clararodellar/TFG/Electronica_potencia/README.md

# ELECTRÓNICA DE POTENCIA

* **PCB**: tiene los archivos necesarios para poder abrir el diseño de la PCB del puente en H en Eagle.

* **ensayos_motor**: tiene los datos sobre los ensayos realizados al motor para ver la corriente que consume en función de la tensión y de la carga.

* **sensor_encoder_lineal**: incluye los componentes necesarios y páginas donde mirar cómo montar un encoder lineal.

* **CÓMO SABER SI UN TRANSISTOR ESTÁ DAÑADO**: son instrucciones con imagenes para comprobar si un transistor se ha dañado.

Páginas para entender control de puente en H:

[http://panamahitek.com/puente-h-con-control-de-velocidad-por-arduino/](http://panamahitek.com/puente-h-con-control-de-velocidad-por-arduino/)

[http://panamahitek.com/el-puente-h-invirtiendo-el-sentido-de-giro-de-un-motor-con-arduino/](http://panamahitek.com/el-puente-h-invirtiendo-el-sentido-de-giro-de-un-motor-con-arduino/)

Circuito con optoacoplador para relé y mosfet:

[http://www.bristolwatch.com/ele2/mosfet_relay.htm](http://www.bristolwatch.com/ele2/mosfet_relay.htm)
