clararodellar/TFG/Mecanica/README.md

# Parte mecánica

En esta carpeta se incluye todo lo que tiene que ver con la parte mecánica del proyecto.

* **FreeCAD**: en esta carpeta están los archivos .FCStd que se abren con la herramienta de FreeCAD

* **stl**: piezas en extensión .stl para poder imprimirlas

* **tornillo_DIN912**: word con las medidas de estos tornillos (con los que se ha trabajado la pieza Agarradera_eje_fijo_10)
