clararodellar/TFG/Electronica_control/Codigos/README.md

# CÓDIGOS

Dado que vamos a comparar el control con un Arduino y con una FPGA, están los códigos de cada uno de ellos en las carpetas.
