clararodellar/TFG/Mecanica/stl/README.md

# Piezas para imprimirlas en .stl

* **agarradera_8_abajo**: pieza usada para sujetar el tambor de reenvío en el extremo donde se encuentra el engranaje. Tiene un diámetro de 8 mm, los taladros un diámetro de 3 mm y se trabaja con una tolerancia de 0,8 mm.Es la pieza de abajo.

* **agarradera_8_arriba**: pieza usada para sujetar el tambor de reenvío en el extremo donde se encuentra el engranaje. Tiene un diámetro de 8 mm, los taladros un diámetro de 3 mm y se trabaja con una tolerancia de 0,8 mm. Es la pieza de arriba.

* **agarradera_movil_6_v01**: Esta pieza está diseñada para soportar un eje de diámetro 6 mm con una tolerancia de 0,4 mm de manera que el eje sí pueda girar. Esta pieza se rediseñará como agarradera_8.

* **agarradera_movil_6_v02**: Es la misma pieza que la anterior. La diferencia reside en que el hueco dejado para meter el eje se ha hecho mayor porque en la anterior no entraba bien.

* **agarradera_movil_6_v03**: Volvemos a tener una mejora de la pieza después de probar la anterior. En este caso hemos aumentado la tolerancia tanto de los taladros como del agujero para el eje a 0,8. Además, dado que se ha cambiado el agarre del otro extremo del eje, ahora necesitamos que la pieza tenga mayor altura: 12 mm más,por lo que se le ha añadido un bloque por debajo.

* **agarre_motor**: Esta pieza se diseñó para soportar los extremos libres de los ejes. Pero esto no fijaba el eje sino que permitía el movimiento en el eje de giro. Se diseña la pieza agarradera_movil_6.

* **base_agarradera_movil_03**: Como tenemos dos ejes necesitamos dos piezas de agarradera_movil_6. Dado que la pieza agarradera_movil_6_v02 ya está impresa y puede utilizarse, la aprovecharemos y sólo añadiremos el resalte que necesita para alcanzar la altura y que el eje quede paralelo al suelo.
