clararodellar/TFG/Mecanica/FreeCAD/README.md

# Aquí están las piezas necesarias para el TFG en FCStd

* **agarradera_8**: pieza usada para sujetar el tambor de reenvío en el extremo donde se encuentra el engranaje. Tiene un diámetro de 8 mm, los taladros un diámetro de 3 mm y se trabaja con una tolerancia de 0,8 mm.

* **agarradera_eje_fijo_10**: Esta pieza está diseñada para poder soportar el conjunto de motor y encoder óptico extraídos de la impresora hp deskjet 845c sobre los perfiles de aluminio. Tiene un diámetro de 10 mm con tolerancia 0,4 mm. Los agujeros de los tornillos están preparados para encajar un tornillo tipo DIN912 inluyendo la cabeza.Después de probarla hemos visto una disposición mejor para sujetar el extremo del eje donde va colocado el motor que no necesita pieza.

* **agarre_motor**: Esta pieza se diseñó para soportar los extremos libres de los ejes. Pero esto no fijaba el eje sino que permitía el movimiento en el eje de giro. Se diseña la pieza agarradera_movil_6.

* **agarradera_movil_6_v01**: Esta pieza está diseñada para soportar un eje de diámetro 6 mm con una tolerancia de 0,4 mm de manera que el eje sí pueda girar.

* **agarradera_movil_6_v02**: Es la misma pieza que la anterior. La diferencia reside en que el hueco dejado para meter el eje se ha hecho mayor porque en la anterior no entraba bien.

* **agarradera_movil_6_v03**: Volvemos a tener una mejora de la pieza después de probar la anterior. En este caso hemos aumentado la tolerancia tanto de los taladros como del agujero para el eje a 0,8. Además, dado que se ha cambiado el agarre del otro extremo del eje, ahora necesitamos que la pieza tenga mayor altura: 12 mm más,por lo que se le ha añadido un bloque por debajo. En este fichero está incluido el resalte necesario para el aprovechamiento de la impresión de agarradera_movil_6_v02 ya que necesitamos la pieza por duplicado.

* **prueba_planos**: es una prueba para sacar planos de piezas en FreeCAD
