clararodellar/TFG/Cinta_transportadora/Codigo2/README.md

En esta carpeta están escritos los códigos usados para controlar el montaje.

* motor: controla el encendido y apagado de un motor de corriente continua

* motor_potenciometro: controla la velocidad de un motor a través de un potenciómetro

* motor_puenteH: controla el sentido de giro de un motor por el montaje de puente en H a través de un botón y la velocidad a la que gira a través de un potenciómetro.

Páginas para entender control de puente en H:

[http://panamahitek.com/puente-h-con-control-de-velocidad-por-arduino/](http://panamahitek.com/puente-h-con-control-de-velocidad-por-arduino/)

[http://panamahitek.com/el-puente-h-invirtiendo-el-sentido-de-giro-de-un-motor-con-arduino/](http://panamahitek.com/el-puente-h-invirtiendo-el-sentido-de-giro-de-un-motor-con-arduino/)

* senal_analogica_a_digital: transforma una señal analógica de entrada a una señal digital. Está pensado para el encoder que se encontró en la impresora
