clararodellar/TFG/Cinta_transportadora/Informacion2/README.md

En esta carpeta se recogerá todo tipo de información que se crea necesaria para el trabajo.

Optical_rotary_encoder: dado que busco programar el encoder óptico de una impresora HP Deskjet 845c, en este word hay información copiada de distintas páginas y las páginas de las que se ha sacado sobre gente que ha hecho esto y sus recomendaciones.

Tornillo DIN-912: medidas de estos tornillos (con los que se ha trabajado la pieza Agarradera_eje_fijo_10)

Encoder: información encontrada en un foro sobre el encoder.

---

Circuito con optoacoplador para relé y mosfet:
http://www.bristolwatch.com/ele2/mosfet_relay.htm
