clararodellar/TFG/Cinta_transportadora/Motor2/Conexion_puenteH/README.md

# CIRCUITO DE CONEXION DEL MOTOR CON PUENTE EN H

Para desarrollar el circuito con puente en H nos hemos basado en el siguiente circuito:

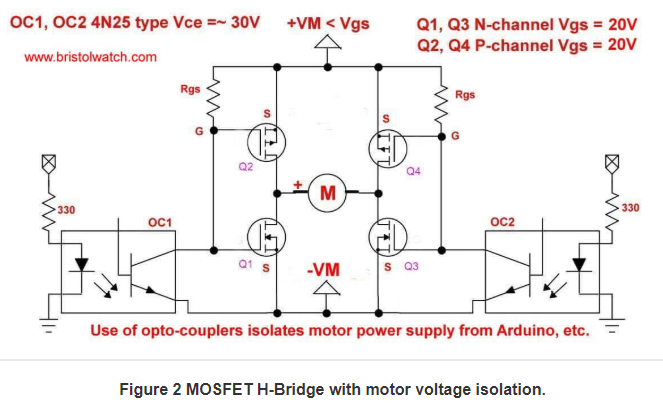
[picture p1: Motor/Conexion_puenteH/conexion_puenteH.PNG]


Quedandonos el siguiente esquema:

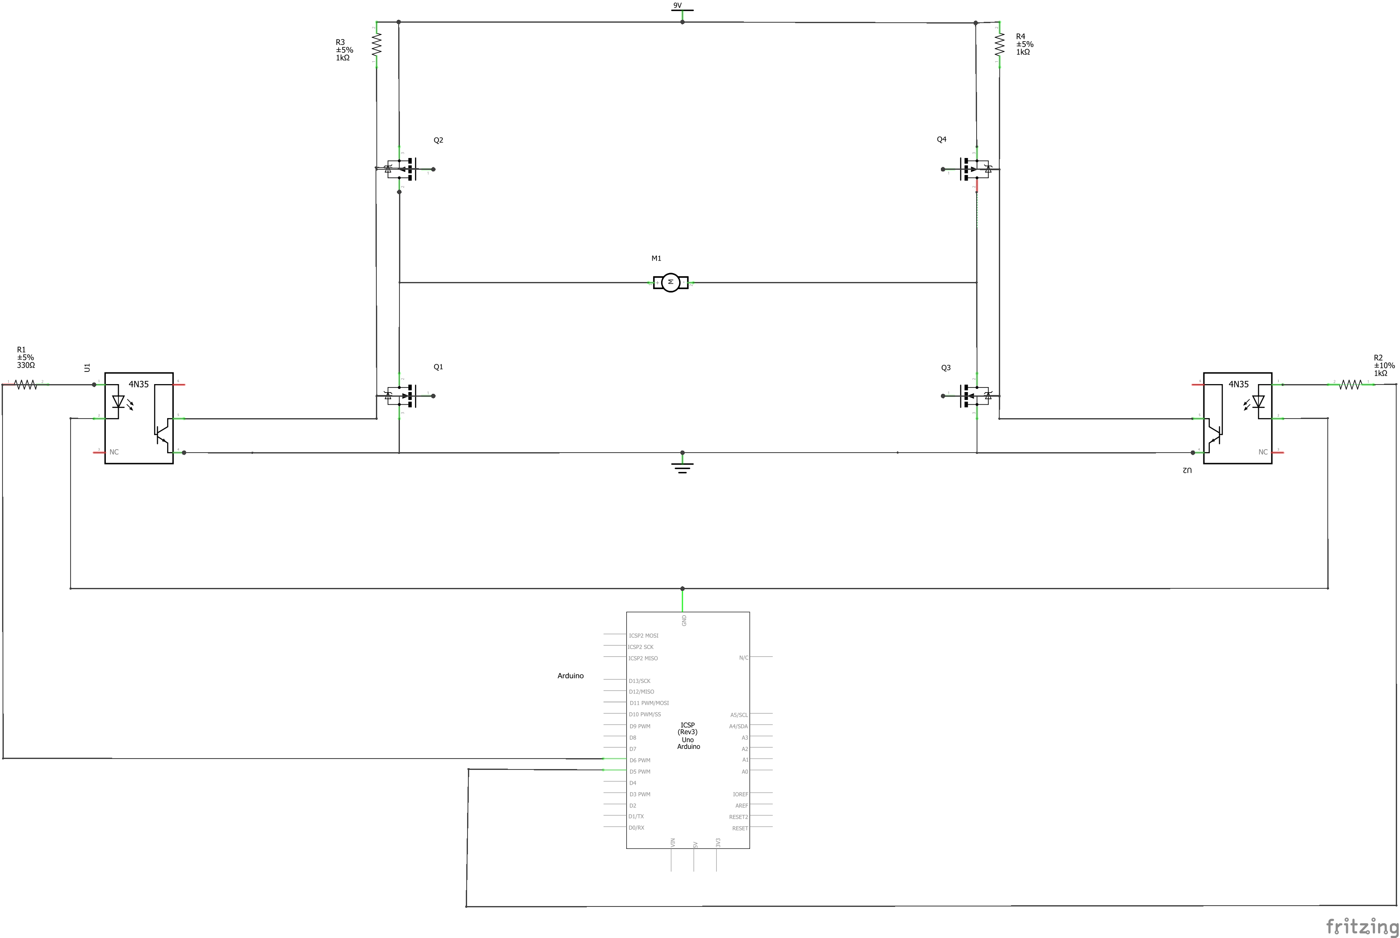
[picture p2: Motor/Conexion_puenteH/esquema_motor_puenteH_v02_esquemático.png]


De la página:

[http://www.bristolwatch.com/ele/h_bridge.htm](http://www.bristolwatch.com/ele/h_bridge.htm)

## Elementos:

* 2 optocopladores tipo 4N35
* 2 transistores irlb8721 canal n (los que se colocan abajo)
* 2 transistores fqp27p06 canal p (los que se colocan arriba)
* Motor reciclado de impresora hp dekjet 845
* Placa de arduino UNO
* Resistencias (330 ohmios, 10000 ohmios??)
* Diodo IN4001?
* Fuente de tensión de corriente continua de 12V?

Otras páginas de interés con otros circuitos y que hablan de los puentes en H son:

[http://www.circuitstoday.com/h-bridge-motor-control-circuit-using-l298](http://www.circuitstoday.com/h-bridge-motor-control-circuit-using-l298)
[https://www.prometec.net/hbridge/](https://www.prometec.net/hbridge/)
