clararodellar/TFG/Cinta_transportadora/Motor2/Conexion_potenciometro/README.md

 
# CIRCUITO DE CONEXION DEL MOTOR CON POTENCIÓMETRO

Este modelo no está probado. El modelo esta hecho con Fritzing

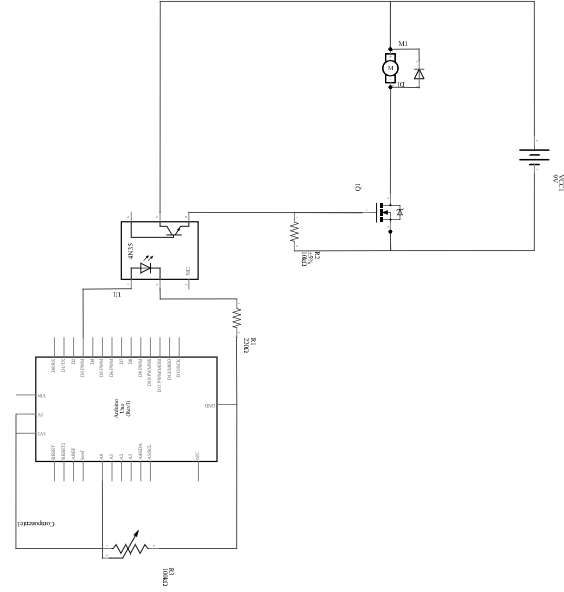
[picture p4: Motor/Conexion_potenciometro/esquema_motor_potenciometro.png]
imagen


## Elementos:
* Octoacoplador 4N35
* Transistor irlb8721
* Motor reciclado de impresora hp dekjet 845
* Placa de arduino UNO
* Diodo IN4001
* Fuente de tensión de corriente continua de 12V
* Resistencias (220 ohmios,10000 ohmios)
* Potenciometro

Consta de un motor reciclado de una impresora. A este se le conecta un diodo con el cátodo en el borne positivo para que durante el funcionamiento no le pase corriente y cuando se desconecte el motor podrá descargarse con el diodo. El uso del octoacoplador es para aislar eléctricamente el circuito de mando y el de potencia externa. El uso del transistor es para alcanzar la potencia necesaria que Arduino no es capaz de suministrar. Con el potenciometro y el codigo adecuado de Arduino sirve para controlar la velocidad del motor.
