clararodellar/TFG/Cinta_transportadora/Motor22/Ensayos_motor/README.md

# Ensayos al motor

* Ensayo de rotor libre o de vacío:

    * A 5 V : I = 0,15 A
    * A 12 V : I = 0,2 A

* Ensayo con carga:

    * A 5 V : I = 0,8 A

* Ensayo de rotor bloqueado:

    * A 12 V : I = 1,6 A
