clararodellar/TFG/Memoria/README.md

* **TFG_Clara_Rodellar_ITI**: en este archivo se tiene la memoria de este TFG donde está explicada la solución técnica y las conclusiones del trabajo.
