clararodellar/TFG/Mecanica/tornillo_DIN912.docx

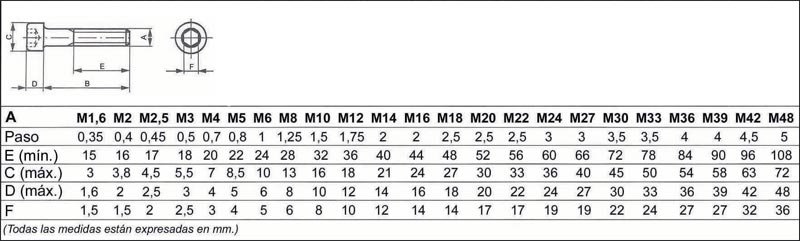
[picture p64: figure]
Resultado de imagen de din 912 dimensiones
