clararodellar/TFG/Electronica_control/Codigos/FPGA/motor_lazo_abierto/juntar_summary.html

juntar Project Status (09/11/2019 - 18:27:44)
Project File: | motor_lazo_abierto.xise | Parser Errors: | No Errors
Module Name: | juntar | Implementation State: | Programming File Generated
Target Device: | xc3s100e-4tq144 | Errors: | No Errors
Product Version: | ISE 14.7 | Warnings: | No Warnings
Design Goal: | Balanced | Routing Results: | All Signals Completely Routed
Design Strategy: | Xilinx Default (unlocked) | Timing Constraints: | All Constraints Met
Environment: | System Settings | Final Timing Score: | 0 (Timing Report)

Device Utilization Summary | | | | | [-]
Logic Utilization | Used | Available | Utilization | Note(s)
Number of Slice Flip Flops | 127 | 1,920 | 6%
Number of 4 input LUTs | 220 | 1,920 | 11%
Number of occupied Slices | 171 | 960 | 17%
Number of Slices containing only related logic | 171 | 171 | 100%
Number of Slices containing unrelated logic | 0 | 171 | 0%
Total Number of 4 input LUTs | 316 | 1,920 | 16%
Number used as logic | 220
Number used as a route-thru | 96
Number of bonded IOBs | 23 | 108 | 21%
IOB Flip Flops | 1
Number of BUFGMUXs | 1 | 24 | 4%
Average Fanout of Non-Clock Nets | 2.88

Performance Summary | | | | [-]
Final Timing Score: | 0 (Setup: 0, Hold: 0) | Pinout Data: | Pinout Report
Routing Results: | All Signals Completely Routed | Clock Data: | Clock Report
Timing Constraints: | All Constraints Met

Detailed Reports | | | | | | [-]
Report Name | Status | Generated | Errors | Warnings | Infos
Synthesis Report | Current | mi. 11. sep. 18:27:15 2019 | 0 | 0 | 1 Info (1 new)
Translation Report | Current | mi. 11. sep. 18:27:20 2019 | 0 | 0 | 0
Map Report | Current | mi. 11. sep. 18:27:25 2019 | 0 | 0 | 2 Infos (2 new)
Place and Route Report | Current | mi. 11. sep. 18:27:34 2019 | 0 | 0 | 2 Infos (2 new)
Power Report
Post-PAR Static Timing Report | Current | mi. 11. sep. 18:27:37 2019 | 0 | 0 | 6 Infos (6 new)
Bitgen Report | Current | mi. 11. sep. 18:27:42 2019 | 0 | 0 | 0

Secondary Reports | | | [-]
Report Name | Status | Generated
WebTalk Report | Current | mi. 11. sep. 18:27:43 2019
WebTalk Log File | Current | mi. 11. sep. 18:27:44 2019

Date Generated: 09/11/2019 - 18:27:44
