clararodellar/TFG/Electronica_control/Codigos/FPGA/motor_lazo_abierto/juntar_envsettings.html

System Settings

Environment Settings
Environment Variable | xst | ngdbuild | map | par
PATHEXT | .COM; .EXE; .BAT; .CMD; .VBS; .VBE; .JS; .JSE; .WSF; .WSH; .MSC | .COM; .EXE; .BAT; .CMD; .VBS; .VBE; .JS; .JSE; .WSF; .WSH; .MSC | .COM; .EXE; .BAT; .CMD; .VBS; .VBE; .JS; .JSE; .WSF; .WSH; .MSC | .COM; .EXE; .BAT; .CMD; .VBS; .VBE; .JS; .JSE; .WSF; .WSH; .MSC

Path

C:\Xilinx\14.7\ISE_DS\ISE\\lib\nt64;
C:\Xilinx\14.7\ISE_DS\ISE\\bin\nt64;
C:\Xilinx\14.7\ISE_DS\ISE\bin\nt64;
C:\Xilinx\14.7\ISE_DS\ISE\lib\nt64;
C:\Xilinx\14.7\ISE_DS\ISE\..\..\..\DocNav;
C:\Xilinx\14.7\ISE_DS\PlanAhead\bin;
C:\Xilinx\14.7\ISE_DS\EDK\bin\nt64;
C:\Xilinx\14.7\ISE_DS\EDK\lib\nt64;
C:\Xilinx\14.7\ISE_DS\EDK\gnu\microblaze\nt\bin;
C:\Xilinx\14.7\ISE_DS\EDK\gnu\powerpc-eabi\nt\bin;
C:\Xilinx\14.7\ISE_DS\EDK\gnuwin\bin;
C:\Xilinx\14.7\ISE_DS\EDK\gnu\arm\nt\bin;
C:\Xilinx\14.7\ISE_DS\EDK\gnu\microblaze\linux_toolchain\nt64_be\bin;
C:\Xilinx\14.7\ISE_DS\EDK\gnu\microblaze\linux_toolchain\nt64_le\bin;
C:\Xilinx\14.7\ISE_DS\common\bin\nt64;
C:\Xilinx\14.7\ISE_DS\common\lib\nt64;
C:\Program Files (x86)\NVIDIA Corporation\PhysX\Common;
C:\Program Files (x86)\Intel\iCLS Client\;
C:\Program Files\Intel\iCLS Client\;
C:\WINDOWS\system32;
C:\WINDOWS;
C:\WINDOWS\System32\Wbem;
C:\WINDOWS\System32\WindowsPowerShell\v1.0\;
C:\Program Files\Intel\Intel(R) Management Engine Components\DAL;
C:\Program Files\Intel\Intel(R) Management Engine Components\IPT;
C:\Program Files (x86)\Intel\Intel(R) Management Engine Components\DAL;
C:\Program Files (x86)\Intel\Intel(R) Management Engine Components\IPT;
C:\WINDOWS\System32\OpenSSH\;
C:\Program Files\Git\cmd;
C:\Users\Clara\AppData\Local\Microsoft\WindowsApps

C:\Xilinx\14.7\ISE_DS\ISE\\lib\nt64;
C:\Xilinx\14.7\ISE_DS\ISE\\bin\nt64;
C:\Xilinx\14.7\ISE_DS\ISE\bin\nt64;
C:\Xilinx\14.7\ISE_DS\ISE\lib\nt64;
C:\Xilinx\14.7\ISE_DS\ISE\..\..\..\DocNav;
C:\Xilinx\14.7\ISE_DS\PlanAhead\bin;
C:\Xilinx\14.7\ISE_DS\EDK\bin\nt64;
C:\Xilinx\14.7\ISE_DS\EDK\lib\nt64;
C:\Xilinx\14.7\ISE_DS\EDK\gnu\microblaze\nt\bin;
C:\Xilinx\14.7\ISE_DS\EDK\gnu\powerpc-eabi\nt\bin;
C:\Xilinx\14.7\ISE_DS\EDK\gnuwin\bin;
C:\Xilinx\14.7\ISE_DS\EDK\gnu\arm\nt\bin;
C:\Xilinx\14.7\ISE_DS\EDK\gnu\microblaze\linux_toolchain\nt64_be\bin;
C:\Xilinx\14.7\ISE_DS\EDK\gnu\microblaze\linux_toolchain\nt64_le\bin;
C:\Xilinx\14.7\ISE_DS\common\bin\nt64;
C:\Xilinx\14.7\ISE_DS\common\lib\nt64;
C:\Program Files (x86)\NVIDIA Corporation\PhysX\Common;
C:\Program Files (x86)\Intel\iCLS Client\;
C:\Program Files\Intel\iCLS Client\;
C:\WINDOWS\system32;
C:\WINDOWS;
C:\WINDOWS\System32\Wbem;
C:\WINDOWS\System32\WindowsPowerShell\v1.0\;
C:\Program Files\Intel\Intel(R) Management Engine Components\DAL;
C:\Program Files\Intel\Intel(R) Management Engine Components\IPT;
C:\Program Files (x86)\Intel\Intel(R) Management Engine Components\DAL;
C:\Program Files (x86)\Intel\Intel(R) Management Engine Components\IPT;
C:\WINDOWS\System32\OpenSSH\;
C:\Program Files\Git\cmd;
C:\Users\Clara\AppData\Local\Microsoft\WindowsApps

C:\Xilinx\14.7\ISE_DS\ISE\\lib\nt64;
C:\Xilinx\14.7\ISE_DS\ISE\\bin\nt64;
C:\Xilinx\14.7\ISE_DS\ISE\bin\nt64;
C:\Xilinx\14.7\ISE_DS\ISE\lib\nt64;
C:\Xilinx\14.7\ISE_DS\ISE\..\..\..\DocNav;
C:\Xilinx\14.7\ISE_DS\PlanAhead\bin;
C:\Xilinx\14.7\ISE_DS\EDK\bin\nt64;
C:\Xilinx\14.7\ISE_DS\EDK\lib\nt64;
C:\Xilinx\14.7\ISE_DS\EDK\gnu\microblaze\nt\bin;
C:\Xilinx\14.7\ISE_DS\EDK\gnu\powerpc-eabi\nt\bin;
C:\Xilinx\14.7\ISE_DS\EDK\gnuwin\bin;
C:\Xilinx\14.7\ISE_DS\EDK\gnu\arm\nt\bin;
C:\Xilinx\14.7\ISE_DS\EDK\gnu\microblaze\linux_toolchain\nt64_be\bin;
C:\Xilinx\14.7\ISE_DS\EDK\gnu\microblaze\linux_toolchain\nt64_le\bin;
C:\Xilinx\14.7\ISE_DS\common\bin\nt64;
C:\Xilinx\14.7\ISE_DS\common\lib\nt64;
C:\Program Files (x86)\NVIDIA Corporation\PhysX\Common;
C:\Program Files (x86)\Intel\iCLS Client\;
C:\Program Files\Intel\iCLS Client\;
C:\WINDOWS\system32;
C:\WINDOWS;
C:\WINDOWS\System32\Wbem;
C:\WINDOWS\System32\WindowsPowerShell\v1.0\;
C:\Program Files\Intel\Intel(R) Management Engine Components\DAL;
C:\Program Files\Intel\Intel(R) Management Engine Components\IPT;
C:\Program Files (x86)\Intel\Intel(R) Management Engine Components\DAL;
C:\Program Files (x86)\Intel\Intel(R) Management Engine Components\IPT;
C:\WINDOWS\System32\OpenSSH\;
C:\Program Files\Git\cmd;
C:\Users\Clara\AppData\Local\Microsoft\WindowsApps

C:\Xilinx\14.7\ISE_DS\ISE\\lib\nt64;
C:\Xilinx\14.7\ISE_DS\ISE\\bin\nt64;
C:\Xilinx\14.7\ISE_DS\ISE\bin\nt64;
C:\Xilinx\14.7\ISE_DS\ISE\lib\nt64;
C:\Xilinx\14.7\ISE_DS\ISE\..\..\..\DocNav;
C:\Xilinx\14.7\ISE_DS\PlanAhead\bin;
C:\Xilinx\14.7\ISE_DS\EDK\bin\nt64;
C:\Xilinx\14.7\ISE_DS\EDK\lib\nt64;
C:\Xilinx\14.7\ISE_DS\EDK\gnu\microblaze\nt\bin;
C:\Xilinx\14.7\ISE_DS\EDK\gnu\powerpc-eabi\nt\bin;
C:\Xilinx\14.7\ISE_DS\EDK\gnuwin\bin;
C:\Xilinx\14.7\ISE_DS\EDK\gnu\arm\nt\bin;
C:\Xilinx\14.7\ISE_DS\EDK\gnu\microblaze\linux_toolchain\nt64_be\bin;
C:\Xilinx\14.7\ISE_DS\EDK\gnu\microblaze\linux_toolchain\nt64_le\bin;
C:\Xilinx\14.7\ISE_DS\common\bin\nt64;
C:\Xilinx\14.7\ISE_DS\common\lib\nt64;
C:\Program Files (x86)\NVIDIA Corporation\PhysX\Common;
C:\Program Files (x86)\Intel\iCLS Client\;
C:\Program Files\Intel\iCLS Client\;
C:\WINDOWS\system32;
C:\WINDOWS;
C:\WINDOWS\System32\Wbem;
C:\WINDOWS\System32\WindowsPowerShell\v1.0\;
C:\Program Files\Intel\Intel(R) Management Engine Components\DAL;
C:\Program Files\Intel\Intel(R) Management Engine Components\IPT;
C:\Program Files (x86)\Intel\Intel(R) Management Engine Components\DAL;
C:\Program Files (x86)\Intel\Intel(R) Management Engine Components\IPT;
C:\WINDOWS\System32\OpenSSH\;
C:\Program Files\Git\cmd;
C:\Users\Clara\AppData\Local\Microsoft\WindowsApps
XILINX | C:\Xilinx\14.7\ISE_DS\ISE\ | C:\Xilinx\14.7\ISE_DS\ISE\ | C:\Xilinx\14.7\ISE_DS\ISE\ | C:\Xilinx\14.7\ISE_DS\ISE\
XILINX_DSP | C:\Xilinx\14.7\ISE_DS\ISE | C:\Xilinx\14.7\ISE_DS\ISE | C:\Xilinx\14.7\ISE_DS\ISE | C:\Xilinx\14.7\ISE_DS\ISE
XILINX_EDK | C:\Xilinx\14.7\ISE_DS\EDK | C:\Xilinx\14.7\ISE_DS\EDK | C:\Xilinx\14.7\ISE_DS\EDK | C:\Xilinx\14.7\ISE_DS\EDK
XILINX_PLANAHEAD | C:\Xilinx\14.7\ISE_DS\PlanAhead | C:\Xilinx\14.7\ISE_DS\PlanAhead | C:\Xilinx\14.7\ISE_DS\PlanAhead | C:\Xilinx\14.7\ISE_DS\PlanAhead

Synthesis Property Settings
Switch Name | Property Name | Value | Default Value
-ifn | | juntar.prj
-ifmt | | mixed | MIXED
-ofn | | juntar
-ofmt | | NGC | NGC
-p | | xc3s100e-4-tq144
-top | | juntar
-opt_mode | Optimization Goal | Speed | SPEED
-opt_level | Optimization Effort | 1 | 1
-iuc | Use synthesis Constraints File | NO | NO
-keep_hierarchy | Keep Hierarchy | No | NO
-netlist_hierarchy | Netlist Hierarchy | As_Optimized | as_optimized
-rtlview | Generate RTL Schematic | Yes | NO
-glob_opt | Global Optimization Goal | AllClockNets | ALLCLOCKNETS
-read_cores | Read Cores | YES | YES
-write_timing_constraints | Write Timing Constraints | NO | NO
-cross_clock_analysis | Cross Clock Analysis | NO | NO
-bus_delimiter | Bus Delimiter | <> | <>
-slice_utilization_ratio | Slice Utilization Ratio | 100 | 100%
-bram_utilization_ratio | BRAM Utilization Ratio | 100 | 100%
-verilog2001 | Verilog 2001 | YES | YES
-fsm_extract | | YES | YES
-fsm_encoding | | Auto | AUTO
-safe_implementation | | No | NO
-fsm_style | | LUT | LUT
-ram_extract | | Yes | YES
-ram_style | | Auto | AUTO
-rom_extract | | Yes | YES
-shreg_extract | | YES | YES
-rom_style | | Auto | AUTO
-auto_bram_packing | | NO | NO
-resource_sharing | | YES | YES
-async_to_sync | | NO | NO
-mult_style | | Auto | AUTO
-iobuf | | YES | YES
-max_fanout | | 500 | 500
-bufg | | 24 | 24
-register_duplication | | YES | YES
-register_balancing | | No | NO
-optimize_primitives | | NO | NO
-use_clock_enable | | Yes | YES
-use_sync_set | | Yes | YES
-use_sync_reset | | Yes | YES
-iob | | Auto | AUTO
-equivalent_register_removal | | YES | YES
-slice_utilization_ratio_maxmargin | | 5 | 0%

Translation Property Settings
Switch Name | Property Name | Value | Default Value
-intstyle | | ise | None
-dd | | _ngo | None
-p | | xc3s100e-tq144-4 | None
-uc | | BasysRevEGeneralYo.ucf | None

Map Property Settings
Switch Name | Property Name | Value | Default Value
-ir | Use RLOC Constraints | OFF | OFF
-cm | Optimization Strategy (Cover Mode) | area | area
-intstyle | | ise | None
-o | | juntar_map.ncd | None
-pr | Pack I/O Registers/Latches into IOBs | off | off
-p | | xc3s100e-tq144-4 | None

Place and Route Property Settings
Switch Name | Property Name | Value | Default Value
-t | | 1 | 1
-intstyle | | ise
-ol | Place & Route Effort Level (Overall) | high | std
-w | | true | false

Operating System Information
Operating System Information | xst | ngdbuild | map | par
CPU Architecture/Speed | Intel(R) Core(TM) i7-4510U CPU @ 2.00GHz/2594 MHz | Intel(R) Core(TM) i7-4510U CPU @ 2.00GHz/2594 MHz | Intel(R) Core(TM) i7-4510U CPU @ 2.00GHz/2594 MHz | Intel(R) Core(TM) i7-4510U CPU @ 2.00GHz/2594 MHz
Host | CLARA | CLARA | CLARA | CLARA
OS Name | Microsoft , 64-bit | Microsoft , 64-bit | Microsoft , 64-bit | Microsoft , 64-bit
OS Release | major release (build 9200) | major release (build 9200) | major release (build 9200) | major release (build 9200)
