clararodellar/TFG/Materiales_fotos/README.md

En esta carpeta se colgarán fotos del trabajo. Entre ellas habrá fotos del montaje y de los componentes usados para saber cuáles son.

El enconder es: 09845 0127

El motor: C6409-60004 (RN951524)
