clararodellar/TFG/Cinta_transportadora/Materiales_fotos2/20180731_130929.jpg

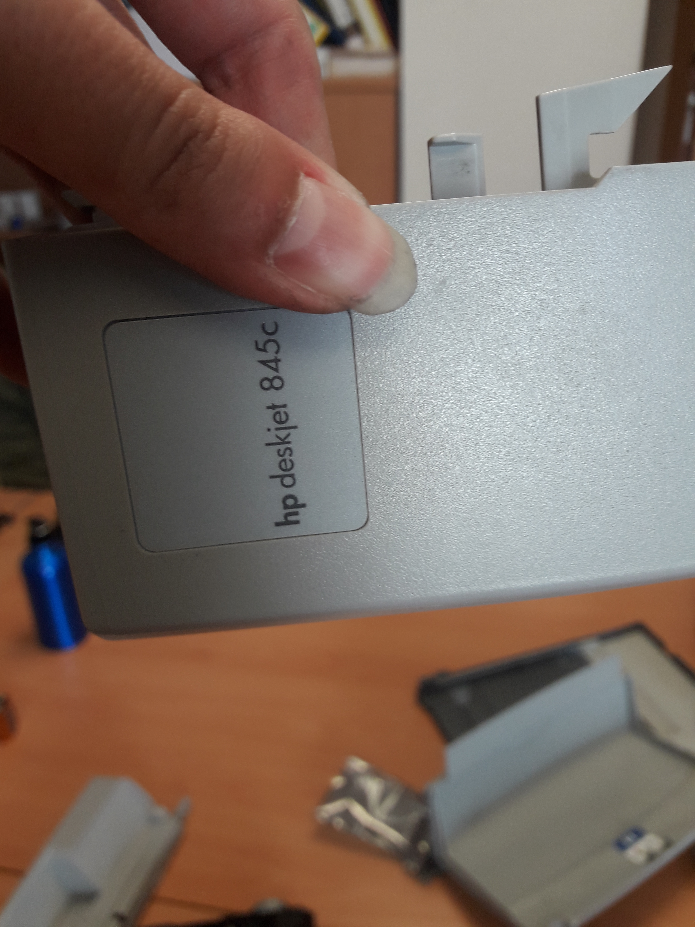
Cinta_transportadora/Materiales_fotos2/20180731_130929.jpg
