clararodellar/TFG/Cinta_transportadora/Materiales_fotos2/20180731_130935.jpg

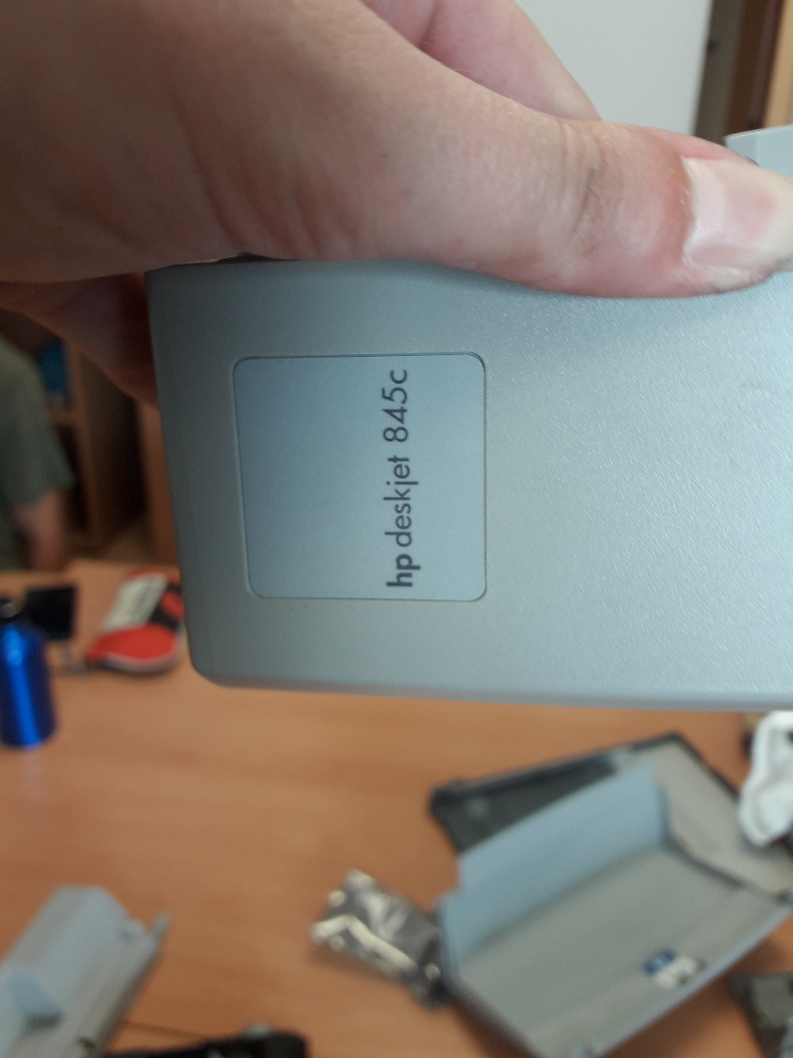
Cinta_transportadora/Materiales_fotos2/20180731_130935.jpg
