clararodellar/TFG/Cinta_transportadora/Materiales_fotos2/20180731_131208.jpg

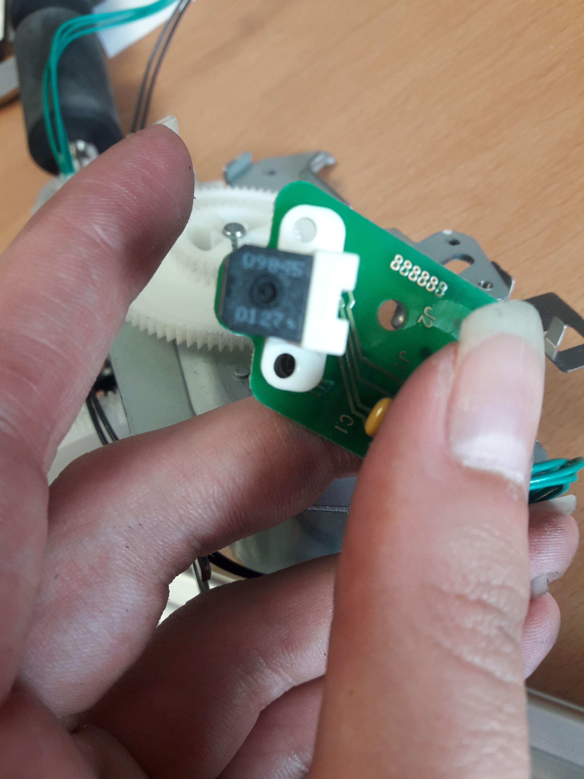
Cinta_transportadora/Materiales_fotos2/20180731_131208.jpg
