clararodellar/TFG/Cinta_transportadora/Materiales_fotos2/20180731_131211.jpg

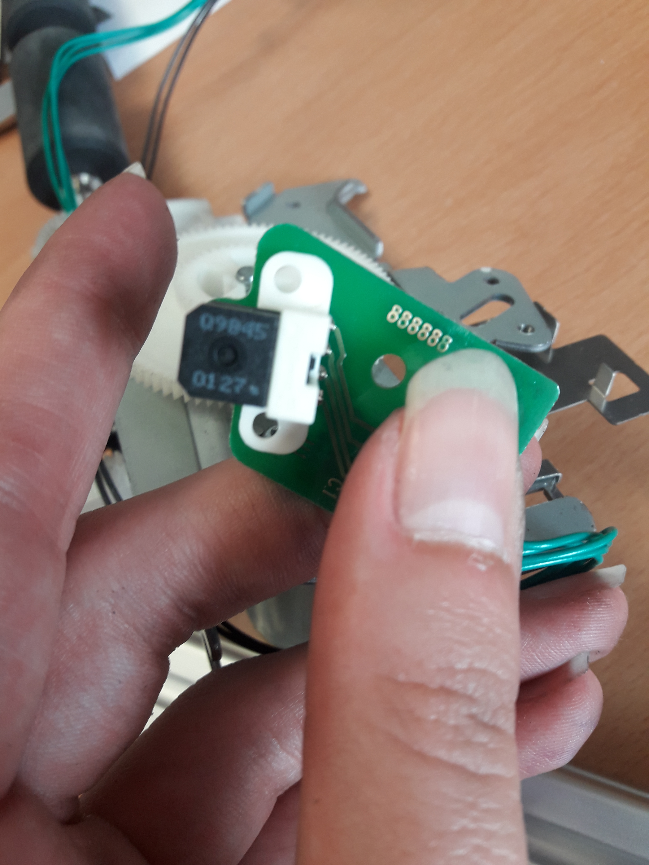
Cinta_transportadora/Materiales_fotos2/20180731_131211.jpg
