clararodellar/TFG/Cinta_transportadora/Materiales_fotos2/20180925_154054.jpg

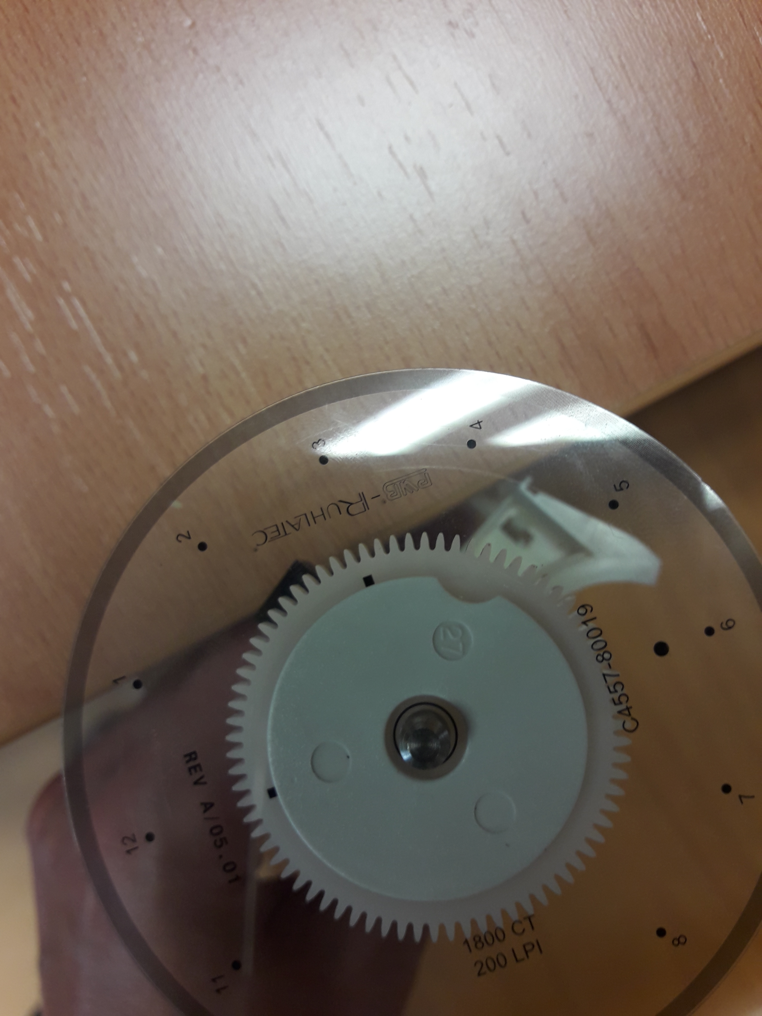
Cinta_transportadora/Materiales_fotos2/20180925_154054.jpg
