clararodellar/TFG/Cinta_transportadora/Materiales_fotos2/20180927_154230.jpg

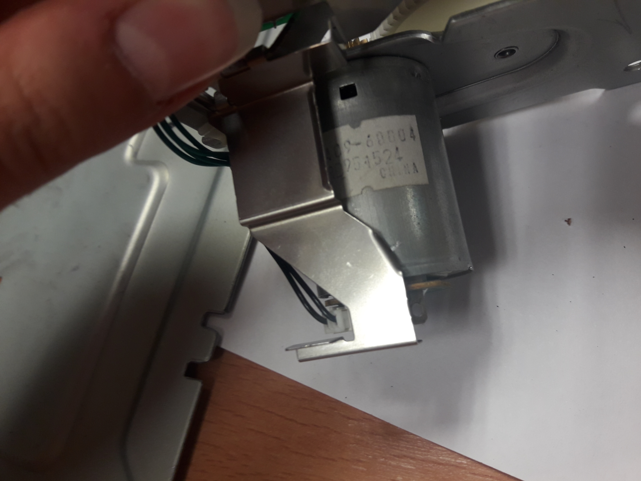
Cinta_transportadora/Materiales_fotos2/20180927_154230.jpg
