clararodellar/TFG/Cinta_transportadora/Materiales_fotos2/20180927_155044.jpg

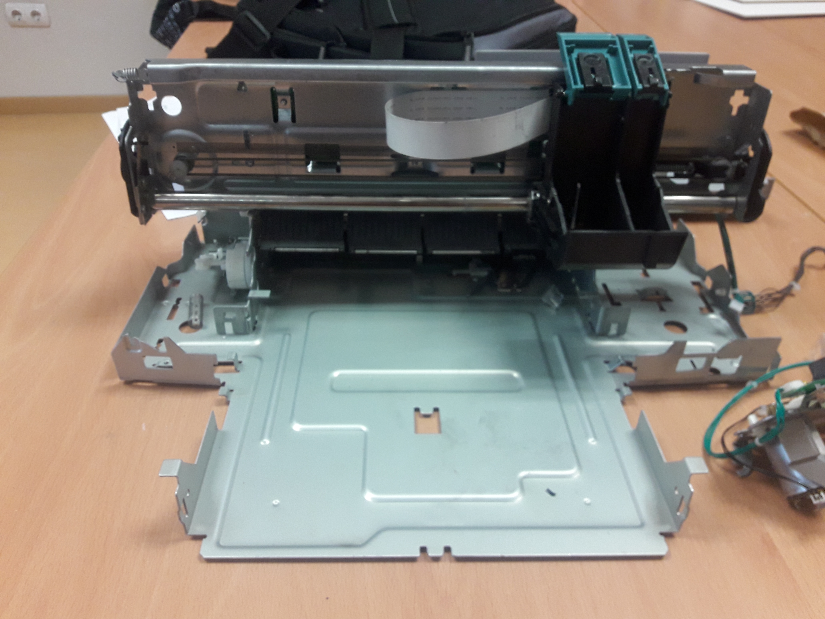
Cinta_transportadora/Materiales_fotos2/20180927_155044.jpg
