clararodellar/TFG/Mecanica/FreeCAD/agarradera_movil_6_v03.FCStd

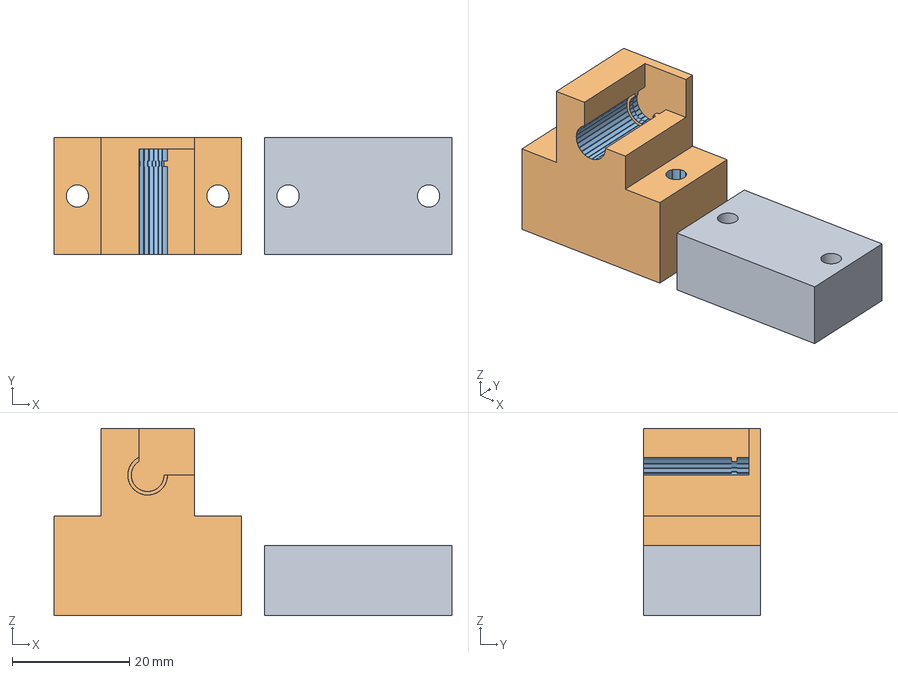
[picture p76: CAD file, 2019-10-11]
Mecanica/FreeCAD/agarradera_movil_6_v03.FCStd
68.0 x 20.0 x 32.0 mm
Base_taladro_2
Pieza_altura
agarradera_movil_v03
