clararodellar/TFG/Mecanica/stl/agarradera_8_abajo.stl

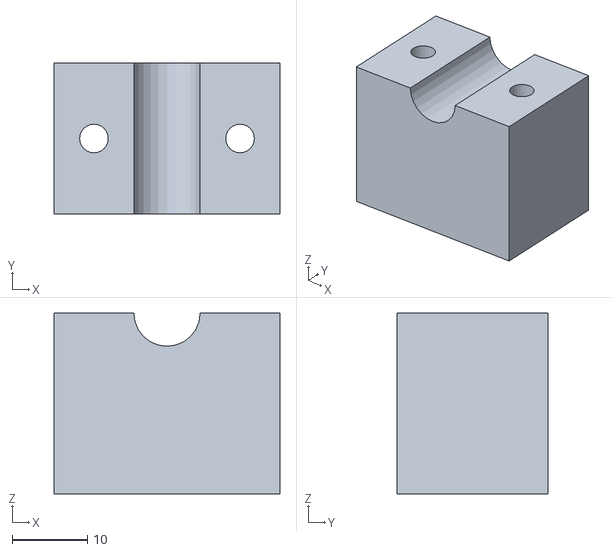
[picture p77: CAD file, 2018-11-26]
Mecanica/stl/agarradera_8_abajo.stl
30.0 x 20.0 x 24.0
