clararodellar/TFG/Mecanica/FreeCAD/agarradera_eje_fijo_10.FCStd

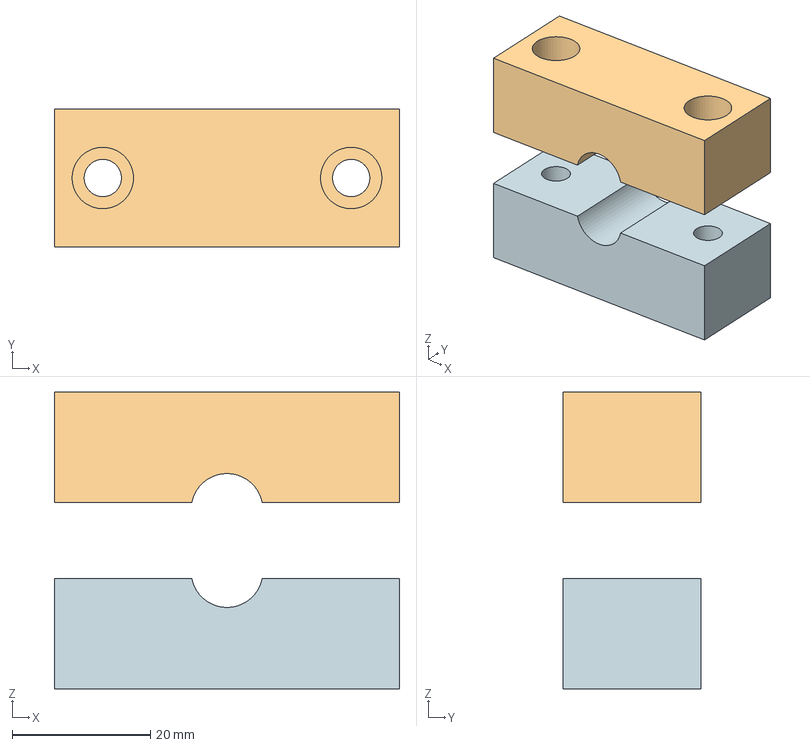
[picture p78: CAD file, 2019-09-15]
Mecanica/FreeCAD/agarradera_eje_fijo_10.FCStd
50.0 x 20.0 x 43.0 mm
Pieza_arriba
Pieza_abajo
