clararodellar/TFG/Mecanica/stl/agarradera_8_arriba.stl

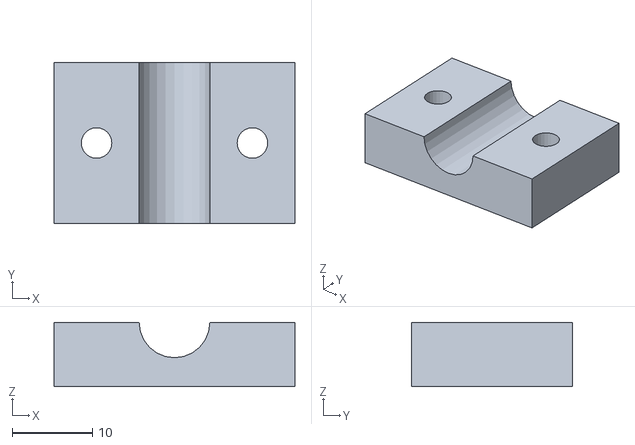
[picture p79: CAD file, 2018-11-26]
Mecanica/stl/agarradera_8_arriba.stl
30.0 x 20.0 x 8.00
