clararodellar/TFG/Mecanica/FreeCAD/agarre_motor.FCStd

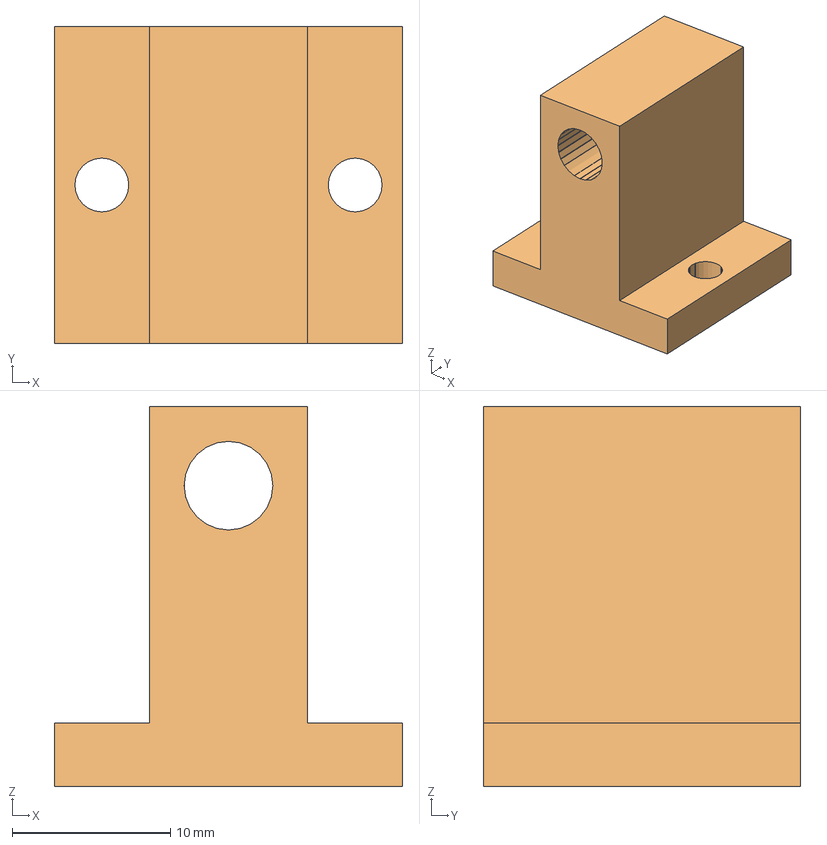
[picture p80: CAD file, 2019-09-15]
Mecanica/FreeCAD/agarre_motor.FCStd
22.0 x 20.0 x 24.0 mm
Pieza_final
Pieza_final (Meshed)
