clararodellar/TFG/Mecanica/stl/base_agarradera_movil_v03.stl

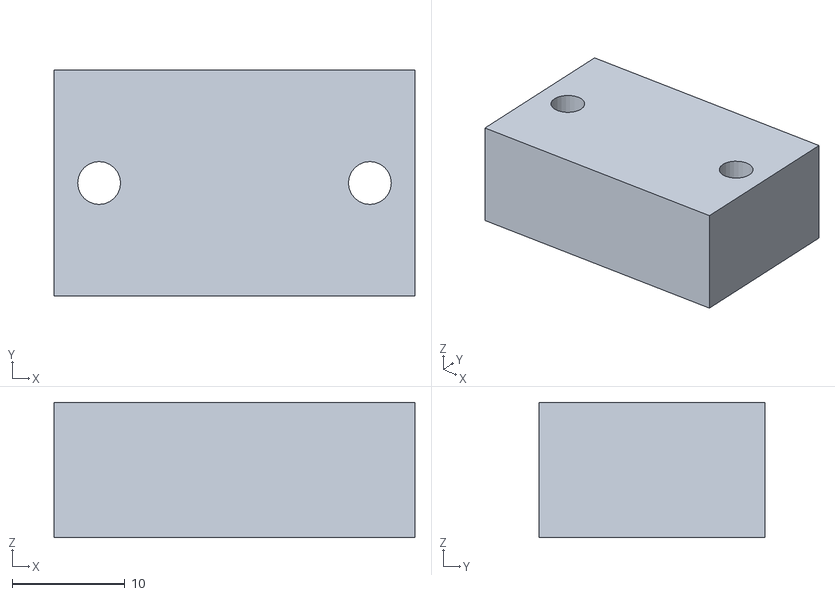
[picture p81: CAD file, 2018-11-26]
Mecanica/stl/base_agarradera_movil_v03.stl
32.0 x 20.0 x 12.0
