clararodellar/TFG/Mecanica/FreeCAD/agarradera_8.FCStd

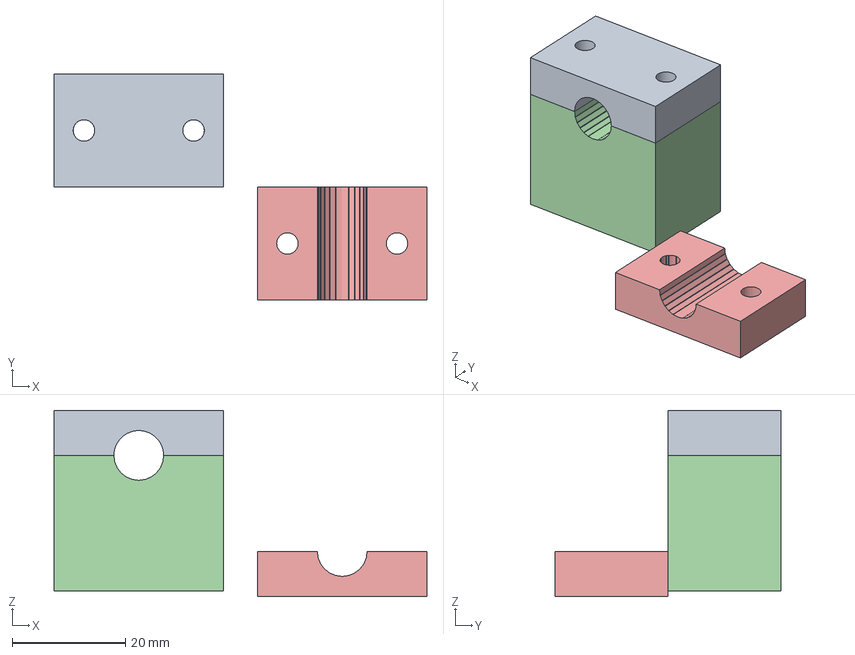
[picture p82: CAD file, 2019-09-15]
Mecanica/FreeCAD/agarradera_8.FCStd
66.0 x 40.0 x 33.0 mm
Base_arriba3
Base_abajo3
Base_arriba3_malla
Base_abajo3 (Meshed)
Base_arriba3_malla (Meshed)
