clararodellar/TFG/Mecanica/FreeCAD/prueba_planos.FCStd

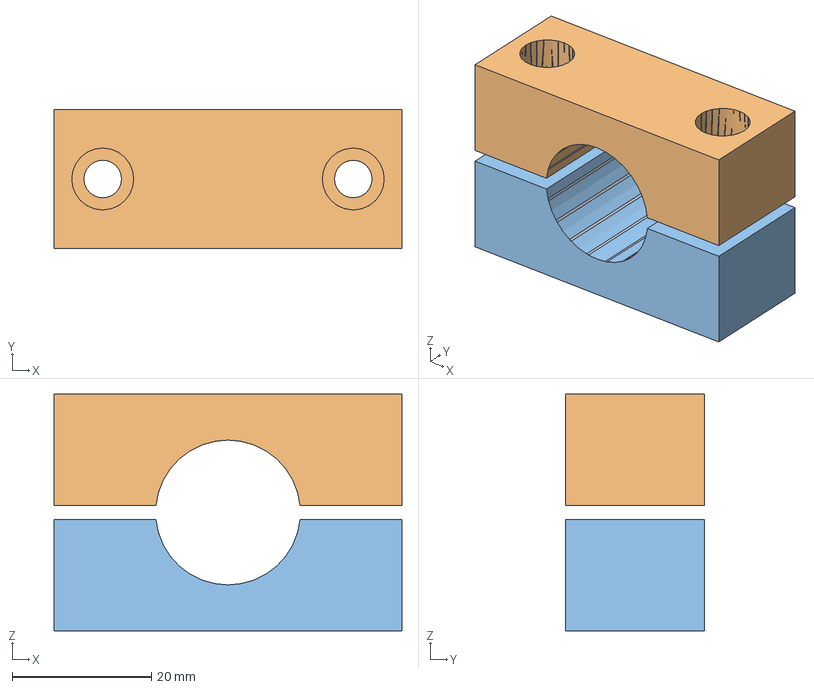
[picture p83: CAD file, 2018-10-25]
Mecanica/FreeCAD/prueba_planos.FCStd
50.0 x 20.0 x 34.0 mm
Pieza_arriba (Meshed)
Pieza_abajo (Meshed)
