clararodellar/TFG/(list of files, cad)

Other CAD files:
Electronica_control/Codigos/FPGA/PWM_prueba_lazocerrado_v3/isim/tb_juntar_isim_beh.exe.sim/work/tb_juntar_isim_beh.exe_main.nt64.obj
Electronica_control/Codigos/FPGA/PWM_prueba_lazocerrado_v3/isim/precompiled.exe.sim/ieee/p_3499444699.nt64.obj
Electronica_control/Codigos/FPGA/PWM_prueba_lazocerrado_v3/isim/precompiled.exe.sim/ieee/p_1242562249.nt64.obj
Electronica_control/Codigos/FPGA/PWM_prueba_lazocerrado_v3/isim/tb_juntar_isim_beh.exe.sim/work/a_1543659282_3212880686.nt64.obj
Electronica_control/Codigos/FPGA/PWM_prueba_lazocerrado_v3/isim/precompiled.exe.sim/ieee/p_2592010699.nt64.obj
Electronica_control/Codigos/FPGA/PWM_prueba_lazocerrado_v3/isim/tb_juntar_isim_beh.exe.sim/work/a_2335869439_3212880686.nt64.obj
Electronica_control/Codigos/FPGA/PWM_prueba_lazocerrado_v3/isim/precompiled.exe.sim/ieee/p_3620187407.nt64.obj
Electronica_control/Codigos/FPGA/PWM_prueba_lazocerrado_v3/isim/tb_juntar_isim_beh.exe.sim/work/a_2536911233_3212880686.nt64.obj
Electronica_control/Codigos/FPGA/PWM_prueba_lazocerrado_v3/isim/tb_juntar_isim_beh.exe.sim/work/a_2943806228_3212880686.nt64.obj
Electronica_control/Codigos/FPGA/PWM_prueba_lazocerrado_v3/isim/tb_juntar_isim_beh.exe.sim/work/a_0055186542_3212880686.nt64.obj
Electronica_control/Codigos/FPGA/PWM_prueba_lazocerrado_v3/isim/tb_juntar_isim_beh.exe.sim/work/a_1209826792_3212880686.nt64.obj
Electronica_control/Codigos/FPGA/PWM_prueba_lazocerrado_v3/isim/tb_juntar_isim_beh.exe.sim/work/a_2483966931_2372691052.nt64.obj
Mecanica/FreeCAD/agarradera_movil_6_v01.FCStd
Mecanica/FreeCAD/agarradera_movil_6_v02.FCStd
Mecanica/stl/agarradera_movil_6.stl
Mecanica/stl/agarradera_movil_6_v02.stl
Mecanica/stl/agarradera_movil_6_v03.stl
Mecanica/stl/agarre_motor.stl
