clararodellar/TFG/Electronica_control/Codigos/FPGA/PWM_prueba_lazocerrado_v3/usage_statistics_webtalk.html

### Device Usage Page (usage_statistics_webtalk.html)

This HTML page displays the device usage statistics that will be sent to Xilinx.

Software Version and Target Device
Product Version: | ISE:14.7 (WebPack) - P.20131013 | Target Family: | Spartan3E
OS Platform: | NT64 | Target Device: | xc3s100e
Project ID (random number) | cd5457f82ff24d9bb826ff461313e1c8.197FF1AB906349C6998659D5E5F932CE.11 | Target Package: | tq144
Registration ID | 211667494_0_0_638 | Target Speed: | -4
Date Generated | 2019-10-11T11:00:39 | Tool Flow | ISE

User Environment
OS Name | Microsoft , 64-bit | OS Release | major release (build 9200)
CPU Name | Intel(R) Core(TM) i7-4510U CPU @ 2.00GHz | CPU Speed | 2594 MHz

Device Usage Statistics
Macro Statistics | Miscellaneous Statistics | Net Statistics | Site Usage

Adders/Subtractors=8

4-bit adder=7

8-bit addsub=1

Comparators=15

16-bit comparator greatequal=1

16-bit comparator greater=1

16-bit comparator lessequal=1

4-bit comparator greater=7

8-bit comparator greater=2

8-bit comparator less=3

Counters=11

10-bit up counter=1

16-bit up counter=1

16-bit updown counter=1

17-bit up counter=1

2-bit up counter=1

26-bit up counter=1

3-bit up counter=2

4-bit up counter=2

8-bit up counter=1

Multiplexers=1

4-bit 4-to-1 multiplexer=1

ROMs=1

16x7-bit ROM=1

Registers=57

Flip-Flops=57

Xors=2

1-bit xor2=2

MiscellaneousStatistics

AGG_BONDED_IO=28

AGG_IO=28

AGG_SLICE=239

NUM_4_INPUT_LUT=410

NUM_BONDED_IBUF=11

NUM_BONDED_IOB=17

NUM_BUFGMUX=1

NUM_CYMUX=138

NUM_IOB_FF=1

NUM_LUT_RT=73

NUM_SLICEL=239

NUM_SLICE_FF=163

NUM_XOR=101

NetStatistics

NumNets_Active=509

NumNets_Gnd=1

NumNets_Vcc=1

NumNodesOfType_Active_CLKPIN=94

NumNodesOfType_Active_CNTRLPIN=154

NumNodesOfType_Active_DOUBLE=615

NumNodesOfType_Active_DUMMY=1065

NumNodesOfType_Active_DUMMYESC=10

NumNodesOfType_Active_GLOBAL=46

NumNodesOfType_Active_HFULLHEX=6

NumNodesOfType_Active_HLONG=3

NumNodesOfType_Active_HUNIHEX=21

NumNodesOfType_Active_INPUT=1205

NumNodesOfType_Active_IOBOUTPUT=10

NumNodesOfType_Active_OMUX=430

NumNodesOfType_Active_OUTPUT=474

NumNodesOfType_Active_PREBXBY=286

NumNodesOfType_Active_VFULLHEX=49

NumNodesOfType_Active_VLONG=11

NumNodesOfType_Active_VUNIHEX=20

NumNodesOfType_Gnd_DOUBLE=1

NumNodesOfType_Gnd_INPUT=5

NumNodesOfType_Gnd_OMUX=4

NumNodesOfType_Gnd_OUTPUT=5

NumNodesOfType_Gnd_PREBXBY=5

SiteStatistics

IBUF-DIFFM=1

IBUF-DIFFMI=1

IBUF-DIFFS=2

IBUF-IOB=2

IOB-DIFFM=9

IOB-DIFFS=7

SLICEL-SLICEM=104

SiteSummary

BUFGMUX=1

BUFGMUX_GCLKMUX=1

BUFGMUX_GCLK_BUFFER=1

IBUF=11

IBUF_INBUF=11

IBUF_PAD=11

IOB=17

IOB_OFF1=1

IOB_OUTBUF=17

IOB_PAD=17

SLICEL=239

SLICEL_C1VDD=6

SLICEL_C2VDD=1

SLICEL_CYMUXF=73

SLICEL_CYMUXG=65

SLICEL_F=206

SLICEL_F5MUX=10

SLICEL_FFX=75

SLICEL_FFY=88

SLICEL_G=204

SLICEL_GNDF=44

SLICEL_GNDG=42

SLICEL_XORF=51

SLICEL_XORG=50

Configuration Data
BUFGMUX S=[S_INV:1] [S:0] BUFGMUX_GCLKMUX DISABLE_ATTR=[LOW:1] S=[S_INV:1] [S:0] IBUF_PAD IOATTRBOX=[LVCMOS25:11] IOB O1=[O1_INV:0] [O1:17] OTCLK1=[OTCLK1_INV:0] [OTCLK1:1] SR=[SR:1] [SR_INV:0] IOB_OFF1 CK=[CK:1] [CK_INV:0] D=[D:1] [D_INV:0] LATCH_OR_FF=[FF:1] OFF1_INIT_ATTR=[INIT0:1] OFF1_SR_ATTR=[SRLOW:1] OFFATTRBOX=[ASYNC:1] SR=[SR:1] [SR_INV:0] | IOB_OUTBUF IN=[IN_INV:0] [IN:17] IOB_PAD DRIVEATTRBOX=[12:17] IOATTRBOX=[LVCMOS25:17] SLEW=[SLOW:17] SLICEL BX=[BX_INV:1] [BX:40] BY=[BY:31] [BY_INV:2] CE=[CE:60] [CE_INV:0] CIN=[CIN_INV:0] [CIN:62] CLK=[CLK:93] [CLK_INV:0] SR=[SR:93] [SR_INV:0] SLICEL_CYMUXF 0=[0:73] [0_INV:0] 1=[1_INV:0] [1:73] | SLICEL_CYMUXG 0=[0:65] [0_INV:0] SLICEL_F5MUX S0=[S0:10] [S0_INV:0] SLICEL_FFX CE=[CE:45] [CE_INV:0] CK=[CK:75] [CK_INV:0] D=[D:74] [D_INV:1] FFX_INIT_ATTR=[INIT0:75] FFX_SR_ATTR=[SRLOW:75] LATCH_OR_FF=[FF:75] SR=[SR:75] [SR_INV:0] SYNC_ATTR=[ASYNC:75] SLICEL_FFY CE=[CE:55] [CE_INV:0] CK=[CK:88] [CK_INV:0] D=[D:86] [D_INV:2] FFY_INIT_ATTR=[INIT0:88] FFY_SR_ATTR=[SRLOW:88] LATCH_OR_FF=[FF:88] REV=[REV_INV:0] [REV:8] SR=[SR:88] [SR_INV:0] SYNC_ATTR=[ASYNC:88] | SLICEL_XORF 1=[1_INV:0] [1:51]

Pin Data
BUFGMUX I0=1 O=1 S=1 BUFGMUX_GCLKMUX I0=1 OUT=1 S=1 BUFGMUX_GCLK_BUFFER IN=1 OUT=1 IBUF I=11 PAD=11 IBUF_INBUF IN=11 OUT=11 IBUF_PAD PAD=11 IOB O1=17 OTCLK1=1 PAD=17 SR=1 IOB_OFF1 CK=1 D=1 Q=1 SR=1 | IOB_OUTBUF IN=17 OUT=17 IOB_PAD PAD=17 SLICEL BX=41 BY=33 CE=60 CIN=62 CLK=93 COUT=65 F1=206 F2=161 F3=95 F4=73 G1=204 G2=162 G3=97 G4=65 SR=93 X=127 XB=2 XQ=75 Y=112 YQ=88 | SLICEL_C1VDD 1=6 SLICEL_C2VDD 1=1 SLICEL_CYMUXF 0=73 1=73 OUT=73 S0=73 SLICEL_CYMUXG 0=65 1=65 OUT=65 S0=65 SLICEL_F A1=206 A2=161 A3=95 A4=73 D=206 SLICEL_F5MUX F=10 G=10 OUT=10 S0=10 SLICEL_FFX CE=45 CK=75 D=75 Q=75 SR=75 | SLICEL_FFY CE=55 CK=88 D=88 Q=88 REV=8 SR=88 SLICEL_G A1=204 A2=162 A3=97 A4=65 D=204 SLICEL_GNDF 0=44 SLICEL_GNDG 0=42 SLICEL_XORF 0=51 1=51 O=51 SLICEL_XORG 0=50 1=50 O=50

Tool Usage

Command Line History

xst -intstyle ise -ifn <ise_file>

xst -intstyle ise -ifn <ise_file>

xst -intstyle ise -ifn <ise_file>

xst -intstyle ise -ifn <ise_file>

ngdbuild -intstyle ise -dd _ngo -nt timestamp -uc <fname>.ucf -p xc3s100e-tq144-4 <fname>.ngc <fname>.ngd

map -intstyle ise -p xc3s100e-tq144-4 -cm area -ir off -pr off -c 100 -o <fname>.ncd <fname>.ngd <fname>.pcf

par -w -intstyle ise -ol high -t 1 <fname>.ncd <fname>.ncd <fname>.pcf

trce -intstyle ise -v 3 -s 4 -n 3 -fastpaths -xml <fname>.twx <fname>.ncd -o <fname>.twr <fname>.pcf -ucf <fname>.ucf

bitgen -intstyle ise -f <fname>.ut <fname>.ncd

xst -intstyle ise -ifn <ise_file>

xst -intstyle ise -ifn <ise_file>

ngdbuild -intstyle ise -dd _ngo -nt timestamp -uc <fname>.ucf -p xc3s100e-tq144-4 <fname>.ngc <fname>.ngd

map -intstyle ise -p xc3s100e-tq144-4 -cm area -ir off -pr off -c 100 -o <fname>.ncd <fname>.ngd <fname>.pcf

par -w -intstyle ise -ol high -t 1 <fname>.ncd <fname>.ncd <fname>.pcf

trce -intstyle ise -v 3 -s 4 -n 3 -fastpaths -xml <fname>.twx <fname>.ncd -o <fname>.twr <fname>.pcf -ucf <fname>.ucf

bitgen -intstyle ise -f <fname>.ut <fname>.ncd

xst -intstyle ise -ifn <ise_file>

ngdbuild -intstyle ise -dd _ngo -nt timestamp -uc <fname>.ucf -p xc3s100e-tq144-4 <fname>.ngc <fname>.ngd

map -intstyle ise -p xc3s100e-tq144-4 -cm area -ir off -pr off -c 100 -o <fname>.ncd <fname>.ngd <fname>.pcf

par -w -intstyle ise -ol high -t 1 <fname>.ncd <fname>.ncd <fname>.pcf

bitgen -intstyle ise -f <fname>.ut <fname>.ncd

xst -intstyle ise -ifn <ise_file>

ngdbuild -intstyle ise -dd _ngo -nt timestamp -uc <fname>.ucf -p xc3s100e-tq144-4 <fname>.ngc <fname>.ngd

map -intstyle ise -p xc3s100e-tq144-4 -cm area -ir off -pr off -c 100 -o <fname>.ncd <fname>.ngd <fname>.pcf

par -w -intstyle ise -ol high -t 1 <fname>.ncd <fname>.ncd <fname>.pcf

trce -intstyle ise -v 3 -s 4 -n 3 -fastpaths -xml <fname>.twx <fname>.ncd -o <fname>.twr <fname>.pcf -ucf <fname>.ucf

bitgen -intstyle ise -f <fname>.ut <fname>.ncd

xst -intstyle ise -ifn <ise_file>

ngdbuild -intstyle ise -dd _ngo -nt timestamp -uc <fname>.ucf -p xc3s100e-tq144-4 <fname>.ngc <fname>.ngd

map -intstyle ise -p xc3s100e-tq144-4 -cm area -ir off -pr off -c 100 -o <fname>.ncd <fname>.ngd <fname>.pcf

par -w -intstyle ise -ol high -t 1 <fname>.ncd <fname>.ncd <fname>.pcf

trce -intstyle ise -v 3 -s 4 -n 3 -fastpaths -xml <fname>.twx <fname>.ncd -o <fname>.twr <fname>.pcf -ucf <fname>.ucf

bitgen -intstyle ise -f <fname>.ut <fname>.ncd

xst -intstyle ise -ifn <ise_file>

xst -intstyle ise -ifn <ise_file>

xst -intstyle ise -ifn <ise_file>

xst -intstyle ise -ifn <ise_file>

ngdbuild -intstyle ise -dd _ngo -nt timestamp -uc <fname>.ucf -p xc3s100e-tq144-4 <fname>.ngc <fname>.ngd

map -intstyle ise -p xc3s100e-tq144-4 -cm area -ir off -pr off -c 100 -o <fname>.ncd <fname>.ngd <fname>.pcf

par -w -intstyle ise -ol high -t 1 <fname>.ncd <fname>.ncd <fname>.pcf

trce -intstyle ise -v 3 -s 4 -n 3 -fastpaths -xml <fname>.twx <fname>.ncd -o <fname>.twr <fname>.pcf -ucf <fname>.ucf

bitgen -intstyle ise -f <fname>.ut <fname>.ncd

xst -intstyle ise -ifn <ise_file>

xst -intstyle ise -ifn <ise_file>

xst -intstyle ise -ifn <ise_file>

xst -intstyle ise -ifn <ise_file>

ngdbuild -intstyle ise -dd _ngo -nt timestamp -uc <fname>.ucf -p xc3s100e-tq144-4 <fname>.ngc <fname>.ngd

map -intstyle ise -p xc3s100e-tq144-4 -cm area -ir off -pr off -c 100 -o <fname>.ncd <fname>.ngd <fname>.pcf

par -w -intstyle ise -ol high -t 1 <fname>.ncd <fname>.ncd <fname>.pcf

trce -intstyle ise -v 3 -s 4 -n 3 -fastpaths -xml <fname>.twx <fname>.ncd -o <fname>.twr <fname>.pcf -ucf <fname>.ucf

bitgen -intstyle ise -f <fname>.ut <fname>.ncd

xst -intstyle ise -ifn <ise_file>

xst -intstyle ise -ifn <ise_file>

ngdbuild -intstyle ise -dd _ngo -nt timestamp -uc <fname>.ucf -p xc3s100e-tq144-4 <fname>.ngc <fname>.ngd

map -intstyle ise -p xc3s100e-tq144-4 -cm area -ir off -pr off -c 100 -o <fname>.ncd <fname>.ngd <fname>.pcf

par -w -intstyle ise -ol high -t 1 <fname>.ncd <fname>.ncd <fname>.pcf

trce -intstyle ise -v 3 -s 4 -n 3 -fastpaths -xml <fname>.twx <fname>.ncd -o <fname>.twr <fname>.pcf -ucf <fname>.ucf

bitgen -intstyle ise -f <fname>.ut <fname>.ncd

ngdbuild -intstyle ise -dd _ngo -nt timestamp -uc <fname>.ucf -p xc3s100e-tq144-4 <fname>.ngc <fname>.ngd

map -intstyle ise -p xc3s100e-tq144-4 -cm area -ir off -pr off -c 100 -o <fname>.ncd <fname>.ngd <fname>.pcf

par -w -intstyle ise -ol high -t 1 <fname>.ncd <fname>.ncd <fname>.pcf

trce -intstyle ise -v 3 -s 4 -n 3 -fastpaths -xml <fname>.twx <fname>.ncd -o <fname>.twr <fname>.pcf -ucf <fname>.ucf

bitgen -intstyle ise -f <fname>.ut <fname>.ncd

xst -intstyle ise -ifn <ise_file>

xst -intstyle ise -ifn <ise_file>

xst -intstyle ise -ifn <ise_file>

xst -intstyle ise -ifn <ise_file>

xst -intstyle ise -ifn <ise_file>

ngdbuild -intstyle ise -dd _ngo -nt timestamp -uc <fname>.ucf -p xc3s100e-tq144-4 <fname>.ngc <fname>.ngd

map -intstyle ise -p xc3s100e-tq144-4 -cm area -ir off -pr off -c 100 -o <fname>.ncd <fname>.ngd <fname>.pcf

par -w -intstyle ise -ol high -t 1 <fname>.ncd <fname>.ncd <fname>.pcf

trce -intstyle ise -v 3 -s 4 -n 3 -fastpaths -xml <fname>.twx <fname>.ncd -o <fname>.twr <fname>.pcf -ucf <fname>.ucf

bitgen -intstyle ise -f <fname>.ut <fname>.ncd

xst -intstyle ise -ifn <ise_file>

ngdbuild -intstyle ise -dd _ngo -nt timestamp -uc <fname>.ucf -p xc3s100e-tq144-4 <fname>.ngc <fname>.ngd

map -intstyle ise -p xc3s100e-tq144-4 -cm area -ir off -pr off -c 100 -o <fname>.ncd <fname>.ngd <fname>.pcf

par -w -intstyle ise -ol high -t 1 <fname>.ncd <fname>.ncd <fname>.pcf

trce -intstyle ise -v 3 -s 4 -n 3 -fastpaths -xml <fname>.twx <fname>.ncd -o <fname>.twr <fname>.pcf -ucf <fname>.ucf

bitgen -intstyle ise -f <fname>.ut <fname>.ncd

fuse

Software Quality
Run Statistics
Program Name | Runs Started | Runs Finished | Errors | Fatal Errors | Internal Errors | Exceptions | Core Dumps
_impact | 336 | 305 | 0 | 0 | 0 | 0 | 0
bitgen | 263 | 261 | 0 | 0 | 0 | 0 | 0
map | 297 | 278 | 0 | 0 | 0 | 0 | 0
ngc2edif | 4 | 4 | 0 | 0 | 0 | 0 | 0
ngdbuild | 307 | 304 | 0 | 0 | 0 | 0 | 0
par | 273 | 273 | 0 | 0 | 0 | 0 | 0
trce | 271 | 271 | 0 | 0 | 0 | 0 | 0
xst | 753 | 745 | 0 | 0 | 0 | 0 | 0

Project Statistics
PROPEXT_xilxSynthMaxFanout_virtex2=100000 | PROP_Enable_Message_Filtering=false
PROP_FitterReportFormat=HTML | PROP_LastAppliedGoal=Balanced
PROP_LastAppliedStrategy=Xilinx Default (unlocked) | PROP_ManualCompileOrderImp=false
PROP_PropSpecInProjFile=Store all values | PROP_SelectedInstanceHierarchicalPath=/tb_juntar
PROP_Simulator=ISim (VHDL/Verilog) | PROP_SynthTopFile=changed
PROP_Top_Level_Module_Type=HDL | PROP_UseSmartGuide=false
PROP_UserConstraintEditorPreference=Text Editor | PROP_intProjectCreationTimestamp=2019-09-18T17:01:35
PROP_intWbtProjectID=197FF1AB906349C6998659D5E5F932CE | PROP_intWbtProjectIteration=11
PROP_intWorkingDirLocWRTProjDir=Same | PROP_intWorkingDirUsed=No
PROP_selectedSimRootSourceNode_behav=work.tb_juntar | PROP_xilxBitgStart_IntDone=true
PROP_AutoTop=true | PROP_DevFamily=Spartan3E
PROP_DevDevice=xc3s100e | PROP_DevFamilyPMName=spartan3e
PROP_DevPackage=tq144 | PROP_Synthesis_Tool=XST (VHDL/Verilog)
PROP_DevSpeed=-4 | PROP_PreferredLanguage=Verilog
FILE_UCF=1 | FILE_VHDL=7

Unisim Statistics
NGDBUILD_PRE_UNISIM_SUMMARY
NGDBUILD_NUM_BUFGP=1 | NGDBUILD_NUM_FDC=64 | NGDBUILD_NUM_FDCE=84 | NGDBUILD_NUM_FDCPE=16
NGDBUILD_NUM_GND=1 | NGDBUILD_NUM_IBUF=9 | NGDBUILD_NUM_INV=17 | NGDBUILD_NUM_LUT1=73
NGDBUILD_NUM_LUT2=131 | NGDBUILD_NUM_LUT3=49 | NGDBUILD_NUM_LUT3_D=5 | NGDBUILD_NUM_LUT4=131
NGDBUILD_NUM_LUT4_D=4 | NGDBUILD_NUM_LUT4_L=3 | NGDBUILD_NUM_MUXCY=138 | NGDBUILD_NUM_MUXF5=10
NGDBUILD_NUM_OBUF=17 | NGDBUILD_NUM_VCC=1 | NGDBUILD_NUM_XORCY=101
NGDBUILD_POST_UNISIM_SUMMARY
NGDBUILD_NUM_BUFG=1 | NGDBUILD_NUM_FDC=64 | NGDBUILD_NUM_FDCE=84 | NGDBUILD_NUM_FDCPE=16
NGDBUILD_NUM_GND=1 | NGDBUILD_NUM_IBUF=10 | NGDBUILD_NUM_IBUFG=1 | NGDBUILD_NUM_INV=17
NGDBUILD_NUM_LUT1=73 | NGDBUILD_NUM_LUT2=131 | NGDBUILD_NUM_LUT3=49 | NGDBUILD_NUM_LUT3_D=5
NGDBUILD_NUM_LUT4=131 | NGDBUILD_NUM_LUT4_D=4 | NGDBUILD_NUM_LUT4_L=3 | NGDBUILD_NUM_MUXCY=138
NGDBUILD_NUM_MUXF5=10 | NGDBUILD_NUM_OBUF=17 | NGDBUILD_NUM_VCC=1 | NGDBUILD_NUM_XORCY=101

XST Command Line Options
XST_OPTION_SUMMARY
-ifn=<fname>.prj | -ifmt=mixed | -ofn=<design_top> | -ofmt=NGC
-p=xc3s100e-4-tq144 | -top=<design_top> | -opt_mode=Speed | -opt_level=1
-iuc=NO | -keep_hierarchy=No | -netlist_hierarchy=As_Optimized | -rtlview=Yes
-glob_opt=AllClockNets | -read_cores=YES | -write_timing_constraints=NO | -cross_clock_analysis=NO
-bus_delimiter=<> | -slice_utilization_ratio=100 | -bram_utilization_ratio=100 | -verilog2001=YES
-fsm_extract=YES | -fsm_encoding=Auto | -safe_implementation=No | -fsm_style=LUT
-ram_extract=Yes | -ram_style=Auto | -rom_extract=Yes | -shreg_extract=YES
-rom_style=Auto | -auto_bram_packing=NO | -resource_sharing=YES | -async_to_sync=NO
-mult_style=Auto | -iobuf=YES | -max_fanout=100000 | -bufg=24
-register_duplication=YES | -register_balancing=No | -optimize_primitives=NO | -use_clock_enable=Yes
-use_sync_set=Yes | -use_sync_reset=Yes | -iob=Auto | -equivalent_register_removal=YES

-slice_utilization_ratio_maxmargin=5

ISim Statistics

Xilinx HDL Libraries Used=ieee

Fuse Resource Usage=765 ms, 37168 KB

Total Signals=127

Total Nets=328

Total Blocks=12

Total Processes=44

Total Simulation Time=120 ms

Simulation Resource Usage=204.438 sec, 4688470 KB

Simulation Mode=gui

Hardware CoSim=0
