clararodellar/TFG/Electronica_control/Codigos/FPGA/motor_lazo_abierto/usage_statistics_webtalk.html

### Device Usage Page (usage_statistics_webtalk.html)

This HTML page displays the device usage statistics that will be sent to Xilinx.

Software Version and Target Device
Product Version: | ISE:14.7 (WebPack) - P.20131013 | Target Family: | Spartan3E
OS Platform: | NT64 | Target Device: | xc3s100e
Project ID (random number) | cd5457f82ff24d9bb826ff461313e1c8.A1829E1526B14BA5BF1D08914A32D16A.1 | Target Package: | tq144
Registration ID | 211667494_0_0_638 | Target Speed: | -4
Date Generated | 2019-09-11T18:27:43 | Tool Flow | ISE

User Environment
OS Name | Microsoft , 64-bit | OS Release | major release (build 9200)
CPU Name | Intel(R) Core(TM) i7-4510U CPU @ 2.00GHz | CPU Speed | 2594 MHz

Device Usage Statistics
Macro Statistics | Miscellaneous Statistics | Net Statistics | Site Usage

Adders/Subtractors=8

4-bit adder=7

8-bit addsub=1

Comparators=12

4-bit comparator greater=7

8-bit comparator greater=2

8-bit comparator less=3

Counters=7

10-bit up counter=1

17-bit up counter=1

2-bit up counter=1

20-bit up counter=2

26-bit up counter=1

8-bit up counter=1

Multiplexers=1

4-bit 4-to-1 multiplexer=1

ROMs=1

16x7-bit ROM=1

Registers=21

Flip-Flops=21

Xors=2

1-bit xor2=2

MiscellaneousStatistics

AGG_BONDED_IO=23

AGG_IO=23

AGG_SLICE=171

NUM_4_INPUT_LUT=316

NUM_BONDED_IBUF=8

NUM_BONDED_IOB=15

NUM_BUFGMUX=1

NUM_CYMUX=122

NUM_IOB_FF=1

NUM_LUT_RT=96

NUM_SLICEL=171

NUM_SLICE_FF=127

NUM_XOR=109

NetStatistics

NumNets_Active=391

NumNets_Gnd=1

NumNets_Vcc=1

NumNodesOfType_Active_CLKPIN=72

NumNodesOfType_Active_CNTRLPIN=107

NumNodesOfType_Active_DOUBLE=544

NumNodesOfType_Active_DUMMY=770

NumNodesOfType_Active_DUMMYESC=8

NumNodesOfType_Active_GLOBAL=35

NumNodesOfType_Active_HFULLHEX=1

NumNodesOfType_Active_HUNIHEX=19

NumNodesOfType_Active_INPUT=866

NumNodesOfType_Active_IOBOUTPUT=8

NumNodesOfType_Active_OMUX=311

NumNodesOfType_Active_OUTPUT=361

NumNodesOfType_Active_PREBXBY=171

NumNodesOfType_Active_VFULLHEX=14

NumNodesOfType_Active_VUNIHEX=15

NumNodesOfType_Vcc_CNTRLPIN=1

NumNodesOfType_Vcc_INPUT=4

NumNodesOfType_Vcc_PREBXBY=3

NumNodesOfType_Vcc_VCCOUT=5

SiteStatistics

IBUF-DIFFMI=1

IBUF-DIFFS=1

IBUF-IOB=2

IOB-DIFFM=8

IOB-DIFFS=6

SLICEL-SLICEM=70

SiteSummary

BUFGMUX=1

BUFGMUX_GCLKMUX=1

BUFGMUX_GCLK_BUFFER=1

IBUF=8

IBUF_INBUF=8

IBUF_PAD=8

IOB=15

IOB_OFF1=1

IOB_OUTBUF=15

IOB_PAD=15

SLICEL=171

SLICEL_C1VDD=6

SLICEL_CYMUXF=65

SLICEL_CYMUXG=57

SLICEL_F=160

SLICEL_F5MUX=13

SLICEL_FFX=61

SLICEL_FFY=66

SLICEL_G=156

SLICEL_GNDF=51

SLICEL_GNDG=50

SLICEL_XORF=55

SLICEL_XORG=54

Configuration Data
BUFGMUX S=[S_INV:1] [S:0] BUFGMUX_GCLKMUX DISABLE_ATTR=[LOW:1] S=[S_INV:1] [S:0] IBUF_PAD IOATTRBOX=[LVCMOS25:8] IOB O1=[O1_INV:0] [O1:15] OTCLK1=[OTCLK1_INV:0] [OTCLK1:1] SR=[SR:1] [SR_INV:0] IOB_OFF1 CK=[CK:1] [CK_INV:0] D=[D:1] [D_INV:0] LATCH_OR_FF=[FF:1] OFF1_INIT_ATTR=[INIT0:1] OFF1_SR_ATTR=[SRLOW:1] OFFATTRBOX=[ASYNC:1] SR=[SR:1] [SR_INV:0] | IOB_OUTBUF IN=[IN_INV:0] [IN:15] IOB_PAD DRIVEATTRBOX=[12:15] IOATTRBOX=[LVCMOS25:15] SLEW=[SLOW:15] SLICEL BX=[BX_INV:0] [BX:28] BY=[BY:7] [BY_INV:1] CE=[CE:19] [CE_INV:20] CIN=[CIN_INV:0] [CIN:56] CLK=[CLK:71] [CLK_INV:0] SR=[SR:67] [SR_INV:0] SLICEL_CYMUXF 0=[0:65] [0_INV:0] 1=[1_INV:0] [1:65] | SLICEL_CYMUXG 0=[0:57] [0_INV:0] SLICEL_F5MUX S0=[S0:13] [S0_INV:0] SLICEL_FFX CE=[CE:12] [CE_INV:20] CK=[CK:61] [CK_INV:0] D=[D:61] [D_INV:0] FFX_INIT_ATTR=[INIT0:61] FFX_SR_ATTR=[SRLOW:61] LATCH_OR_FF=[FF:61] SR=[SR:61] [SR_INV:0] SYNC_ATTR=[ASYNC:41] [SYNC:20] SLICEL_FFY CE=[CE:15] [CE_INV:20] CK=[CK:66] [CK_INV:0] D=[D:65] [D_INV:1] FFY_INIT_ATTR=[INIT0:66] FFY_SR_ATTR=[SRLOW:66] LATCH_OR_FF=[FF:66] SR=[SR:62] [SR_INV:0] SYNC_ATTR=[ASYNC:46] [SYNC:20] | SLICEL_XORF 1=[1_INV:0] [1:55]

Pin Data
BUFGMUX I0=1 O=1 S=1 BUFGMUX_GCLKMUX I0=1 OUT=1 S=1 BUFGMUX_GCLK_BUFFER IN=1 OUT=1 IBUF I=8 PAD=8 IBUF_INBUF IN=8 OUT=8 IBUF_PAD PAD=8 IOB O1=15 OTCLK1=1 PAD=15 SR=1 IOB_OFF1 CK=1 D=1 Q=1 SR=1 | IOB_OUTBUF IN=15 OUT=15 IOB_PAD PAD=15 SLICEL BX=28 BY=8 CE=39 CIN=56 CLK=71 COUT=57 F1=158 F2=106 F3=70 F4=54 G1=156 G2=106 G3=68 G4=50 SR=67 X=96 XB=2 XQ=61 Y=77 YQ=66 | SLICEL_C1VDD 1=6 SLICEL_CYMUXF 0=65 1=65 OUT=65 S0=65 SLICEL_CYMUXG 0=57 1=57 OUT=57 S0=57 SLICEL_F A1=158 A2=106 A3=70 A4=54 D=160 SLICEL_F5MUX F=13 G=13 OUT=13 S0=13 SLICEL_FFX CE=32 CK=61 D=61 Q=61 SR=61 | SLICEL_FFY CE=35 CK=66 D=66 Q=66 SR=62 SLICEL_G A1=156 A2=106 A3=68 A4=50 D=156 SLICEL_GNDF 0=51 SLICEL_GNDG 0=50 SLICEL_XORF 0=55 1=55 O=55 SLICEL_XORG 0=54 1=54 O=54

Tool Usage

Command Line History

xst -intstyle ise -ifn <ise_file>

ngdbuild -intstyle ise -dd _ngo -nt timestamp -uc <fname>.ucf -p xc3s100e-tq144-4 <fname>.ngc <fname>.ngd

map -intstyle ise -p xc3s100e-tq144-4 -cm area -ir off -pr off -c 100 -o <fname>.ncd <fname>.ngd <fname>.pcf

par -w -intstyle ise -ol high -t 1 <fname>.ncd <fname>.ncd <fname>.pcf

trce -intstyle ise -v 3 -s 4 -n 3 -fastpaths -xml <fname>.twx <fname>.ncd -o <fname>.twr <fname>.pcf -ucf <fname>.ucf

bitgen -intstyle ise -f <fname>.ut <fname>.ncd

Software Quality
Run Statistics
Program Name | Runs Started | Runs Finished | Errors | Fatal Errors | Internal Errors | Exceptions | Core Dumps
_impact | 272 | 249 | 0 | 0 | 0 | 0 | 0
bitgen | 227 | 225 | 0 | 0 | 0 | 0 | 0
map | 259 | 240 | 0 | 0 | 0 | 0 | 0
ngdbuild | 268 | 265 | 0 | 0 | 0 | 0 | 0
par | 236 | 236 | 0 | 0 | 0 | 0 | 0
trce | 236 | 236 | 0 | 0 | 0 | 0 | 0
xst | 689 | 681 | 0 | 0 | 0 | 0 | 0

Project Statistics
PROP_Enable_Message_Filtering=false | PROP_FitterReportFormat=HTML
PROP_LastAppliedGoal=Balanced | PROP_LastAppliedStrategy=Xilinx Default (unlocked)
PROP_ManualCompileOrderImp=false | PROP_PropSpecInProjFile=Store all values
PROP_Simulator=ISim (VHDL/Verilog) | PROP_SynthTopFile=changed
PROP_Top_Level_Module_Type=HDL | PROP_UseSmartGuide=false
PROP_UserConstraintEditorPreference=Text Editor | PROP_intProjectCreationTimestamp=2019-09-11T18:23:31
PROP_intWbtProjectID=A1829E1526B14BA5BF1D08914A32D16A | PROP_intWbtProjectIteration=1
PROP_intWorkingDirLocWRTProjDir=Same | PROP_intWorkingDirUsed=No
PROP_AutoTop=true | PROP_DevFamily=Spartan3E
PROP_DevDevice=xc3s100e | PROP_DevFamilyPMName=spartan3e
PROP_DevPackage=tq144 | PROP_Synthesis_Tool=XST (VHDL/Verilog)
PROP_DevSpeed=-4 | PROP_PreferredLanguage=Verilog
FILE_UCF=1 | FILE_VHDL=4

Unisim Statistics
NGDBUILD_PRE_UNISIM_SUMMARY
NGDBUILD_NUM_BUFGP=1 | NGDBUILD_NUM_FDC=61 | NGDBUILD_NUM_FDCE=23 | NGDBUILD_NUM_FDE=4
NGDBUILD_NUM_FDRE=40 | NGDBUILD_NUM_GND=1 | NGDBUILD_NUM_IBUF=7 | NGDBUILD_NUM_INV=9
NGDBUILD_NUM_LUT1=96 | NGDBUILD_NUM_LUT2=74 | NGDBUILD_NUM_LUT3=30 | NGDBUILD_NUM_LUT3_D=4
NGDBUILD_NUM_LUT4=100 | NGDBUILD_NUM_LUT4_D=3 | NGDBUILD_NUM_LUT4_L=1 | NGDBUILD_NUM_MUXCY=122
NGDBUILD_NUM_MUXF5=13 | NGDBUILD_NUM_OBUF=15 | NGDBUILD_NUM_VCC=1 | NGDBUILD_NUM_XORCY=109
NGDBUILD_POST_UNISIM_SUMMARY
NGDBUILD_NUM_BUFG=1 | NGDBUILD_NUM_FDC=61 | NGDBUILD_NUM_FDCE=23 | NGDBUILD_NUM_FDE=4
NGDBUILD_NUM_FDRE=40 | NGDBUILD_NUM_GND=1 | NGDBUILD_NUM_IBUF=7 | NGDBUILD_NUM_IBUFG=1
NGDBUILD_NUM_INV=9 | NGDBUILD_NUM_LUT1=96 | NGDBUILD_NUM_LUT2=74 | NGDBUILD_NUM_LUT3=30
NGDBUILD_NUM_LUT3_D=4 | NGDBUILD_NUM_LUT4=100 | NGDBUILD_NUM_LUT4_D=3 | NGDBUILD_NUM_LUT4_L=1
NGDBUILD_NUM_MUXCY=122 | NGDBUILD_NUM_MUXF5=13 | NGDBUILD_NUM_OBUF=15 | NGDBUILD_NUM_VCC=1

NGDBUILD_NUM_XORCY=109

XST Command Line Options
XST_OPTION_SUMMARY
-ifn=<fname>.prj | -ifmt=mixed | -ofn=<design_top> | -ofmt=NGC
-p=xc3s100e-4-tq144 | -top=<design_top> | -opt_mode=Speed | -opt_level=1
-iuc=NO | -keep_hierarchy=No | -netlist_hierarchy=As_Optimized | -rtlview=Yes
-glob_opt=AllClockNets | -read_cores=YES | -write_timing_constraints=NO | -cross_clock_analysis=NO
-bus_delimiter=<> | -slice_utilization_ratio=100 | -bram_utilization_ratio=100 | -verilog2001=YES
-fsm_extract=YES | -fsm_encoding=Auto | -safe_implementation=No | -fsm_style=LUT
-ram_extract=Yes | -ram_style=Auto | -rom_extract=Yes | -shreg_extract=YES
-rom_style=Auto | -auto_bram_packing=NO | -resource_sharing=YES | -async_to_sync=NO
-mult_style=Auto | -iobuf=YES | -max_fanout=500 | -bufg=24
-register_duplication=YES | -register_balancing=No | -optimize_primitives=NO | -use_clock_enable=Yes
-use_sync_set=Yes | -use_sync_reset=Yes | -iob=Auto | -equivalent_register_removal=YES

-slice_utilization_ratio_maxmargin=5
