clararodellar/TFG/Electronica_control/Codigos/FPGA/prueba_FPGA/usage_statistics_webtalk.html

### Device Usage Page (usage_statistics_webtalk.html)

This HTML page displays the device usage statistics that will be sent to Xilinx.

Software Version and Target Device
Product Version: | ISE:14.7 (WebPack) - P.20131013 | Target Family: | Spartan3E
OS Platform: | NT64 | Target Device: | xc3s100e
Project ID (random number) | cd5457f82ff24d9bb826ff461313e1c8.39D5E1AE095B4F1DA23FEED56505DFA0.2 | Target Package: | tq144
Registration ID | 211667494_0_0_638 | Target Speed: | -4
Date Generated | 2019-09-11T18:22:55 | Tool Flow | ISE

User Environment
OS Name | Microsoft , 64-bit | OS Release | major release (build 9200)
CPU Name | Intel(R) Core(TM) i7-4510U CPU @ 2.00GHz | CPU Speed | 2594 MHz

Device Usage Statistics
Macro Statistics | Miscellaneous Statistics | Net Statistics | Site Usage

Adders/Subtractors=2

17-bit adder=2

Comparators=1

8-bit comparator less=1

Counters=5

10-bit up counter=1

16-bit updown counter=1

17-bit up counter=1

2-bit up counter=1

8-bit up counter=1

Multiplexers=1

4-bit 4-to-1 multiplexer=1

ROMs=1

16x7-bit ROM=1

Registers=4

Flip-Flops=4

MiscellaneousStatistics

AGG_BONDED_IO=17

AGG_IO=17

AGG_SLICE=95

NUM_4_INPUT_LUT=173

NUM_BONDED_IBUF=4

NUM_BONDED_IOB=13

NUM_BUFGMUX=1

NUM_CYMUX=84

NUM_LUT_RT=39

NUM_SLICEL=95

NUM_SLICE_FF=57

NUM_XOR=85

NetStatistics

NumNets_Active=230

NumNets_Gnd=1

NumNets_Vcc=1

NumNodesOfType_Active_CLKPIN=32

NumNodesOfType_Active_CNTRLPIN=48

NumNodesOfType_Active_DOUBLE=189

NumNodesOfType_Active_DUMMY=386

NumNodesOfType_Active_DUMMYESC=4

NumNodesOfType_Active_GLOBAL=24

NumNodesOfType_Active_HFULLHEX=2

NumNodesOfType_Active_HUNIHEX=10

NumNodesOfType_Active_INPUT=444

NumNodesOfType_Active_IOBOUTPUT=4

NumNodesOfType_Active_OMUX=167

NumNodesOfType_Active_OUTPUT=209

NumNodesOfType_Active_PREBXBY=80

NumNodesOfType_Active_VFULLHEX=1

NumNodesOfType_Active_VUNIHEX=8

NumNodesOfType_Gnd_INPUT=6

NumNodesOfType_Gnd_OMUX=6

NumNodesOfType_Gnd_OUTPUT=6

NumNodesOfType_Gnd_PREBXBY=5

SiteStatistics

IBUF-DIFFM=2

IBUF-DIFFS=1

IOB-DIFFM=7

IOB-DIFFS=5

SLICEL-SLICEM=47

SiteSummary

BUFGMUX=1

BUFGMUX_GCLKMUX=1

BUFGMUX_GCLK_BUFFER=1

IBUF=4

IBUF_INBUF=4

IBUF_PAD=4

IOB=13

IOB_OUTBUF=13

IOB_PAD=13

SLICEL=95

SLICEL_C1VDD=7

SLICEL_C2VDD=2

SLICEL_CYMUXF=44

SLICEL_CYMUXG=40

SLICEL_F=88

SLICEL_F5MUX=4

SLICEL_FFX=27

SLICEL_FFY=30

SLICEL_G=85

SLICEL_GNDF=29

SLICEL_GNDG=31

SLICEL_XORF=44

SLICEL_XORG=41

Configuration Data
BUFGMUX S=[S_INV:1] [S:0] BUFGMUX_GCLKMUX DISABLE_ATTR=[LOW:1] S=[S_INV:1] [S:0] IBUF_PAD IOATTRBOX=[LVCMOS25:4] IOB O1=[O1_INV:0] [O1:13] IOB_OUTBUF IN=[IN_INV:0] [IN:13] IOB_PAD DRIVEATTRBOX=[12:13] IOATTRBOX=[LVCMOS25:13] SLEW=[SLOW:13] | SLICEL BX=[BX_INV:0] [BX:12] BY=[BY:2] [BY_INV:0] CE=[CE:16] [CE_INV:0] CIN=[CIN_INV:0] [CIN:40] CLK=[CLK:32] [CLK_INV:0] SR=[SR:32] [SR_INV:0] SLICEL_CYMUXF 0=[0:44] [0_INV:0] 1=[1_INV:0] [1:44] SLICEL_CYMUXG 0=[0:40] [0_INV:0] | SLICEL_F5MUX S0=[S0:4] [S0_INV:0] SLICEL_FFX CE=[CE:13] [CE_INV:0] CK=[CK:27] [CK_INV:0] D=[D:27] [D_INV:0] FFX_INIT_ATTR=[INIT0:27] FFX_SR_ATTR=[SRLOW:27] LATCH_OR_FF=[FF:27] SR=[SR:27] [SR_INV:0] SYNC_ATTR=[ASYNC:27] | SLICEL_FFY CE=[CE:15] [CE_INV:0] CK=[CK:30] [CK_INV:0] D=[D:30] [D_INV:0] FFY_INIT_ATTR=[INIT0:30] FFY_SR_ATTR=[SRLOW:30] LATCH_OR_FF=[FF:30] SR=[SR:30] [SR_INV:0] SYNC_ATTR=[ASYNC:30] SLICEL_XORF 1=[1_INV:0] [1:44]

Pin Data
BUFGMUX I0=1 O=1 S=1 BUFGMUX_GCLKMUX I0=1 OUT=1 S=1 BUFGMUX_GCLK_BUFFER IN=1 OUT=1 IBUF I=4 PAD=4 IBUF_INBUF IN=4 OUT=4 IBUF_PAD PAD=4 IOB O1=13 PAD=13 IOB_OUTBUF IN=13 OUT=13 IOB_PAD PAD=13 SLICEL BX=12 BY=2 CE=16 CIN=40 CLK=32 COUT=40 F1=87 F2=51 F3=31 F4=25 G1=85 G2=52 G3=32 G4=22 SR=32 X=59 XB=1 XQ=27 Y=51 YQ=30 | SLICEL_C1VDD 1=7 SLICEL_C2VDD 1=2 SLICEL_CYMUXF 0=44 1=44 OUT=44 S0=44 SLICEL_CYMUXG 0=40 1=40 OUT=40 S0=40 SLICEL_F A1=87 A2=51 A3=31 A4=25 D=88 SLICEL_F5MUX F=4 G=4 OUT=4 S0=4 SLICEL_FFX CE=13 CK=27 D=27 Q=27 SR=27 | SLICEL_FFY CE=15 CK=30 D=30 Q=30 SR=30 SLICEL_G A1=85 A2=52 A3=32 A4=22 D=85 SLICEL_GNDF 0=29 SLICEL_GNDG 0=31 SLICEL_XORF 0=44 1=44 O=44 SLICEL_XORG 0=41 1=41 O=41

Tool Usage

Command Line History

xst -intstyle ise -ifn <ise_file>

ngdbuild -intstyle ise -dd _ngo -nt timestamp -uc <fname>.ucf -p xc3s100e-tq144-4 <fname>.ngc <fname>.ngd

map -intstyle ise -p xc3s100e-tq144-4 -cm area -ir off -pr off -c 100 -o <fname>.ncd <fname>.ngd <fname>.pcf

par -w -intstyle ise -ol high -t 1 <fname>.ncd <fname>.ncd <fname>.pcf

trce -intstyle ise -v 3 -s 4 -n 3 -fastpaths -xml <fname>.twx <fname>.ncd -o <fname>.twr <fname>.pcf -ucf <fname>.ucf

bitgen -intstyle ise -f <fname>.ut <fname>.ncd

xst -intstyle ise -ifn <ise_file>

ngdbuild -intstyle ise -dd _ngo -nt timestamp -uc <fname>.ucf -p xc3s100e-tq144-4 <fname>.ngc <fname>.ngd

map -intstyle ise -p xc3s100e-tq144-4 -cm area -ir off -pr off -c 100 -o <fname>.ncd <fname>.ngd <fname>.pcf

par -w -intstyle ise -ol high -t 1 <fname>.ncd <fname>.ncd <fname>.pcf

trce -intstyle ise -v 3 -s 4 -n 3 -fastpaths -xml <fname>.twx <fname>.ncd -o <fname>.twr <fname>.pcf -ucf <fname>.ucf

bitgen -intstyle ise -f <fname>.ut <fname>.ncd

Software Quality
Run Statistics
Program Name | Runs Started | Runs Finished | Errors | Fatal Errors | Internal Errors | Exceptions | Core Dumps
_impact | 271 | 248 | 0 | 0 | 0 | 0 | 0
bitgen | 226 | 224 | 0 | 0 | 0 | 0 | 0
map | 258 | 239 | 0 | 0 | 0 | 0 | 0
ngdbuild | 267 | 264 | 0 | 0 | 0 | 0 | 0
par | 235 | 235 | 0 | 0 | 0 | 0 | 0
trce | 235 | 235 | 0 | 0 | 0 | 0 | 0
xst | 688 | 680 | 0 | 0 | 0 | 0 | 0

Project Statistics
PROP_Enable_Message_Filtering=false | PROP_FitterReportFormat=HTML
PROP_LastAppliedGoal=Balanced | PROP_LastAppliedStrategy=Xilinx Default (unlocked)
PROP_ManualCompileOrderImp=false | PROP_PropSpecInProjFile=Store all values
PROP_Simulator=ISim (VHDL/Verilog) | PROP_SynthTopFile=changed
PROP_Top_Level_Module_Type=HDL | PROP_UseSmartGuide=false
PROP_UserConstraintEditorPreference=Text Editor | PROP_intProjectCreationTimestamp=2019-09-11T18:18:24
PROP_intWbtProjectID=39D5E1AE095B4F1DA23FEED56505DFA0 | PROP_intWbtProjectIteration=2
PROP_intWorkingDirLocWRTProjDir=Same | PROP_intWorkingDirUsed=No
PROP_AutoTop=true | PROP_DevFamily=Spartan3E
PROP_DevDevice=xc3s100e | PROP_DevFamilyPMName=spartan3e
PROP_DevPackage=tq144 | PROP_Synthesis_Tool=XST (VHDL/Verilog)
PROP_DevSpeed=-4 | PROP_PreferredLanguage=Verilog
FILE_UCF=1 | FILE_VHDL=3

Unisim Statistics
NGDBUILD_PRE_UNISIM_SUMMARY
NGDBUILD_NUM_BUFGP=1 | NGDBUILD_NUM_FDC=29 | NGDBUILD_NUM_FDCE=28 | NGDBUILD_NUM_GND=1
NGDBUILD_NUM_IBUF=3 | NGDBUILD_NUM_INV=30 | NGDBUILD_NUM_LUT1=39 | NGDBUILD_NUM_LUT2=36
NGDBUILD_NUM_LUT2_L=4 | NGDBUILD_NUM_LUT3=16 | NGDBUILD_NUM_LUT4=43 | NGDBUILD_NUM_LUT4_D=2
NGDBUILD_NUM_LUT4_L=2 | NGDBUILD_NUM_MUXCY=84 | NGDBUILD_NUM_MUXF5=4 | NGDBUILD_NUM_OBUF=13
NGDBUILD_NUM_VCC=1 | NGDBUILD_NUM_XORCY=85
NGDBUILD_POST_UNISIM_SUMMARY
NGDBUILD_NUM_BUFG=1 | NGDBUILD_NUM_FDC=29 | NGDBUILD_NUM_FDCE=28 | NGDBUILD_NUM_GND=1
NGDBUILD_NUM_IBUF=3 | NGDBUILD_NUM_IBUFG=1 | NGDBUILD_NUM_INV=30 | NGDBUILD_NUM_LUT1=39
NGDBUILD_NUM_LUT2=36 | NGDBUILD_NUM_LUT2_L=4 | NGDBUILD_NUM_LUT3=16 | NGDBUILD_NUM_LUT4=43
NGDBUILD_NUM_LUT4_D=2 | NGDBUILD_NUM_LUT4_L=2 | NGDBUILD_NUM_MUXCY=84 | NGDBUILD_NUM_MUXF5=4
NGDBUILD_NUM_OBUF=13 | NGDBUILD_NUM_VCC=1 | NGDBUILD_NUM_XORCY=85

XST Command Line Options
XST_OPTION_SUMMARY
-ifn=<fname>.prj | -ifmt=mixed | -ofn=<design_top> | -ofmt=NGC
-p=xc3s100e-4-tq144 | -top=<design_top> | -opt_mode=Speed | -opt_level=1
-iuc=NO | -keep_hierarchy=No | -netlist_hierarchy=As_Optimized | -rtlview=Yes
-glob_opt=AllClockNets | -read_cores=YES | -write_timing_constraints=NO | -cross_clock_analysis=NO
-bus_delimiter=<> | -slice_utilization_ratio=100 | -bram_utilization_ratio=100 | -verilog2001=YES
-fsm_extract=YES | -fsm_encoding=Auto | -safe_implementation=No | -fsm_style=LUT
-ram_extract=Yes | -ram_style=Auto | -rom_extract=Yes | -shreg_extract=YES
-rom_style=Auto | -auto_bram_packing=NO | -resource_sharing=YES | -async_to_sync=NO
-mult_style=Auto | -iobuf=YES | -max_fanout=500 | -bufg=24
-register_duplication=YES | -register_balancing=No | -optimize_primitives=NO | -use_clock_enable=Yes
-use_sync_set=Yes | -use_sync_reset=Yes | -iob=Auto | -equivalent_register_removal=YES

-slice_utilization_ratio_maxmargin=5
