clararodellar/TFG/Electronica_control/Codigos/FPGA/PWM_prueba_lazocerrado_v3/juntar_summary.html

juntar Project Status (09/19/2019 - 16:14:55)
Project File: | PWM_prueba_lazocerrado_v3.xise | Parser Errors: | No Errors
Module Name: | juntar | Implementation State: | Programming File Generated
Target Device: | xc3s100e-4tq144 | Errors: | No Errors
Product Version: | ISE 14.7 | Warnings: | 12 Warnings (7 new)
Design Goal: | Balanced | Routing Results: | All Signals Completely Routed
Design Strategy: | Xilinx Default (unlocked) | Timing Constraints: | All Constraints Met
Environment: | System Settings | Final Timing Score: | 0 (Timing Report)

Device Utilization Summary | | | | | [-]
Logic Utilization | Used | Available | Utilization | Note(s)
Number of Slice Flip Flops | 163 | 1,920 | 8%
Number of 4 input LUTs | 337 | 1,920 | 17%
Number of occupied Slices | 239 | 960 | 24%
Number of Slices containing only related logic | 239 | 239 | 100%
Number of Slices containing unrelated logic | 0 | 239 | 0%
Total Number of 4 input LUTs | 410 | 1,920 | 21%
Number used as logic | 337
Number used as a route-thru | 73
Number of bonded IOBs | 28 | 108 | 25%
IOB Flip Flops | 1
Number of BUFGMUXs | 1 | 24 | 4%
Average Fanout of Non-Clock Nets | 3.06

Performance Summary | | | | [-]
Final Timing Score: | 0 (Setup: 0, Hold: 0) | Pinout Data: | Pinout Report
Routing Results: | All Signals Completely Routed | Clock Data: | Clock Report
Timing Constraints: | All Constraints Met

Detailed Reports | | | | | | [-]
Report Name | Status | Generated | Errors | Warnings | Infos
Synthesis Report | Current | lu. 23. sep. 18:12:30 2019 | 0 | 7 Warnings (7 new) | 1 Info (1 new)
Translation Report | Current | lu. 23. sep. 18:12:43 2019 | 0 | 0 | 0
Map Report | Current | lu. 23. sep. 18:12:48 2019 | 0 | 1 Warning (0 new) | 3 Infos (0 new)
Place and Route Report | Current | lu. 23. sep. 18:12:59 2019 | 0 | 3 Warnings (0 new) | 2 Infos (0 new)
Power Report
Post-PAR Static Timing Report | Current | lu. 23. sep. 18:13:03 2019 | 0 | 0 | 6 Infos (0 new)
Bitgen Report | Current | lu. 23. sep. 18:13:09 2019 | 0 | 1 Warning (0 new) | 0

Secondary Reports | | | [-]
Report Name | Status | Generated
ISIM Simulator Log | Out of Date | ju. 19. sep. 16:11:47 2019
WebTalk Report | Current | lu. 23. sep. 18:13:10 2019
WebTalk Log File | Current | lu. 23. sep. 18:13:15 2019

Date Generated: 10/11/2019 - 10:57:06
