clararodellar/TFG/Electronica_control/Codigos/FPGA/prueba_vueltas/juntar_summary.html

juntar Project Status
Project File: | prueba_vueltas.xise | Parser Errors: | No Errors
Module Name: | juntar | Implementation State: | Programming File Generated
Target Device: | xc3s100e-4tq144 | Errors: | No Errors
Product Version: | ISE 14.7 | Warnings: | 1 Warning (0 new)
Design Goal: | Balanced | Routing Results: | All Signals Completely Routed
Design Strategy: | Xilinx Default (unlocked) | Timing Constraints: | All Constraints Met
Environment: | System Settings | Final Timing Score: | 0 (Timing Report)

Device Utilization Summary | | | | | [-]
Logic Utilization | Used | Available | Utilization | Note(s)
Number of Slice Flip Flops | 57 | 1,920 | 2%
Number of 4 input LUTs | 117 | 1,920 | 6%
Number of occupied Slices | 83 | 960 | 8%
Number of Slices containing only related logic | 83 | 83 | 100%
Number of Slices containing unrelated logic | 0 | 83 | 0%
Total Number of 4 input LUTs | 150 | 1,920 | 7%
Number used as logic | 117
Number used as a route-thru | 33
Number of bonded IOBs | 17 | 108 | 15%
Number of BUFGMUXs | 1 | 24 | 4%
Average Fanout of Non-Clock Nets | 2.88

Performance Summary | | | | [-]
Final Timing Score: | 0 (Setup: 0, Hold: 0) | Pinout Data: | Pinout Report
Routing Results: | All Signals Completely Routed | Clock Data: | Clock Report
Timing Constraints: | All Constraints Met

Detailed Reports | | | | | | [-]
Report Name | Status | Generated | Errors | Warnings | Infos
Synthesis Report | Current | vi. 13. sep. 18:23:19 2019 | 0 | 0 | 2 Infos (0 new)
Translation Report | Current | vi. 13. sep. 18:23:26 2019 | 0 | 0 | 0
Map Report | Current | vi. 13. sep. 18:23:31 2019 | 0 | 1 Warning (0 new) | 2 Infos (0 new)
Place and Route Report | Current | vi. 13. sep. 18:23:41 2019 | 0 | 0 | 2 Infos (0 new)
Power Report
Post-PAR Static Timing Report | Current | vi. 13. sep. 18:23:44 2019 | 0 | 0 | 6 Infos (0 new)
Bitgen Report | Current | vi. 13. sep. 18:23:50 2019 | 0 | 0 | 0

Secondary Reports | | | [-]
Report Name | Status | Generated
WebTalk Report | Current | vi. 13. sep. 18:23:50 2019
WebTalk Log File | Current | vi. 13. sep. 18:23:54 2019

Date Generated: 09/13/2019 - 19:27:49
