clararodellar/TFG/(list of files, drawings)

Other design files:
Cinta_transportadora/Motor2/Conexion_potenciometro/esquema_motor_potenciometro.fzz
Cinta_transportadora/Motor2/Conexion_probada/esquema_motor.fzz
Cinta_transportadora/Motor2/Conexion_puenteH/esquema_motor_puenteH.fzz
Cinta_transportadora/Motor2/Conexion_puenteH/esquema_motor_puenteH_v01.fzz
Cinta_transportadora/Motor2/Conexion_puenteH/esquema_motor_puenteH_v02.fzz
Cinta_transportadora/Motor2/Conexion_puenteH_potenci_boton/esquema_motor_puenteH_potenci_motor.fzz
