clararodellar/TFG/Electronica_potencia/PCB/schematic.brd

## EAGLE design Electronica_potencia/PCB/schematic.brd (2019-02-16)

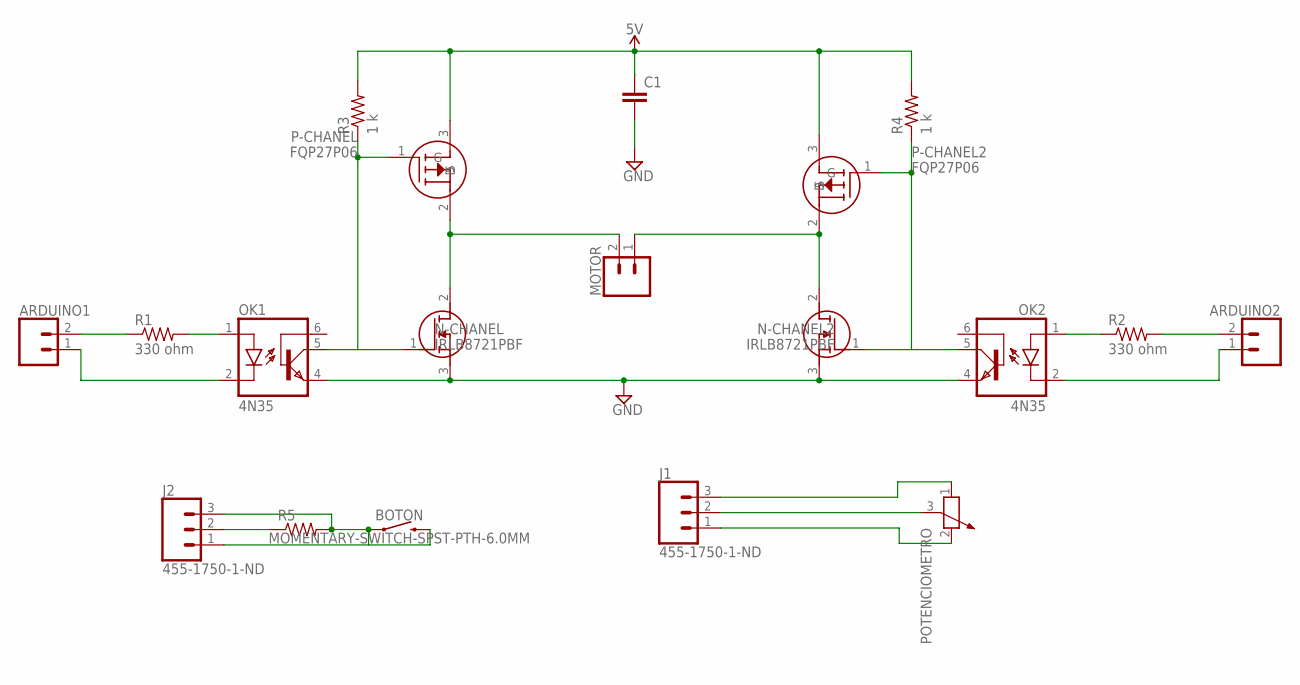
[picture p84: schematic schematic.sch]

Parts:
ARDUINO1, ARDUINO2: CONN_02; 1X02
BOTON: MOMENTARY-SWITCH-SPST-PTH-6.0MM; TACTILE_SWITCH_PTH_6.0MM
C1: C-EUC0805; C0805
J1, J2: 455-1750-1-ND; 1X03
MOTOR: CONN_02; 1X02
N-CHANEL, N-CHANEL2: IRLB8721PBF; TO254P483X1016X1994-3P
OK1, OK2: 4N35; DIL06
P-CHANEL, P-CHANEL2: FQP27P06; TO220
POTENCIOMETRO: POTENTIOMETER_PT-10S; PT-10S
R1, R2: 330 ohm; 0411/12
R3, R4: 1 k; 0411/12
R5: R-US_0411/12; 0411/12

Connections:
5V: C1.1, P-CHANEL.3 (S), P-CHANEL2.3 (S), R3.2, R4.2
GND: C1.2, N-CHANEL.3 (S), N-CHANEL2.3 (S), OK1.4 (EMI), OK2.4 (EMI)
unnamed: MOTOR.2, N-CHANEL.2 (D), P-CHANEL.2 (D)
unnamed: MOTOR.1, N-CHANEL2.2 (D), P-CHANEL2.2 (D)
unnamed: N-CHANEL2.1 (G), OK2.5 (COL), P-CHANEL2.1 (G), R4.1
unnamed: OK1.1 (A), R1.2
unnamed: N-CHANEL.1 (G), OK1.5 (COL), P-CHANEL.1 (G), R3.1
unnamed: ARDUINO1.2, R1.1
unnamed: ARDUINO1.1, OK1.2 (C)
unnamed: OK2.1 (A), R2.1
unnamed: ARDUINO2.2, R2.2
unnamed: ARDUINO2.1, OK2.2 (C)
unnamed: J2.2, R5.1
unnamed: J1.3, POTENCIOMETRO.1
unnamed: J1.2, POTENCIOMETRO.3
unnamed: J1.1, POTENCIOMETRO.2
unnamed: BOTON.1, J2.3, R5.2
unnamed: BOTON.3 (2), J2.1

Board: 2 copper layers, 19 parts (4 on the bottom side), 18 nets, no tracks yet.
