clararodellar/TFG/Electronica_control/Codigos/FPGA/PWM_prueba_lazocerrado_v3/isim/tb_juntar_isim_beh.exe.sim/work/a_0055186542_3212880686.c

/**********************************************************************/
/*   ____  ____                                                       */
/*  /   /\/   /                                                       */
/* /___/  \  /                                                        */
/* \   \   \/                                                       */
/*  \   \        Copyright (c) 2003-2009 Xilinx, Inc.                */
/*  /   /          All Right Reserved.                                 */
/* /---/   /\                                                         */
/* \   \  /  \                                                      */
/*  \___\/\___\                                                    */
/***********************************************************************/

/* This file is designed for use with ISim build 0x7708f090 */

#define XSI_HIDE_SYMBOL_SPEC true
#include "xsi.h"
#include <memory.h>
#ifdef __GNUC__
#include <stdlib.h>
#else
#include <malloc.h>
#define alloca _alloca
#endif
static const char *ng0 = "D:/URJC/4.CUARTO/TFG/TRABAJO/FPGA/PWM_prueba_lazocerrado_v3/pid.vhd";
extern char *IEEE_P_1242562249;

unsigned char ieee_p_1242562249_sub_1781471956_1035706684(char *, char *, char *, int );
unsigned char ieee_p_1242562249_sub_1781507893_1035706684(char *, char *, char *, int );
unsigned char ieee_p_1242562249_sub_1781543830_1035706684(char *, char *, char *, int );
char *ieee_p_1242562249_sub_1919365254_1035706684(char *, char *, char *, char *, int );
char *ieee_p_1242562249_sub_1919437128_1035706684(char *, char *, char *, char *, int );
unsigned char ieee_p_1242562249_sub_2110411308_1035706684(char *, char *, char *, char *, char *);


static void work_a_0055186542_3212880686_p_0(char *t0)
{
    char *t1;
    char *t2;
    char *t3;
    char *t4;
    unsigned char t5;
    char *t6;
    char *t7;
    char *t8;
    char *t9;
    char *t10;

LAB0:    xsi_set_current_line(27, ng0);
    t1 = (t0 + 1352U);
    t2 = *((char **)t1);
    t1 = (t0 + 8200U);
    t3 = (t0 + 1512U);
    t4 = *((char **)t3);
    t3 = (t0 + 8216U);
    t5 = ieee_p_1242562249_sub_2110411308_1035706684(IEEE_P_1242562249, t2, t1, t4, t3);
    if (t5 != 0)
        goto LAB2;

LAB4:    xsi_set_current_line(30, ng0);
    t1 = (t0 + 5248);
    t2 = (t1 + 56U);
    t3 = *((char **)t2);
    t4 = (t3 + 56U);
    t6 = *((char **)t4);
    *((unsigned char *)t6) = (unsigned char)2;
    xsi_driver_first_trans_fast(t1);

LAB3:    t1 = (t0 + 5104);
    *((int *)t1) = 1;

LAB1:    return;
LAB2:    xsi_set_current_line(28, ng0);
    t6 = (t0 + 5248);
    t7 = (t6 + 56U);
    t8 = *((char **)t7);
    t9 = (t8 + 56U);
    t10 = *((char **)t9);
    *((unsigned char *)t10) = (unsigned char)3;
    xsi_driver_first_trans_fast(t6);
    goto LAB3;

}

static void work_a_0055186542_3212880686_p_1(char *t0)
{
    char t20[16];
    char *t1;
    char *t2;
    unsigned char t3;
    unsigned char t4;
    char *t5;
    char *t6;
    char *t7;
    char *t8;
    char *t9;
    char *t10;
    unsigned char t11;
    unsigned char t12;
    unsigned char t13;
    unsigned char t14;
    unsigned char t15;
    char *t16;
    char *t17;
    char *t18;
    char *t19;
    unsigned int t21;
    unsigned int t22;

LAB0:    xsi_set_current_line(36, ng0);
    t1 = (t0 + 1192U);
    t2 = *((char **)t1);
    t3 = *((unsigned char *)t2);
    t4 = (t3 == (unsigned char)3);
    if (t4 != 0)
        goto LAB2;

LAB4:    t1 = (t0 + 992U);
    t4 = xsi_signal_has_event(t1);
    if (t4 == 1)
        goto LAB7;

LAB8:    t3 = (unsigned char)0;

LAB9:    if (t3 != 0)
        goto LAB5;

LAB6:
LAB3:    t1 = (t0 + 5120);
    *((int *)t1) = 1;

LAB1:    return;
LAB2:    xsi_set_current_line(37, ng0);
    t1 = xsi_get_transient_memory(4U);
    memset(t1, 0, 4U);
    t5 = t1;
    memset(t5, (unsigned char)2, 4U);
    t6 = (t0 + 5312);
    t7 = (t6 + 56U);
    t8 = *((char **)t7);
    t9 = (t8 + 56U);
    t10 = *((char **)t9);
    memcpy(t10, t1, 4U);
    xsi_driver_first_trans_fast(t6);
    goto LAB3;

LAB5:    xsi_set_current_line(39, ng0);
    t2 = (t0 + 1832U);
    t6 = *((char **)t2);
    t13 = *((unsigned char *)t6);
    t14 = (t13 == (unsigned char)3);
    if (t14 != 0)
        goto LAB10;

LAB12:
LAB11:    goto LAB3;

LAB7:    t2 = (t0 + 1032U);
    t5 = *((char **)t2);
    t11 = *((unsigned char *)t5);
    t12 = (t11 == (unsigned char)3);
    t3 = t12;
    goto LAB9;

LAB10:    xsi_set_current_line(40, ng0);
    t2 = (t0 + 2472U);
    t7 = *((char **)t2);
    t2 = (t0 + 8264U);
    t15 = ieee_p_1242562249_sub_1781507893_1035706684(IEEE_P_1242562249, t7, t2, 5);
    if (t15 != 0)
        goto LAB13;

LAB15:    xsi_set_current_line(43, ng0);
    t1 = (t0 + 2472U);
    t2 = *((char **)t1);
    t1 = (t0 + 8264U);
    t5 = ieee_p_1242562249_sub_1919365254_1035706684(IEEE_P_1242562249, t20, t2, t1, 1);
    t6 = (t20 + 12U);
    t21 = *((unsigned int *)t6);
    t22 = (1U * t21);
    t3 = (4U != t22);
    if (t3 == 1)
        goto LAB16;

LAB17:    t7 = (t0 + 5312);
    t8 = (t7 + 56U);
    t9 = *((char **)t8);
    t10 = (t9 + 56U);
    t16 = *((char **)t10);
    memcpy(t16, t5, 4U);
    xsi_driver_first_trans_fast(t7);

LAB14:    goto LAB11;

LAB13:    xsi_set_current_line(41, ng0);
    t8 = xsi_get_transient_memory(4U);
    memset(t8, 0, 4U);
    t9 = t8;
    memset(t9, (unsigned char)2, 4U);
    t10 = (t0 + 5312);
    t16 = (t10 + 56U);
    t17 = *((char **)t16);
    t18 = (t17 + 56U);
    t19 = *((char **)t18);
    memcpy(t19, t8, 4U);
    xsi_driver_first_trans_fast(t10);
    goto LAB14;

LAB16:    xsi_size_not_matching(4U, t22, 0);
    goto LAB17;

}

static void work_a_0055186542_3212880686_p_2(char *t0)
{
    unsigned char t1;
    char *t2;
    char *t3;
    unsigned char t4;
    char *t5;
    char *t6;
    unsigned char t7;
    unsigned char t8;
    char *t9;
    char *t10;
    char *t11;
    char *t12;
    char *t13;
    char *t14;
    char *t15;
    char *t16;
    char *t17;
    char *t18;

LAB0:    xsi_set_current_line(49, ng0);
    t2 = (t0 + 2472U);
    t3 = *((char **)t2);
    t2 = (t0 + 8264U);
    t4 = ieee_p_1242562249_sub_1781507893_1035706684(IEEE_P_1242562249, t3, t2, 5);
    if (t4 == 1)
        goto LAB5;

LAB6:    t1 = (unsigned char)0;

LAB7:    if (t1 != 0)
        goto LAB3;

LAB4:
LAB8:    t13 = (t0 + 5376);
    t14 = (t13 + 56U);
    t15 = *((char **)t14);
    t16 = (t15 + 56U);
    t17 = *((char **)t16);
    *((unsigned char *)t17) = (unsigned char)2;
    xsi_driver_first_trans_fast(t13);

LAB2:    t18 = (t0 + 5136);
    *((int *)t18) = 1;

LAB1:    return;
LAB3:    t5 = (t0 + 5376);
    t9 = (t5 + 56U);
    t10 = *((char **)t9);
    t11 = (t10 + 56U);
    t12 = *((char **)t11);
    *((unsigned char *)t12) = (unsigned char)3;
    xsi_driver_first_trans_fast(t5);
    goto LAB2;

LAB5:    t5 = (t0 + 1832U);
    t6 = *((char **)t5);
    t7 = *((unsigned char *)t6);
    t8 = (t7 == (unsigned char)3);
    t1 = t8;
    goto LAB7;

LAB9:    goto LAB2;

}

static void work_a_0055186542_3212880686_p_3(char *t0)
{
    char t16[16];
    char *t1;
    char *t2;
    unsigned char t3;
    unsigned char t4;
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
    goto LAB26;

LAB28:    xsi_size_not_matching(16U, t18, 0);
    goto LAB29;

}

static void work_a_0055186542_3212880686_p_4(char *t0)
{
    char *t1;
    char *t2;
    char *t3;
    char *t4;
    char *t5;
    char *t6;
    char *t7;

LAB0:    xsi_set_current_line(72, ng0);

LAB3:    t1 = (t0 + 2152U);
    t2 = *((char **)t1);
    t1 = (t0 + 5504);
    t3 = (t1 + 56U);
    t4 = *((char **)t3);
    t5 = (t4 + 56U);
    t6 = *((char **)t5);
    memcpy(t6, t2, 16U);
    xsi_driver_first_trans_fast_port(t1);

LAB2:    t7 = (t0 + 5168);
    *((int *)t7) = 1;

LAB1:    return;
LAB4:    goto LAB2;

}


extern void work_a_0055186542_3212880686_init()
{
	static char *pe[] = {(void *)work_a_0055186542_3212880686_p_0,(void *)work_a_0055186542_3212880686_p_1,(void *)work_a_0055186542_3212880686_p_2,(void *)work_a_0055186542_3212880686_p_3,(void *)work_a_0055186542_3212880686_p_4};
	xsi_register_didat("work_a_0055186542_3212880686", "isim/tb_juntar_isim_beh.exe.sim/work/a_0055186542_3212880686.didat");
	xsi_register_executes(pe);
}
