clararodellar/TFG/Electronica_control/Codigos/FPGA/PWM_prueba_lazocerrado_v3/isim/tb_juntar_isim_beh.exe.sim/work/a_1209826792_3212880686.c

/**********************************************************************/
/*   ____  ____                                                       */
/*  /   /\/   /                                                       */
/* /___/  \  /                                                        */
/* \   \   \/                                                       */
/*  \   \        Copyright (c) 2003-2009 Xilinx, Inc.                */
/*  /   /          All Right Reserved.                                 */
/* /---/   /\                                                         */
/* \   \  /  \                                                      */
/*  \___\/\___\                                                    */
/***********************************************************************/

/* This file is designed for use with ISim build 0x7708f090 */

#define XSI_HIDE_SYMBOL_SPEC true
#include "xsi.h"
#include <memory.h>
#ifdef __GNUC__
#include <stdlib.h>
#else
#include <malloc.h>
#define alloca _alloca
#endif
static const char *ng0 = "D:/URJC/4.CUARTO/TFG/TRABAJO/FPGA/PWM_prueba_lazocerrado_v3/PWM_motor.vhd";
extern char *IEEE_P_2592010699;
extern char *IEEE_P_1242562249;

char *ieee_p_1242562249_sub_1547198987_1035706684(char *, char *, char *, char *, char *, char *);
char *ieee_p_1242562249_sub_1547270861_1035706684(char *, char *, char *, char *, char *, char *);
unsigned char ieee_p_1242562249_sub_1781471956_1035706684(char *, char *, char *, int );
unsigned char ieee_p_1242562249_sub_1781507893_1035706684(char *, char *, char *, int );
unsigned char ieee_p_1242562249_sub_1781543830_1035706684(char *, char *, char *, int );
char *ieee_p_1242562249_sub_1919365254_1035706684(char *, char *, char *, char *, int );
unsigned char ieee_p_1242562249_sub_2110339434_1035706684(char *, char *, char *, char *, char *);
unsigned char ieee_p_1242562249_sub_2110375371_1035706684(char *, char *, char *, char *, char *);
unsigned char ieee_p_2592010699_sub_2545490612_503743352(char *, unsigned char , unsigned char );


static void work_a_1209826792_3212880686_p_0(char *t0)
{
    char *t1;
    char *t2;
    unsigned char t3;
    unsigned char t4;
    char *t5;
    char *t6;
    char *t7;
    char *t8;
    unsigned char t9;
    unsigned char t10;
    unsigned char t11;
    char *t12;
    char *t13;

LAB0:    xsi_set_current_line(113, ng0);
    t1 = (t0 + 1192U);
    t2 = *((char **)t1);
    t3 = *((unsigned char *)t2);
    t4 = (t3 == (unsigned char)3);
    if (t4 != 0)
        goto LAB2;

LAB4:    t1 = (t0 + 992U);
    t4 = xsi_signal_has_event(t1);
    if (t4 == 1)
        goto LAB7;

LAB8:    t3 = (unsigned char)0;

LAB9:    if (t3 != 0)
        goto LAB5;

LAB6:
LAB3:    t1 = (t0 + 17016);
    *((int *)t1) = 1;

LAB1:    return;
LAB2:    xsi_set_current_line(114, ng0);
    t1 = (t0 + 17544);
    t5 = (t1 + 56U);
    t6 = *((char **)t5);
    t7 = (t6 + 56U);
    t8 = *((char **)t7);
    *((unsigned char *)t8) = (unsigned char)2;
    xsi_driver_first_trans_fast(t1);
    xsi_set_current_line(115, ng0);
    t1 = (t0 + 17608);
    t2 = (t1 + 56U);
    t5 = *((char **)t2);
    t6 = (t5 + 56U);
    t7 = *((char **)t6);
    *((unsigned char *)t7) = (unsigned char)2;
    xsi_driver_first_trans_fast(t1);
    goto LAB3;

LAB5:    xsi_set_current_line(117, ng0);
    t2 = (t0 + 1352U);
    t6 = *((char **)t2);
    t11 = *((unsigned char *)t6);
    t2 = (t0 + 17544);
    t7 = (t2 + 56U);
    t8 = *((char **)t7);
    t12 = (t8 + 56U);
    t13 = *((char **)t12);
    *((unsigned char *)t13) = t11;
    xsi_driver_first_trans_fast(t2);
    xsi_set_current_line(118, ng0);
    t1 = (t0 + 6792U);
    t2 = *((char **)t1);
    t3 = *((unsigned char *)t2);
    t1 = (t0 + 17608);
    t5 = (t1 + 56U);
    t6 = *((char **)t5);
    t7 = (t6 + 56U);
    t8 = *((char **)t7);
    *((unsigned char *)t8) = t3;
    xsi_driver_first_trans_fast(t1);
    goto LAB3;

LAB7:    t2 = (t0 + 1032U);
    t5 = *((char **)t2);
    t9 = *((unsigned char *)t5);
    t10 = (t9 == (unsigned char)3);
    t3 = t10;
    goto LAB9;

}

static void work_a_1209826792_3212880686_p_1(char *t0)
{
    unsigned char t1;
    char *t2;
    char *t3;
    unsigned char t4;
    unsigned char t5;
    char *t6;
    unsigned char t7;
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
    goto LAB3;

LAB13:    t5 = 0;

LAB16:    if (t5 < 3U)
        goto LAB17;
    else
        goto LAB15;

LAB17:    t6 = (t2 + t5);
    t7 = (t1 + t5);
    if (*((unsigned char *)t6) != *((unsigned char *)t7))
        goto LAB14;

LAB18:    t5 = (t5 + 1);
    goto LAB16;

LAB19:    xsi_set_current_line(158, ng0);
    t8 = (t0 + 28946);
    t10 = (t0 + 17992);
    t11 = (t10 + 56U);
    t12 = *((char **)t11);
    t13 = (t12 + 56U);
    t14 = *((char **)t13);
    memcpy(t14, t8, 7U);
    xsi_driver_first_trans_fast(t10);
    goto LAB3;

LAB21:    t5 = 0;

LAB24:    if (t5 < 3U)
        goto LAB25;
    else
        goto LAB23;

LAB25:    t6 = (t2 + t5);
    t7 = (t1 + t5);
    if (*((unsigned char *)t6) != *((unsigned char *)t7))
        goto LAB22;

LAB26:    t5 = (t5 + 1);
    goto LAB24;

}

static void work_a_1209826792_3212880686_p_5(char *t0)
{
    char t22[16];
    char *t1;
    char *t2;
    unsigned char t3;
    unsigned char t4;
    char *t5;
    char *t6;
    char *t7;
    char *t8;
    char *t9;
    char *t10;
    unsigned char t11;
    unsigned char t12;
    unsigned char t13;
    unsigned char t14;
    unsigned char t15;
    unsigned char t16;
    char *t17;
    char *t18;
    char *t19;
    char *t20;
    char *t21;
    unsigned int t23;
    unsigned int t24;

LAB0:    xsi_set_current_line(170, ng0);
    t1 = (t0 + 1192U);
    t2 = *((char **)t1);
    t3 = *((unsigned char *)t2);
    t4 = (t3 == (unsigned char)3);
    if (t4 != 0)
        goto LAB2;

LAB4:    t1 = (t0 + 992U);
    t4 = xsi_signal_has_event(t1);
    if (t4 == 1)
        goto LAB7;

LAB8:    t3 = (unsigned char)0;

LAB9:    if (t3 != 0)
        goto LAB5;

LAB6:
LAB3:    t1 = (t0 + 17096);
    *((int *)t1) = 1;

LAB1:    return;
LAB2:    xsi_set_current_line(171, ng0);
    t1 = xsi_get_transient_memory(8U);
    memset(t1, 0, 8U);
    t5 = t1;
    memset(t5, (unsigned char)2, 8U);
    t6 = (t0 + 18056);
    t7 = (t6 + 56U);
    t8 = *((char **)t7);
    t9 = (t8 + 56U);
    t10 = *((char **)t9);
    memcpy(t10, t1, 8U);
    xsi_driver_first_trans_fast(t6);
    goto LAB3;

LAB5:    xsi_set_current_line(173, ng0);
    t2 = (t0 + 7112U);
    t6 = *((char **)t2);
    t13 = *((unsigned char *)t6);
    t14 = (t13 == (unsigned char)3);
    if (t14 != 0)
        goto LAB10;

LAB12:    t1 = (t0 + 7592U);
    t2 = *((char **)t1);
    t3 = *((unsigned char *)t2);
    t4 = (t3 == (unsigned char)3);
    if (t4 != 0)
        goto LAB35;

LAB36:
LAB11:    goto LAB3;

LAB7:    t2 = (t0 + 1032U);
    t5 = *((char **)t2);
    t11 = *((unsigned char *)t5);
    t12 = (t11 == (unsigned char)3);
    t3 = t12;
    goto LAB9;

LAB10:    xsi_set_current_line(174, ng0);
    t2 = (t0 + 7752U);
    t7 = *((char **)t2);
    t2 = (t0 + 28652U);
    t15 = ieee_p_1242562249_sub_1781507893_1035706684(IEEE_P_1242562249, t7, t2, 1);
    if (t15 != 0)
        goto LAB13;

LAB15:    t1 = (t0 + 7752U);
    t2 = *((char **)t1);
    t1 = (t0 + 28652U);
    t3 = ieee_p_1242562249_sub_1781507893_1035706684(IEEE_P_1242562249, t2, t1, 10);
    if (t3 != 0)
        goto LAB21;

LAB22:    t1 = (t0 + 7752U);
    t2 = *((char **)t1);
    t1 = (t0 + 28652U);
    t3 = ieee_p_1242562249_sub_1781507893_1035706684(IEEE_P_1242562249, t2, t1, 100);
    if (t3 != 0)
        goto LAB28;

LAB29:
LAB14:    goto LAB11;

LAB13:    xsi_set_current_line(175, ng0);
    t8 = (t0 + 4712U);
    t9 = *((char **)t8);
    t8 = (t0 + 28508U);
    t16 = ieee_p_1242562249_sub_1781507893_1035706684(IEEE_P_1242562249, t9, t8, 255);
    if (t16 != 0)
        goto LAB16;

LAB18:    xsi_set_current_line(178, ng0);
    t1 = (t0 + 4712U);
    t2 = *((char **)t1);
    t1 = (t0 + 28508U);
    t5 = (t0 + 7752U);
    t6 = *((char **)t5);
    t5 = (t0 + 28652U);
    t7 = ieee_p_1242562249_sub_1547198987_1035706684(IEEE_P_1242562249, t22, t2, t1, t6, t5);
    t8 = (t22 + 12U);
    t23 = *((unsigned int *)t8);
    t24 = (1U * t23);
    t3 = (8U != t24);
    if (t3 == 1)
        goto LAB19;

LAB20:    t9 = (t0 + 18056);
    t10 = (t9 + 56U);
    t17 = *((char **)t10);
    t18 = (t17 + 56U);
    t19 = *((char **)t18);
    memcpy(t19, t7, 8U);
    xsi_driver_first_trans_fast(t9);

LAB17:    goto LAB14;

LAB16:    xsi_set_current_line(176, ng0);
    t10 = (t0 + 4712U);
    t17 = *((char **)t10);
    t10 = (t0 + 18056);
    t18 = (t10 + 56U);
    t19 = *((char **)t18);
    t20 = (t19 + 56U);
    t21 = *((char **)t20);
    memcpy(t21, t17, 8U);
    xsi_driver_first_trans_fast(t10);
    goto LAB17;

LAB19:    xsi_size_not_matching(8U, t24, 0);
    goto LAB20;

LAB21:    xsi_set_current_line(181, ng0);
    t5 = (t0 + 4712U);
    t6 = *((char **)t5);
    t5 = (t0 + 28508U);
    t4 = ieee_p_1242562249_sub_1781543830_1035706684(IEEE_P_1242562249, t6, t5, 245);
    if (t4 != 0)
        goto LAB23;

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
    char *t5;
    char *t6;
    char *t7;
    char *t8;
    char *t9;
    char *t10;
    unsigned char t11;
    unsigned char t12;
    int t13;
    int t14;
    unsigned char t15;
    char *t16;
    char *t17;
    char *t18;
    char *t19;
    unsigned int t21;
    unsigned int t22;

LAB0:    xsi_set_current_line(223, ng0);
    t1 = (t0 + 1192U);
    t2 = *((char **)t1);
    t3 = *((unsigned char *)t2);
    t4 = (t3 == (unsigned char)3);
    if (t4 != 0)
        goto LAB2;

LAB4:    t1 = (t0 + 992U);
    t4 = xsi_signal_has_event(t1);
    if (t4 == 1)
        goto LAB7;

LAB8:    t3 = (unsigned char)0;

LAB9:    if (t3 != 0)
        goto LAB5;

LAB6:
LAB3:    t1 = (t0 + 17112);
    *((int *)t1) = 1;

LAB1:    return;
LAB2:    xsi_set_current_line(224, ng0);
    t1 = xsi_get_transient_memory(10U);
    memset(t1, 0, 10U);
    t5 = t1;
    memset(t5, (unsigned char)2, 10U);
    t6 = (t0 + 18120);
    t7 = (t6 + 56U);
    t8 = *((char **)t7);
    t9 = (t8 + 56U);
    t10 = *((char **)t9);
    memcpy(t10, t1, 10U);
    xsi_driver_first_trans_fast(t6);
    goto LAB3;

LAB5:    xsi_set_current_line(226, ng0);
    t2 = (t0 + 5352U);
    t6 = *((char **)t2);
    t2 = (t0 + 28572U);
    t7 = (t0 + 8528U);
    t8 = *((char **)t7);
    t13 = *((int *)t8);
    t14 = (t13 - 1);
    t15 = ieee_p_1242562249_sub_1781507893_1035706684(IEEE_P_1242562249, t6, t2, t14);
    if (t15 != 0)
        goto LAB10;

LAB12:    xsi_set_current_line(229, ng0);
    t1 = (t0 + 5352U);
    t2 = *((char **)t1);
    t1 = (t0 + 28572U);
    t5 = ieee_p_1242562249_sub_1919365254_1035706684(IEEE_P_1242562249, t20, t2, t1, 1);
    t6 = (t20 + 12U);
    t21 = *((unsigned int *)t6);
    t22 = (1U * t21);
    t3 = (10U != t22);
    if (t3 == 1)
        goto LAB13;

LAB14:    t7 = (t0 + 18120);
    t8 = (t7 + 56U);
    t9 = *((char **)t8);
    t10 = (t9 + 56U);
    t16 = *((char **)t10);
    memcpy(t16, t5, 10U);
    xsi_driver_first_trans_fast(t7);

LAB11:    goto LAB3;

LAB7:    t2 = (t0 + 1032U);
    t5 = *((char **)t2);
    t11 = *((unsigned char *)t5);
    t12 = (t11 == (unsigned char)3);
    t3 = t12;
    goto LAB9;

LAB10:    xsi_set_current_line(227, ng0);
    t7 = xsi_get_transient_memory(10U);
    memset(t7, 0, 10U);
    t9 = t7;
    memset(t9, (unsigned char)2, 10U);
    t10 = (t0 + 18120);
    t16 = (t10 + 56U);
    t17 = *((char **)t16);
    t18 = (t17 + 56U);
    t19 = *((char **)t18);
    memcpy(t19, t7, 10U);
    xsi_driver_first_trans_fast(t10);
    goto LAB11;

LAB13:    xsi_size_not_matching(10U, t22, 0);
    goto LAB14;

}

static void work_a_1209826792_3212880686_p_7(char *t0)
{
    char *t1;
    char *t2;
    char *t3;
    char *t4;
    int t5;
    int t6;
    unsigned char t7;
    char *t8;
    char *t9;
    char *t10;
    char *t11;
    char *t12;
    char *t13;
    char *t14;
    char *t15;
    char *t16;
    char *t17;

LAB0:    xsi_set_current_line(234, ng0);
    t1 = (t0 + 5352U);
    t2 = *((char **)t1);
    t1 = (t0 + 28572U);
    t3 = (t0 + 8528U);
    t4 = *((char **)t3);
    t5 = *((int *)t4);
    t6 = (t5 - 1);
    t7 = ieee_p_1242562249_sub_1781507893_1035706684(IEEE_P_1242562249, t2, t1, t6);
    if (t7 != 0)
        goto LAB3;

LAB4:
LAB5:    t12 = (t0 + 18184);
    t13 = (t12 + 56U);
    t14 = *((char **)t13);
    t15 = (t14 + 56U);
    t16 = *((char **)t15);
    *((unsigned char *)t16) = (unsigned char)2;
    xsi_driver_first_trans_fast(t12);

LAB2:    t17 = (t0 + 17128);
    *((int *)t17) = 1;

LAB1:    return;
LAB3:    t3 = (t0 + 18184);
    t8 = (t3 + 56U);
    t9 = *((char **)t8);
    t10 = (t9 + 56U);
    t11 = *((char **)t10);
    *((unsigned char *)t11) = (unsigned char)3;
    xsi_driver_first_trans_fast(t3);
    goto LAB2;

LAB6:    goto LAB2;

}

static void work_a_1209826792_3212880686_p_8(char *t0)
{
    char t20[16];
    char *t1;
    char *t2;
    unsigned char t3;
    unsigned char t4;
    char *t5;
    char *t6;
    char *t7;
    char *t8;
    char *t9;
    char *t10;
    unsigned char t11;
    unsigned char t12;
    unsigned char t13;
    unsigned char t14;
    unsigned char t15;
    char *t16;
    char *t17;
    char *t18;
    char *t19;
    unsigned int t21;
    unsigned int t22;

LAB0:    xsi_set_current_line(243, ng0);
    t1 = (t0 + 1192U);
    t2 = *((char **)t1);
    t3 = *((unsigned char *)t2);
    t4 = (t3 == (unsigned char)3);
    if (t4 != 0)
        goto LAB2;

LAB4:    t1 = (t0 + 992U);
    t4 = xsi_signal_has_event(t1);
    if (t4 == 1)
        goto LAB7;

LAB8:    t3 = (unsigned char)0;

LAB9:    if (t3 != 0)
        goto LAB5;

LAB6:
LAB3:    t1 = (t0 + 17144);
    *((int *)t1) = 1;

LAB1:    return;
LAB2:    xsi_set_current_line(244, ng0);
    t1 = xsi_get_transient_memory(8U);
    memset(t1, 0, 8U);
    t5 = t1;
    memset(t5, (unsigned char)2, 8U);
    t6 = (t0 + 18248);
    t7 = (t6 + 56U);
    t8 = *((char **)t7);
    t9 = (t8 + 56U);
    t10 = *((char **)t9);
    memcpy(t10, t1, 8U);
    xsi_driver_first_trans_fast(t6);
    goto LAB3;

LAB5:    xsi_set_current_line(246, ng0);
    t2 = (t0 + 5512U);
    t6 = *((char **)t2);
    t13 = *((unsigned char *)t6);
    t14 = (t13 == (unsigned char)3);
    if (t14 != 0)
        goto LAB10;

LAB12:
LAB11:    goto LAB3;

LAB7:    t2 = (t0 + 1032U);
    t5 = *((char **)t2);
    t11 = *((unsigned char *)t5);
    t12 = (t11 == (unsigned char)3);
    t3 = t12;
    goto LAB9;

LAB10:    xsi_set_current_line(247, ng0);
    t2 = (t0 + 6472U);
    t7 = *((char **)t2);
    t2 = (t0 + 28636U);
    t15 = ieee_p_1242562249_sub_1781507893_1035706684(IEEE_P_1242562249, t7, t2, 255);
    if (t15 != 0)
        goto LAB13;

LAB15:    xsi_set_current_line(250, ng0);
    t1 = (t0 + 6472U);
    t2 = *((char **)t1);
    t1 = (t0 + 28636U);
    t5 = ieee_p_1242562249_sub_1919365254_1035706684(IEEE_P_1242562249, t20, t2, t1, 1);
    t6 = (t20 + 12U);
    t21 = *((unsigned int *)t6);
    t22 = (1U * t21);
    t3 = (8U != t22);
    if (t3 == 1)
        goto LAB16;

LAB17:    t7 = (t0 + 18248);
    t8 = (t7 + 56U);
    t9 = *((char **)t8);
    t10 = (t9 + 56U);
    t16 = *((char **)t10);
    memcpy(t16, t5, 8U);
    xsi_driver_first_trans_fast(t7);

LAB14:    goto LAB11;

LAB13:    xsi_set_current_line(248, ng0);
    t8 = xsi_get_transient_memory(8U);
    memset(t8, 0, 8U);
    t9 = t8;
    memset(t9, (unsigned char)2, 8U);
    t10 = (t0 + 18248);
    t16 = (t10 + 56U);
    t17 = *((char **)t16);
    t18 = (t17 + 56U);
    t19 = *((char **)t18);
    memcpy(t19, t8, 8U);
    xsi_driver_first_trans_fast(t10);
    goto LAB14;

LAB16:    xsi_size_not_matching(8U, t22, 0);
    goto LAB17;

}

static void work_a_1209826792_3212880686_p_9(char *t0)
{
    unsigned char t1;
    char *t2;
    char *t3;
    unsigned char t4;
    char *t5;
    char *t6;
    unsigned char t7;
    unsigned char t8;
    char *t9;
    char *t10;
    char *t11;
    char *t12;
    char *t13;
    char *t14;
    char *t15;
    char *t16;
    char *t17;
    char *t18;

LAB0:    xsi_set_current_line(256, ng0);
    t2 = (t0 + 6472U);
    t3 = *((char **)t2);
    t2 = (t0 + 28636U);
    t4 = ieee_p_1242562249_sub_1781507893_1035706684(IEEE_P_1242562249, t3, t2, 255);
    if (t4 == 1)
        goto LAB5;

LAB6:    t1 = (unsigned char)0;

LAB7:    if (t1 != 0)
        goto LAB3;

LAB4:
LAB8:    t13 = (t0 + 18312);
    t14 = (t13 + 56U);
    t15 = *((char **)t14);
    t16 = (t15 + 56U);
    t17 = *((char **)t16);
    *((unsigned char *)t17) = (unsigned char)2;
    xsi_driver_first_trans_fast_port(t13);

LAB2:    t18 = (t0 + 17160);
    *((int *)t18) = 1;

LAB1:    return;
LAB3:    t5 = (t0 + 18312);
    t9 = (t5 + 56U);
    t10 = *((char **)t9);
    t11 = (t10 + 56U);
    t12 = *((char **)t11);
    *((unsigned char *)t12) = (unsigned char)3;
    xsi_driver_first_trans_fast_port(t5);
    goto LAB2;

LAB5:    t5 = (t0 + 5512U);
    t6 = *((char **)t5);
    t7 = *((unsigned char *)t6);
    t8 = (t7 == (unsigned char)3);
    t1 = t8;
    goto LAB7;

LAB9:    goto LAB2;

}

static void work_a_1209826792_3212880686_p_10(char *t0)
{
    char *t1;
    char *t2;
    char *t3;
    char *t4;
    char *t5;
    char *t6;
    char *t7;

LAB0:    xsi_set_current_line(261, ng0);

LAB3:    t1 = (t0 + 2152U);
    t2 = *((char **)t1);
    t1 = (t0 + 18376);
    t3 = (t1 + 56U);
    t4 = *((char **)t3);
    t5 = (t4 + 56U);
    t6 = *((char **)t5);
    memcpy(t6, t2, 16U);
    xsi_driver_first_trans_fast(t1);

LAB2:    t7 = (t0 + 17176);
    *((int *)t7) = 1;

LAB1:    return;
LAB4:    goto LAB2;

}

static void work_a_1209826792_3212880686_p_11(char *t0)
{
    char t9[16];
    char t11[16];
    char t16[16];
    char *t1;
    char *t3;
    char *t4;
    unsigned int t5;
    unsigned int t6;
    unsigned int t7;
    char *t8;
    char *t10;
    char *t12;
    char *t13;
    int t14;
    unsigned int t15;
    char *t17;
    int t18;
    unsigned char t19;
    char *t20;
    char *t21;
    char *t22;
    char *t23;
    char *t24;

LAB0:    xsi_set_current_line(263, ng0);

LAB3:    t1 = (t0 + 28960);
    t3 = (t0 + 4872U);
    t4 = *((char **)t3);
    t5 = (15 - 7);
    t6 = (t5 * 1U);
    t7 = (0 + t6);
    t3 = (t4 + t7);
    t10 = ((IEEE_P_1242562249) + 3000);
    t12 = (t11 + 0U);
    t13 = (t12 + 0U);
    *((int *)t13) = 0;
    t13 = (t12 + 4U);
    *((int *)t13) = 7;
    t13 = (t12 + 8U);
    *((int *)t13) = 1;
    t14 = (7 - 0);
    t15 = (t14 * 1);
    t15 = (t15 + 1);
    t13 = (t12 + 12U);
    *((unsigned int *)t13) = t15;
    t13 = (t16 + 0U);
    t17 = (t13 + 0U);
    *((int *)t17) = 7;
    t17 = (t13 + 4U);
    *((int *)t17) = 0;
    t17 = (t13 + 8U);
    *((int *)t17) = -1;
    t18 = (0 - 7);
    t15 = (t18 * -1);
    t15 = (t15 + 1);
    t17 = (t13 + 12U);
    *((unsigned int *)t17) = t15;
    t8 = xsi_base_array_concat(t8, t9, t10, (char)97, t1, t11, (char)97, t3, t16, (char)101);
    t15 = (8U + 8U);
    t19 = (16U != t15);
    if (t19 == 1)
        goto LAB5;

LAB6:    t17 = (t0 + 18440);
    t20 = (t17 + 56U);
    t21 = *((char **)t20);
    t22 = (t21 + 56U);
    t23 = *((char **)t22);
    memcpy(t23, t8, 16U);
    xsi_driver_first_trans_fast(t17);

LAB2:    t24 = (t0 + 17192);
    *((int *)t24) = 1;

LAB1:    return;
LAB4:    goto LAB2;

LAB5:    xsi_size_not_matching(16U, t15, 0);
    goto LAB6;

}

static void work_a_1209826792_3212880686_p_12(char *t0)
{
    char t6[16];
    char t12[16];
    char *t1;
    char *t2;
    unsigned int t3;
    unsigned int t4;
    unsigned int t5;
    char *t7;
    char *t8;
    int t9;
    unsigned int t10;
    char *t13;
    char *t14;
    int t15;
    unsigned char t16;
    char *t17;
    char *t18;
    char *t19;
    char *t20;
    char *t21;
    char *t22;
    char *t23;
    char *t24;
    char *t25;
    char *t26;

LAB0:    xsi_set_current_line(265, ng0);
    t1 = (t0 + 4872U);
    t2 = *((char **)t1);
    t3 = (15 - 15);
    t4 = (t3 * 1U);
    t5 = (0 + t4);
    t1 = (t2 + t5);
    t7 = (t6 + 0U);
    t8 = (t7 + 0U);
    *((int *)t8) = 15;
    t8 = (t7 + 4U);
    *((int *)t8) = 8;
    t8 = (t7 + 8U);
    *((int *)t8) = -1;
    t9 = (8 - 15);
    t10 = (t9 * -1);
    t10 = (t10 + 1);
    t8 = (t7 + 12U);
    *((unsigned int *)t8) = t10;
    t8 = (t0 + 28968);
    t13 = (t12 + 0U);
    t14 = (t13 + 0U);
    *((int *)t14) = 0;
    t14 = (t13 + 4U);
    *((int *)t14) = 7;
    t14 = (t13 + 8U);
    *((int *)t14) = 1;
    t15 = (7 - 0);
    t10 = (t15 * 1);
    t10 = (t10 + 1);
    t14 = (t13 + 12U);
    *((unsigned int *)t14) = t10;
    t16 = ieee_p_1242562249_sub_2110375371_1035706684(IEEE_P_1242562249, t1, t6, t8, t12);
    if (t16 != 0)
        goto LAB3;

LAB4:
LAB5:    t21 = (t0 + 18504);
    t22 = (t21 + 56U);
    t23 = *((char **)t22);
    t24 = (t23 + 56U);
    t25 = *((char **)t24);
    *((unsigned char *)t25) = (unsigned char)3;
    xsi_driver_first_trans_fast_port(t21);

LAB2:    t26 = (t0 + 17208);
    *((int *)t26) = 1;

LAB1:    return;
LAB3:    t14 = (t0 + 18504);
    t17 = (t14 + 56U);
    t18 = *((char **)t17);
    t19 = (t18 + 56U);
    t20 = *((char **)t19);
    *((unsigned char *)t20) = (unsigned char)2;
    xsi_driver_first_trans_fast_port(t14);
    goto LAB2;

LAB6:    goto LAB2;

}

static void work_a_1209826792_3212880686_p_13(char *t0)
{
    char t8[16];
    char *t1;
    char *t2;
    char *t3;
    char *t4;
    unsigned int t5;
    unsigned int t6;
    unsigned int t7;
    char *t9;
    char *t10;
    int t11;
    unsigned int t12;
    unsigned char t13;
    char *t14;
    char *t15;
    char *t16;
    char *t17;

LAB0:    xsi_set_current_line(269, ng0);
    t1 = (t0 + 6472U);
    t2 = *((char **)t1);
    t1 = (t0 + 28636U);
    t3 = (t0 + 5032U);
    t4 = *((char **)t3);
    t5 = (15 - 7);
    t6 = (t5 * 1U);
    t7 = (0 + t6);
    t3 = (t4 + t7);
    t9 = (t8 + 0U);
    t10 = (t9 + 0U);
    *((int *)t10) = 7;
    t10 = (t9 + 4U);
    *((int *)t10) = 0;
    t10 = (t9 + 8U);
    *((int *)t10) = -1;
    t11 = (0 - 7);
    t12 = (t11 * -1);
    t12 = (t12 + 1);
    t10 = (t9 + 12U);
    *((unsigned int *)t10) = t12;
    t13 = ieee_p_1242562249_sub_2110339434_1035706684(IEEE_P_1242562249, t2, t1, t3, t8);
    if (t13 != 0)
        goto LAB2;

LAB4:    xsi_set_current_line(272, ng0);
    t1 = (t0 + 18568);
    t2 = (t1 + 56U);
    t3 = *((char **)t2);
    t4 = (t3 + 56U);
    t9 = *((char **)t4);
    *((unsigned char *)t9) = (unsigned char)2;
    xsi_driver_first_trans_fast(t1);

LAB3:    t1 = (t0 + 17224);
    *((int *)t1) = 1;

LAB1:    return;
LAB2:    xsi_set_current_line(270, ng0);
    t10 = (t0 + 18568);
    t14 = (t10 + 56U);
    t15 = *((char **)t14);
    t16 = (t15 + 56U);
    t17 = *((char **)t16);
    *((unsigned char *)t17) = (unsigned char)3;
    xsi_driver_first_trans_fast(t10);
    goto LAB3;

}

static void work_a_1209826792_3212880686_p_14(char *t0)
{
    char *t1;
    char *t2;
    unsigned char t3;
    unsigned char t4;
    char *t5;
    char *t6;
    char *t7;
    char *t8;
    unsigned char t9;
    unsigned char t10;
    unsigned char t11;
    char *t12;
    char *t13;

LAB0:    xsi_set_current_line(282, ng0);
    t1 = (t0 + 1192U);
    t2 = *((char **)t1);
    t3 = *((unsigned char *)t2);
    t4 = (t3 == (unsigned char)3);
    if (t4 != 0)
        goto LAB2;

LAB4:    t1 = (t0 + 992U);
    t4 = xsi_signal_has_event(t1);
    if (t4 == 1)
        goto LAB7;

LAB8:    t3 = (unsigned char)0;

LAB9:    if (t3 != 0)
        goto LAB5;

LAB6:
LAB3:    t1 = (t0 + 17240);
    *((int *)t1) = 1;

LAB1:    return;
LAB2:    xsi_set_current_line(283, ng0);
    t1 = (t0 + 18632);
    t5 = (t1 + 56U);
    t6 = *((char **)t5);
    t7 = (t6 + 56U);
    t8 = *((char **)t7);
    *((unsigned char *)t8) = (unsigned char)2;
    xsi_driver_first_trans_fast_port(t1);
    xsi_set_current_line(284, ng0);
    t1 = (t0 + 18696);
    t2 = (t1 + 56U);
    t5 = *((char **)t2);
    t6 = (t5 + 56U);
    t7 = *((char **)t6);
    *((unsigned char *)t7) = (unsigned char)2;
    xsi_driver_first_trans_fast_port(t1);
    xsi_set_current_line(285, ng0);
    t1 = (t0 + 18760);
    t2 = (t1 + 56U);
    t5 = *((char **)t2);
    t6 = (t5 + 56U);
    t7 = *((char **)t6);
    *((unsigned char *)t7) = (unsigned char)2;
    xsi_driver_first_trans_fast_port(t1);
    xsi_set_current_line(286, ng0);
    t1 = (t0 + 18824);
    t2 = (t1 + 56U);
    t5 = *((char **)t2);
    t6 = (t5 + 56U);
    t7 = *((char **)t6);
    *((unsigned char *)t7) = (unsigned char)2;
    xsi_driver_first_trans_fast_port(t1);
    goto LAB3;

LAB5:    xsi_set_current_line(288, ng0);
    t2 = (t0 + 6632U);
    t6 = *((char **)t2);
    t11 = *((unsigned char *)t6);
    t2 = (t0 + 18760);
    t7 = (t2 + 56U);
    t8 = *((char **)t7);
    t12 = (t8 + 56U);
    t13 = *((char **)t12);
    *((unsigned char *)t13) = t11;
    xsi_driver_first_trans_fast_port(t2);
    xsi_set_current_line(289, ng0);
    t1 = (t0 + 1672U);
    t2 = *((char **)t1);
    t3 = *((unsigned char *)t2);
    t4 = (t3 == (unsigned char)2);
    if (t4 != 0)
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
    t95 = (t94 + 56U);
    t96 = *((char **)t95);
    t97 = (t96 + 56U);
    t98 = *((char **)t97);
    memcpy(t98, t92, 7U);
    xsi_driver_first_trans_fast_port(t94);
    goto LAB2;

LAB53:    t89 = 0;

LAB56:    if (t89 < 4U)
        goto LAB57;
    else
        goto LAB55;

LAB57:    t90 = (t86 + t89);
    t91 = (t85 + t89);
    if (*((unsigned char *)t90) != *((unsigned char *)t91))
        goto LAB54;

LAB58:    t89 = (t89 + 1);
    goto LAB56;

LAB59:    t106 = (t0 + 29057);
    t108 = (t0 + 18888);
    t109 = (t108 + 56U);
    t110 = *((char **)t109);
    t111 = (t110 + 56U);
    t112 = *((char **)t111);
    memcpy(t112, t106, 7U);
    xsi_driver_first_trans_fast_port(t108);
    goto LAB2;

LAB61:    t103 = 0;

LAB64:    if (t103 < 4U)
        goto LAB65;
    else
        goto LAB63;

LAB65:    t104 = (t100 + t103);
    t105 = (t99 + t103);
    if (*((unsigned char *)t104) != *((unsigned char *)t105))
        goto LAB62;

LAB66:    t103 = (t103 + 1);
    goto LAB64;

LAB67:    t120 = (t0 + 29068);
    t122 = (t0 + 18888);
    t123 = (t122 + 56U);
    t124 = *((char **)t123);
    t125 = (t124 + 56U);
    t126 = *((char **)t125);
    memcpy(t126, t120, 7U);
    xsi_driver_first_trans_fast_port(t122);
    goto LAB2;

LAB69:    t117 = 0;

LAB72:    if (t117 < 4U)
        goto LAB73;
    else
        goto LAB71;

LAB73:    t118 = (t114 + t117);
    t119 = (t113 + t117);
    if (*((unsigned char *)t118) != *((unsigned char *)t119))
        goto LAB70;

LAB74:    t117 = (t117 + 1);
    goto LAB72;

LAB75:    t134 = (t0 + 29079);
    t136 = (t0 + 18888);
    t137 = (t136 + 56U);
    t138 = *((char **)t137);
    t139 = (t138 + 56U);
    t140 = *((char **)t139);
    memcpy(t140, t134, 7U);
    xsi_driver_first_trans_fast_port(t136);
    goto LAB2;

LAB77:    t131 = 0;

LAB80:    if (t131 < 4U)
        goto LAB81;
    else
        goto LAB79;

LAB81:    t132 = (t128 + t131);
    t133 = (t127 + t131);
    if (*((unsigned char *)t132) != *((unsigned char *)t133))
        goto LAB78;

LAB82:    t131 = (t131 + 1);
    goto LAB80;

LAB84:    goto LAB2;

}

static void work_a_1209826792_3212880686_p_16(char *t0)
{
    char t20[16];
    char *t1;
    char *t2;
    unsigned char t3;
    unsigned char t4;
    char *t5;
    char *t6;
    char *t7;
    char *t8;
    char *t9;
    char *t10;
    unsigned char t11;
    unsigned char t12;
    int t13;
    int t14;
    unsigned char t15;
    char *t16;
    char *t17;
    char *t18;
    char *t19;
    unsigned int t21;
    unsigned int t22;

LAB0:    xsi_set_current_line(319, ng0);
    t1 = (t0 + 1192U);
    t2 = *((char **)t1);
    t3 = *((unsigned char *)t2);
    t4 = (t3 == (unsigned char)3);
    if (t4 != 0)
        goto LAB2;

LAB4:    t1 = (t0 + 992U);
    t4 = xsi_signal_has_event(t1);
    if (t4 == 1)
        goto LAB7;

LAB8:    t3 = (unsigned char)0;

LAB9:    if (t3 != 0)
        goto LAB5;

LAB6:
LAB3:    t1 = (t0 + 17272);
    *((int *)t1) = 1;

LAB1:    return;
LAB2:    xsi_set_current_line(320, ng0);
    t1 = xsi_get_transient_memory(17U);
    memset(t1, 0, 17U);
    t5 = t1;
    memset(t5, (unsigned char)2, 17U);
    t6 = (t0 + 18952);
    t7 = (t6 + 56U);
    t8 = *((char **)t7);
    t9 = (t8 + 56U);
    t10 = *((char **)t9);
    memcpy(t10, t1, 17U);
    xsi_driver_first_trans_fast(t6);
    goto LAB3;

LAB5:    xsi_set_current_line(322, ng0);
    t2 = (t0 + 7912U);
    t6 = *((char **)t2);
    t2 = (t0 + 28668U);
    t7 = (t0 + 8768U);
    t8 = *((char **)t7);
    t13 = *((int *)t8);
    t14 = (t13 - 1);
    t15 = ieee_p_1242562249_sub_1781507893_1035706684(IEEE_P_1242562249, t6, t2, t14);
    if (t15 != 0)
        goto LAB10;

LAB12:    xsi_set_current_line(325, ng0);
    t1 = (t0 + 7912U);
    t2 = *((char **)t1);
    t1 = (t0 + 28668U);
    t5 = ieee_p_1242562249_sub_1919365254_1035706684(IEEE_P_1242562249, t20, t2, t1, 1);
    t6 = (t20 + 12U);
    t21 = *((unsigned int *)t6);
    t22 = (1U * t21);
    t3 = (17U != t22);
    if (t3 == 1)
        goto LAB13;

LAB14:    t7 = (t0 + 18952);
    t8 = (t7 + 56U);
    t9 = *((char **)t8);
    t10 = (t9 + 56U);
    t16 = *((char **)t10);
    memcpy(t16, t5, 17U);
    xsi_driver_first_trans_fast(t7);

LAB11:    goto LAB3;

LAB7:    t2 = (t0 + 1032U);
    t5 = *((char **)t2);
    t11 = *((unsigned char *)t5);
    t12 = (t11 == (unsigned char)3);
    t3 = t12;
    goto LAB9;

LAB10:    xsi_set_current_line(323, ng0);
    t7 = xsi_get_transient_memory(17U);
    memset(t7, 0, 17U);
    t9 = t7;
    memset(t9, (unsigned char)2, 17U);
    t10 = (t0 + 18952);
    t16 = (t10 + 56U);
    t17 = *((char **)t16);
    t18 = (t17 + 56U);
    t19 = *((char **)t18);
    memcpy(t19, t7, 17U);
    xsi_driver_first_trans_fast(t10);
    goto LAB11;

LAB13:    xsi_size_not_matching(17U, t22, 0);
    goto LAB14;

}

static void work_a_1209826792_3212880686_p_17(char *t0)
{
    char *t1;
    char *t2;
    char *t3;
    char *t4;
    int t5;
    int t6;
    unsigned char t7;
    char *t8;
    char *t9;
    char *t10;
    char *t11;
    char *t12;
    char *t13;
    char *t14;
    char *t15;
    char *t16;
    char *t17;

LAB0:    xsi_set_current_line(330, ng0);
    t1 = (t0 + 7912U);
    t2 = *((char **)t1);
    t1 = (t0 + 28668U);
    t3 = (t0 + 8768U);
    t4 = *((char **)t3);
    t5 = *((int *)t4);
    t6 = (t5 - 1);
    t7 = ieee_p_1242562249_sub_1781507893_1035706684(IEEE_P_1242562249, t2, t1, t6);
    if (t7 != 0)
        goto LAB3;

LAB4:
LAB5:    t12 = (t0 + 19016);
    t13 = (t12 + 56U);
    t14 = *((char **)t13);
    t15 = (t14 + 56U);
    t16 = *((char **)t15);
    *((unsigned char *)t16) = (unsigned char)2;
    xsi_driver_first_trans_fast(t12);

LAB2:    t17 = (t0 + 17288);
    *((int *)t17) = 1;

LAB1:    return;
LAB3:    t3 = (t0 + 19016);
    t8 = (t3 + 56U);
    t9 = *((char **)t8);
    t10 = (t9 + 56U);
    t11 = *((char **)t10);
    *((unsigned char *)t11) = (unsigned char)3;
    xsi_driver_first_trans_fast(t3);
    goto LAB2;

LAB6:    goto LAB2;

}

static void work_a_1209826792_3212880686_p_18(char *t0)
{
    char t20[16];
    char *t1;
    char *t2;
    unsigned char t3;
    unsigned char t4;
    char *t5;
    char *t6;
    char *t7;
    char *t8;
    char *t9;
    char *t10;
    unsigned char t11;
    unsigned char t12;
    unsigned char t13;
    unsigned char t14;
    unsigned char t15;
    char *t16;
    char *t17;
    char *t18;
    char *t19;
    unsigned int t21;
    unsigned int t22;

LAB0:    xsi_set_current_line(336, ng0);
    t1 = (t0 + 1192U);
    t2 = *((char **)t1);
    t3 = *((unsigned char *)t2);
    t4 = (t3 == (unsigned char)3);
    if (t4 != 0)
        goto LAB2;

LAB4:    t1 = (t0 + 992U);
    t4 = xsi_signal_has_event(t1);
    if (t4 == 1)
        goto LAB7;

LAB8:    t3 = (unsigned char)0;

LAB9:    if (t3 != 0)
        goto LAB5;

LAB6:
LAB3:    t1 = (t0 + 17304);
    *((int *)t1) = 1;

LAB1:    return;
LAB2:    xsi_set_current_line(337, ng0);
    t1 = xsi_get_transient_memory(2U);
    memset(t1, 0, 2U);
    t5 = t1;
    memset(t5, (unsigned char)2, 2U);
    t6 = (t0 + 19080);
    t7 = (t6 + 56U);
    t8 = *((char **)t7);
    t9 = (t8 + 56U);
    t10 = *((char **)t9);
    memcpy(t10, t1, 2U);
    xsi_driver_first_trans_fast(t6);
    goto LAB3;

LAB5:    xsi_set_current_line(339, ng0);
    t2 = (t0 + 8072U);
    t6 = *((char **)t2);
    t13 = *((unsigned char *)t6);
    t14 = (t13 == (unsigned char)3);
    if (t14 != 0)
        goto LAB10;

LAB12:
LAB11:    goto LAB3;

LAB7:    t2 = (t0 + 1032U);
    t5 = *((char **)t2);
    t11 = *((unsigned char *)t5);
    t12 = (t11 == (unsigned char)3);
    t3 = t12;
    goto LAB9;

LAB10:    xsi_set_current_line(340, ng0);
    t2 = (t0 + 8232U);
    t7 = *((char **)t2);
    t2 = (t0 + 28684U);
    t15 = ieee_p_1242562249_sub_1781507893_1035706684(IEEE_P_1242562249, t7, t2, 2);
    if (t15 != 0)
        goto LAB13;

LAB15:    xsi_set_current_line(343, ng0);
    t1 = (t0 + 8232U);
    t2 = *((char **)t1);
    t1 = (t0 + 28684U);
    t5 = ieee_p_1242562249_sub_1919365254_1035706684(IEEE_P_1242562249, t20, t2, t1, 1);
    t6 = (t20 + 12U);
    t21 = *((unsigned int *)t6);
    t22 = (1U * t21);
    t3 = (2U != t22);
    if (t3 == 1)
        goto LAB16;

LAB17:    t7 = (t0 + 19080);
    t8 = (t7 + 56U);
    t9 = *((char **)t8);
    t10 = (t9 + 56U);
    t16 = *((char **)t10);
    memcpy(t16, t5, 2U);
    xsi_driver_first_trans_fast(t7);

LAB14:    goto LAB11;

LAB13:    xsi_set_current_line(341, ng0);
    t8 = xsi_get_transient_memory(2U);
    memset(t8, 0, 2U);
    t9 = t8;
    memset(t9, (unsigned char)2, 2U);
    t10 = (t0 + 19080);
    t16 = (t10 + 56U);
    t17 = *((char **)t16);
    t18 = (t17 + 56U);
    t19 = *((char **)t18);
    memcpy(t19, t8, 2U);
    xsi_driver_first_trans_fast(t10);
    goto LAB14;

LAB16:    xsi_size_not_matching(2U, t22, 0);
    goto LAB17;

}

static void work_a_1209826792_3212880686_p_19(char *t0)
{
    char t20[16];
    char *t1;
    char *t2;
    unsigned char t3;
    unsigned char t4;
    char *t5;
    char *t6;
    char *t7;
    char *t8;
    char *t9;
    char *t10;
    unsigned char t11;
    unsigned char t12;
    int t13;
    int t14;
    unsigned char t15;
    char *t16;
    char *t17;
    char *t18;
    char *t19;
    unsigned int t21;
    unsigned int t22;

LAB0:    xsi_set_current_line(353, ng0);
    t1 = (t0 + 1192U);
    t2 = *((char **)t1);
    t3 = *((unsigned char *)t2);
    t4 = (t3 == (unsigned char)3);
    if (t4 != 0)
        goto LAB2;

LAB4:    t1 = (t0 + 992U);
    t4 = xsi_signal_has_event(t1);
    if (t4 == 1)
        goto LAB7;

LAB8:    t3 = (unsigned char)0;

LAB9:    if (t3 != 0)
        goto LAB5;

LAB6:
LAB3:    t1 = (t0 + 17320);
    *((int *)t1) = 1;

LAB1:    return;
LAB2:    xsi_set_current_line(354, ng0);
    t1 = xsi_get_transient_memory(26U);
    memset(t1, 0, 26U);
    t5 = t1;
    memset(t5, (unsigned char)2, 26U);
    t6 = (t0 + 19144);
    t7 = (t6 + 56U);
    t8 = *((char **)t7);
    t9 = (t8 + 56U);
    t10 = *((char **)t9);
    memcpy(t10, t1, 26U);
    xsi_driver_first_trans_fast(t6);
    goto LAB3;

LAB5:    xsi_set_current_line(356, ng0);
    t2 = (t0 + 5832U);
    t6 = *((char **)t2);
    t2 = (t0 + 28604U);
    t7 = (t0 + 8648U);
    t8 = *((char **)t7);
    t13 = *((int *)t8);
    t14 = (t13 - 1);
    t15 = ieee_p_1242562249_sub_1781507893_1035706684(IEEE_P_1242562249, t6, t2, t14);
    if (t15 != 0)
        goto LAB10;

LAB12:    xsi_set_current_line(359, ng0);
    t1 = (t0 + 5832U);
    t2 = *((char **)t1);
    t1 = (t0 + 28604U);
    t5 = ieee_p_1242562249_sub_1919365254_1035706684(IEEE_P_1242562249, t20, t2, t1, 1);
    t6 = (t20 + 12U);
    t21 = *((unsigned int *)t6);
    t22 = (1U * t21);
    t3 = (26U != t22);
    if (t3 == 1)
        goto LAB13;

LAB14:    t7 = (t0 + 19144);
    t8 = (t7 + 56U);
    t9 = *((char **)t8);
    t10 = (t9 + 56U);
    t16 = *((char **)t10);
    memcpy(t16, t5, 26U);
    xsi_driver_first_trans_fast(t7);

LAB11:    goto LAB3;

LAB7:    t2 = (t0 + 1032U);
    t5 = *((char **)t2);
    t11 = *((unsigned char *)t5);
    t12 = (t11 == (unsigned char)3);
    t3 = t12;
    goto LAB9;

LAB10:    xsi_set_current_line(357, ng0);
    t7 = xsi_get_transient_memory(26U);
    memset(t7, 0, 26U);
    t9 = t7;
    memset(t9, (unsigned char)2, 26U);
    t10 = (t0 + 19144);
    t16 = (t10 + 56U);
    t17 = *((char **)t16);
    t18 = (t17 + 56U);
    t19 = *((char **)t18);
    memcpy(t19, t7, 26U);
    xsi_driver_first_trans_fast(t10);
    goto LAB11;

LAB13:    xsi_size_not_matching(26U, t22, 0);
    goto LAB14;

}

static void work_a_1209826792_3212880686_p_20(char *t0)
{
    char *t1;
    char *t2;
    char *t3;
    char *t4;
    int t5;
    int t6;
    unsigned char t7;
    char *t8;
    char *t9;
    char *t10;
    char *t11;
    char *t12;
    char *t13;
    char *t14;
    char *t15;
    char *t16;
    char *t17;

LAB0:    xsi_set_current_line(364, ng0);
    t1 = (t0 + 5832U);
    t2 = *((char **)t1);
    t1 = (t0 + 28604U);
    t3 = (t0 + 8648U);
    t4 = *((char **)t3);
    t5 = *((int *)t4);
    t6 = (t5 - 1);
    t7 = ieee_p_1242562249_sub_1781507893_1035706684(IEEE_P_1242562249, t2, t1, t6);
    if (t7 != 0)
        goto LAB3;

LAB4:
LAB5:    t12 = (t0 + 19208);
    t13 = (t12 + 56U);
    t14 = *((char **)t13);
    t15 = (t14 + 56U);
    t16 = *((char **)t15);
    *((unsigned char *)t16) = (unsigned char)2;
    xsi_driver_first_trans_fast(t12);

LAB2:    t17 = (t0 + 17336);
    *((int *)t17) = 1;

LAB1:    return;
LAB3:    t3 = (t0 + 19208);
    t8 = (t3 + 56U);
    t9 = *((char **)t8);
    t10 = (t9 + 56U);
    t11 = *((char **)t10);
    *((unsigned char *)t11) = (unsigned char)3;
    xsi_driver_first_trans_fast(t3);
    goto LAB2;

LAB6:    goto LAB2;

}

static void work_a_1209826792_3212880686_p_21(char *t0)
{
    char *t1;
    char *t2;
    unsigned char t3;
    unsigned char t4;
    char *t5;
    char *t6;
    char *t7;
    char *t8;
    unsigned char t9;
    unsigned char t10;
    unsigned char t11;
    unsigned char t12;
    unsigned char t13;
    unsigned char t14;
    unsigned char t15;
    char *t16;
    char *t17;
    char *t18;

LAB0:    xsi_set_current_line(373, ng0);
    t1 = (t0 + 1192U);
    t2 = *((char **)t1);
    t3 = *((unsigned char *)t2);
    t4 = (t3 == (unsigned char)3);
    if (t4 != 0)
        goto LAB2;

LAB4:    t1 = (t0 + 992U);
    t4 = xsi_signal_has_event(t1);
    if (t4 == 1)
        goto LAB7;

LAB8:    t3 = (unsigned char)0;

LAB9:    if (t3 != 0)
        goto LAB5;

LAB6:
LAB3:    t1 = (t0 + 17352);
    *((int *)t1) = 1;

LAB1:    return;
LAB2:    xsi_set_current_line(374, ng0);
    t1 = (t0 + 19272);
    t5 = (t1 + 56U);
    t6 = *((char **)t5);
    t7 = (t6 + 56U);
    t8 = *((char **)t7);
    *((unsigned char *)t8) = (unsigned char)2;
    xsi_driver_first_trans_fast(t1);
    goto LAB3;

LAB5:    xsi_set_current_line(376, ng0);
    t2 = (t0 + 6152U);
    t6 = *((char **)t2);
    t12 = *((unsigned char *)t6);
    t13 = (t12 == (unsigned char)3);
    if (t13 == 1)
        goto LAB13;

LAB14:    t11 = (unsigned char)0;

LAB15:    if (t11 != 0)
        goto LAB10;

LAB12:    t1 = (t0 + 6152U);
    t2 = *((char **)t1);
    t4 = *((unsigned char *)t2);
    t9 = (t4 == (unsigned char)2);
    if (t9 == 1)
        goto LAB18;

LAB19:    t3 = (unsigned char)0;

LAB20:    if (t3 != 0)
        goto LAB16;

LAB17:
LAB11:    goto LAB3;

LAB7:    t2 = (t0 + 1032U);
    t5 = *((char **)t2);
    t9 = *((unsigned char *)t5);
    t10 = (t9 == (unsigned char)3);
    t3 = t10;
    goto LAB9;

LAB10:    xsi_set_current_line(377, ng0);
    t2 = (t0 + 19272);
    t8 = (t2 + 56U);
    t16 = *((char **)t8);
    t17 = (t16 + 56U);
    t18 = *((char **)t17);
    *((unsigned char *)t18) = (unsigned char)2;
    xsi_driver_first_trans_fast(t2);
    goto LAB11;

LAB13:    t2 = (t0 + 5992U);
    t7 = *((char **)t2);
    t14 = *((unsigned char *)t7);
    t15 = (t14 == (unsigned char)3);
    t11 = t15;
    goto LAB15;

LAB16:    xsi_set_current_line(379, ng0);
    t1 = (t0 + 19272);
    t6 = (t1 + 56U);
    t7 = *((char **)t6);
    t8 = (t7 + 56U);
    t16 = *((char **)t8);
    *((unsigned char *)t16) = (unsigned char)3;
    xsi_driver_first_trans_fast(t1);
    goto LAB11;

LAB18:    t1 = (t0 + 5992U);
    t5 = *((char **)t1);
    t10 = *((unsigned char *)t5);
    t11 = (t10 == (unsigned char)3);
    t3 = t11;
    goto LAB20;

}

static void work_a_1209826792_3212880686_p_22(char *t0)
{
    char t5[16];
    char t7[16];
    char *t1;
    char *t3;
    char *t4;
    char *t6;
    char *t8;
    char *t9;
    int t10;
    unsigned int t11;
    unsigned char t12;
    char *t13;
    char *t14;
    char *t15;
    char *t16;
    char *t17;
    char *t18;

LAB0:    xsi_set_current_line(386, ng0);

LAB3:    t1 = (t0 + 29093);
    t3 = (t0 + 4712U);
    t4 = *((char **)t3);
    t6 = ((IEEE_P_2592010699) + 4024);
    t8 = (t7 + 0U);
    t9 = (t8 + 0U);
    *((int *)t9) = 0;
    t9 = (t8 + 4U);
    *((int *)t9) = 7;
    t9 = (t8 + 8U);
    *((int *)t9) = 1;
    t10 = (7 - 0);
    t11 = (t10 * 1);
    t11 = (t11 + 1);
    t9 = (t8 + 12U);
    *((unsigned int *)t9) = t11;
    t9 = (t0 + 28508U);
    t3 = xsi_base_array_concat(t3, t5, t6, (char)97, t1, t7, (char)97, t4, t9, (char)101);
    t11 = (8U + 8U);
    t12 = (16U != t11);
    if (t12 == 1)
        goto LAB5;

LAB6:    t13 = (t0 + 19336);
    t14 = (t13 + 56U);
    t15 = *((char **)t14);
    t16 = (t15 + 56U);
    t17 = *((char **)t16);
    memcpy(t17, t3, 16U);
    xsi_driver_first_trans_fast_port(t13);

LAB2:    t18 = (t0 + 17368);
    *((int *)t18) = 1;

LAB1:    return;
LAB4:    goto LAB2;

LAB5:    xsi_size_not_matching(16U, t11, 0);
    goto LAB6;

}

static void work_a_1209826792_3212880686_p_23(char *t0)
{
    char t20[16];
    char *t1;
    char *t2;
    unsigned char t3;
    unsigned char t4;
    char *t5;
    char *t6;
    char *t7;
    char *t8;
    char *t9;
    char *t10;
    unsigned char t11;
    unsigned char t12;
    unsigned char t13;
    unsigned char t14;
    unsigned char t15;
    char *t16;
    char *t17;
    char *t18;
    char *t19;
    unsigned int t21;
    unsigned int t22;

LAB0:    xsi_set_current_line(390, ng0);
    t1 = (t0 + 1192U);
    t2 = *((char **)t1);
    t3 = *((unsigned char *)t2);
    t4 = (t3 == (unsigned char)3);
    if (t4 != 0)
        goto LAB2;

LAB4:    t1 = (t0 + 992U);
    t4 = xsi_signal_has_event(t1);
    if (t4 == 1)
        goto LAB7;

LAB8:    t3 = (unsigned char)0;

LAB9:    if (t3 != 0)
        goto LAB5;

LAB6:
LAB3:    t1 = (t0 + 17384);
    *((int *)t1) = 1;

LAB1:    return;
LAB2:    xsi_set_current_line(391, ng0);
    t1 = xsi_get_transient_memory(4U);
    memset(t1, 0, 4U);
    t5 = t1;
    memset(t5, (unsigned char)2, 4U);
    t6 = (t0 + 19400);
    t7 = (t6 + 56U);
    t8 = *((char **)t7);
    t9 = (t8 + 56U);
    t10 = *((char **)t9);
    memcpy(t10, t1, 4U);
    xsi_driver_first_trans_fast(t6);
    xsi_set_current_line(392, ng0);
    t1 = xsi_get_transient_memory(16U);
    memset(t1, 0, 16U);
    t2 = t1;
    memset(t2, (unsigned char)2, 16U);
    t5 = (t0 + 19464);
    t6 = (t5 + 56U);
    t7 = *((char **)t6);
    t8 = (t7 + 56U);
    t9 = *((char **)t8);
    memcpy(t9, t1, 16U);
    xsi_driver_first_trans_fast(t5);
    goto LAB3;

LAB5:    xsi_set_current_line(396, ng0);
    t2 = (t0 + 8072U);
    t6 = *((char **)t2);
    t13 = *((unsigned char *)t6);
    t14 = (t13 == (unsigned char)3);
    if (t14 != 0)
        goto LAB10;

LAB12:
LAB11:    goto LAB3;

LAB7:    t2 = (t0 + 1032U);
    t5 = *((char **)t2);
    t11 = *((unsigned char *)t5);
    t12 = (t11 == (unsigned char)3);
    t3 = t12;
    goto LAB9;

LAB10:    xsi_set_current_line(397, ng0);
    t2 = (t0 + 6312U);
    t7 = *((char **)t2);
    t2 = (t0 + 28620U);
    t15 = ieee_p_1242562249_sub_1781507893_1035706684(IEEE_P_1242562249, t7, t2, 15);
    if (t15 != 0)
        goto LAB13;

LAB15:    xsi_set_current_line(407, ng0);
    t1 = (t0 + 6312U);
    t2 = *((char **)t1);
    t1 = (t0 + 28620U);
    t5 = ieee_p_1242562249_sub_1919365254_1035706684(IEEE_P_1242562249, t20, t2, t1, 1);
    t6 = (t20 + 12U);
    t21 = *((unsigned int *)t6);
    t22 = (1U * t21);
    t3 = (4U != t22);
    if (t3 == 1)
        goto LAB16;

LAB17:    t7 = (t0 + 19400);
    t8 = (t7 + 56U);
    t9 = *((char **)t8);
    t10 = (t9 + 56U);
    t16 = *((char **)t10);
    memcpy(t16, t5, 4U);
    xsi_driver_first_trans_fast(t7);

LAB14:    goto LAB11;

LAB13:    xsi_set_current_line(398, ng0);
    t8 = xsi_get_transient_memory(4U);
    memset(t8, 0, 4U);
    t9 = t8;
    memset(t9, (unsigned char)2, 4U);
    t10 = (t0 + 19400);
    t16 = (t10 + 56U);
    t17 = *((char **)t16);
    t18 = (t17 + 56U);
    t19 = *((char **)t18);
    memcpy(t19, t8, 4U);
    xsi_driver_first_trans_fast(t10);
    xsi_set_current_line(404, ng0);
    t1 = (t0 + 1992U);
    t2 = *((char **)t1);
    t1 = (t0 + 19464);
    t5 = (t1 + 56U);
    t6 = *((char **)t5);
    t7 = (t6 + 56U);
    t8 = *((char **)t7);
    memcpy(t8, t2, 16U);
    xsi_driver_first_trans_fast(t1);
    goto LAB14;

LAB16:    xsi_size_not_matching(4U, t22, 0);
    goto LAB17;

}

static void work_a_1209826792_3212880686_p_24(char *t0)
{
    char t7[16];
    char t9[16];
    char *t1;
    char *t2;
    unsigned int t3;
    unsigned int t4;
    unsigned int t5;
    char *t6;
    char *t8;
    char *t10;
    char *t11;
    int t12;
    unsigned int t13;
    unsigned char t14;
    char *t15;
    char *t16;
    char *t17;
    char *t18;
    char *t19;

LAB0:    xsi_set_current_line(413, ng0);

LAB3:    t1 = (t0 + 5192U);
    t2 = *((char **)t1);
    t3 = (15 - 14);
    t4 = (t3 * 1U);
    t5 = (0 + t4);
    t1 = (t2 + t5);
    t8 = ((IEEE_P_2592010699) + 4024);
    t10 = (t9 + 0U);
    t11 = (t10 + 0U);
    *((int *)t11) = 14;
    t11 = (t10 + 4U);
    *((int *)t11) = 0;
    t11 = (t10 + 8U);
    *((int *)t11) = -1;
    t12 = (0 - 14);
    t13 = (t12 * -1);
    t13 = (t13 + 1);
    t11 = (t10 + 12U);
    *((unsigned int *)t11) = t13;
    t6 = xsi_base_array_concat(t6, t7, t8, (char)97, t1, t9, (char)99, (unsigned char)2, (char)101);
    t13 = (15U + 1U);
    t14 = (16U != t13);
    if (t14 == 1)
        goto LAB5;

LAB6:    t11 = (t0 + 19528);
    t15 = (t11 + 56U);
    t16 = *((char **)t15);
    t17 = (t16 + 56U);
    t18 = *((char **)t17);
    memcpy(t18, t6, 16U);
    xsi_driver_first_trans_fast_port(t11);

LAB2:    t19 = (t0 + 17400);
    *((int *)t19) = 1;

LAB1:    return;
LAB4:    goto LAB2;

LAB5:    xsi_size_not_matching(16U, t13, 0);
    goto LAB6;

}

static void work_a_1209826792_3212880686_p_25(char *t0)
{
    unsigned char t1;
    char *t2;
    char *t3;
    unsigned char t4;
    char *t5;
    char *t6;
    unsigned char t7;
    unsigned char t8;
    char *t9;
    char *t10;
    char *t11;
    char *t12;
    char *t13;
    char *t14;
    char *t15;
    char *t16;
    char *t17;
    char *t18;

LAB0:    xsi_set_current_line(415, ng0);
    t2 = (t0 + 6312U);
    t3 = *((char **)t2);
    t2 = (t0 + 28620U);
    t4 = ieee_p_1242562249_sub_1781507893_1035706684(IEEE_P_1242562249, t3, t2, 15);
    if (t4 == 1)
        goto LAB5;

LAB6:    t1 = (unsigned char)0;

LAB7:    if (t1 != 0)
        goto LAB3;

LAB4:
LAB8:    t13 = (t0 + 19592);
    t14 = (t13 + 56U);
    t15 = *((char **)t14);
    t16 = (t15 + 56U);
    t17 = *((char **)t16);
    *((unsigned char *)t17) = (unsigned char)2;
    xsi_driver_first_trans_fast_port(t13);

LAB2:    t18 = (t0 + 17416);
    *((int *)t18) = 1;

LAB1:    return;
LAB3:    t5 = (t0 + 19592);
    t9 = (t5 + 56U);
    t10 = *((char **)t9);
    t11 = (t10 + 56U);
    t12 = *((char **)t11);
    *((unsigned char *)t12) = (unsigned char)3;
    xsi_driver_first_trans_fast_port(t5);
    goto LAB2;

LAB5:    t5 = (t0 + 8072U);
    t6 = *((char **)t5);
    t7 = *((unsigned char *)t6);
    t8 = (t7 == (unsigned char)3);
    t1 = t8;
    goto LAB7;

LAB9:    goto LAB2;

}

static void work_a_1209826792_3212880686_p_26(char *t0)
{
    char *t1;
    char *t2;
    unsigned char t3;
    unsigned char t4;
    char *t5;
    char *t6;
    char *t7;
    char *t8;
    char *t9;
    char *t10;
    char *t11;
    unsigned int t12;
    unsigned int t13;
    unsigned int t14;
    char *t15;
    char *t16;
    char *t17;
    char *t18;
    char *t19;
    char *t20;

LAB0:    xsi_set_current_line(424, ng0);
    t1 = (t0 + 2472U);
    t2 = *((char **)t1);
    t3 = *((unsigned char *)t2);
    t4 = (t3 == (unsigned char)2);
    if (t4 != 0)
        goto LAB3;

LAB4:
LAB5:    t10 = (t0 + 1992U);
    t11 = *((char **)t10);
    t12 = (15 - 7);
    t13 = (t12 * 1U);
    t14 = (0 + t13);
    t10 = (t11 + t14);
    t15 = (t0 + 19656);
    t16 = (t15 + 56U);
    t17 = *((char **)t16);
    t18 = (t17 + 56U);
    t19 = *((char **)t18);
    memcpy(t19, t10, 8U);
    xsi_driver_first_trans_fast_port(t15);

LAB2:    t20 = (t0 + 17432);
    *((int *)t20) = 1;

LAB1:    return;
LAB3:    t1 = (t0 + 4712U);
    t5 = *((char **)t1);
    t1 = (t0 + 19656);
    t6 = (t1 + 56U);
    t7 = *((char **)t6);
    t8 = (t7 + 56U);
    t9 = *((char **)t8);
    memcpy(t9, t5, 8U);
    xsi_driver_first_trans_fast_port(t1);
    goto LAB2;

LAB6:    goto LAB2;

}

static void work_a_1209826792_3212880686_p_27(char *t0)
{
    char t5[16];
    char *t1;
    char *t2;
    char *t3;
    char *t4;
    char *t6;
    char *t7;
    int t8;
    unsigned int t9;
    unsigned char t10;
    char *t11;
    unsigned char t13;
    char *t14;
    char *t15;
    char *t16;
    char *t17;
    unsigned char t18;
    unsigned char t19;
    char *t20;
    unsigned int t21;
    unsigned int t22;
    unsigned int t23;
    char *t24;
    char *t25;
    char *t26;
    char *t27;
    char *t28;

LAB0:    xsi_set_current_line(429, ng0);
    t1 = (t0 + 8232U);
    t2 = *((char **)t1);
    t1 = (t0 + 28684U);
    t3 = (t0 + 29101);
    t6 = (t5 + 0U);
    t7 = (t6 + 0U);
    *((int *)t7) = 0;
    t7 = (t6 + 4U);
    *((int *)t7) = 1;
    t7 = (t6 + 8U);
    *((int *)t7) = 1;
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
    t3 = *((unsigned char *)t2);
    t4 = (t3 == (unsigned char)3);
    if (t4 != 0)
        goto LAB2;

LAB4:    xsi_set_current_line(471, ng0);
    t1 = (t0 + 8232U);
    t2 = *((char **)t1);
    t1 = (t0 + 29136);
    t11 = xsi_mem_cmp(t1, t2, 2U);
    if (t11 == 1)
        goto LAB6;

LAB9:    t6 = (t0 + 29138);
    t12 = xsi_mem_cmp(t6, t2, 2U);
    if (t12 == 1)
        goto LAB7;

LAB10:
LAB8:    xsi_set_current_line(477, ng0);
    t1 = (t0 + 29148);
    t5 = (t0 + 19784);
    t6 = (t5 + 56U);
    t7 = *((char **)t6);
    t8 = (t7 + 56U);
    t9 = *((char **)t8);
    memcpy(t9, t1, 4U);
    xsi_driver_first_trans_fast_port(t5);

LAB5:
LAB3:    t1 = (t0 + 17464);
    *((int *)t1) = 1;

LAB1:    return;
LAB2:    xsi_set_current_line(469, ng0);
    t1 = (t0 + 29132);
    t6 = (t0 + 19784);
    t7 = (t6 + 56U);
    t8 = *((char **)t7);
    t9 = (t8 + 56U);
    t10 = *((char **)t9);
    memcpy(t10, t1, 4U);
    xsi_driver_first_trans_fast_port(t6);
    goto LAB3;

LAB6:    xsi_set_current_line(473, ng0);
    t8 = (t0 + 29140);
    t10 = (t0 + 19784);
    t13 = (t10 + 56U);
    t14 = *((char **)t13);
    t15 = (t14 + 56U);
    t16 = *((char **)t15);
    memcpy(t16, t8, 4U);
    xsi_driver_first_trans_fast_port(t10);
    goto LAB5;

LAB7:    xsi_set_current_line(475, ng0);
    t1 = (t0 + 29144);
    t5 = (t0 + 19784);
    t6 = (t5 + 56U);
    t7 = *((char **)t6);
    t8 = (t7 + 56U);
    t9 = *((char **)t8);
    memcpy(t9, t1, 4U);
    xsi_driver_first_trans_fast_port(t5);
    goto LAB5;

LAB11:;
}


extern void work_a_1209826792_3212880686_init()
{
	static char *pe[] = {(void *)work_a_1209826792_3212880686_p_0,(void *)work_a_1209826792_3212880686_p_1,(void *)work_a_1209826792_3212880686_p_2,(void *)work_a_1209826792_3212880686_p_3,(void *)work_a_1209826792_3212880686_p_4,(void *)work_a_1209826792_3212880686_p_5,(void *)work_a_1209826792_3212880686_p_6,(void *)work_a_1209826792_3212880686_p_7,(void *)work_a_1209826792_3212880686_p_8,(void *)work_a_1209826792_3212880686_p_9,(void *)work_a_1209826792_3212880686_p_10,(void *)work_a_1209826792_3212880686_p_11,(void *)work_a_1209826792_3212880686_p_12,(void *)work_a_1209826792_3212880686_p_13,(void *)work_a_1209826792_3212880686_p_14,(void *)work_a_1209826792_3212880686_p_15,(void *)work_a_1209826792_3212880686_p_16,(void *)work_a_1209826792_3212880686_p_17,(void *)work_a_1209826792_3212880686_p_18,(void *)work_a_1209826792_3212880686_p_19,(void *)work_a_1209826792_3212880686_p_20,(void *)work_a_1209826792_3212880686_p_21,(void *)work_a_1209826792_3212880686_p_22,(void *)work_a_1209826792_3212880686_p_23,(void *)work_a_1209826792_3212880686_p_24,(void *)work_a_1209826792_3212880686_p_25,(void *)work_a_1209826792_3212880686_p_26,(void *)work_a_1209826792_3212880686_p_27,(void *)work_a_1209826792_3212880686_p_28};
	xsi_register_didat("work_a_1209826792_3212880686", "isim/tb_juntar_isim_beh.exe.sim/work/a_1209826792_3212880686.didat");
	xsi_register_executes(pe);
}
