clararodellar/TFG/Electronica_control/Codigos/FPGA/PWM_prueba_lazocerrado_v3/isim/tb_juntar_isim_beh.exe.sim/work/a_2483966931_2372691052.c

/**********************************************************************/
/*   ____  ____                                                       */
/*  /   /\/   /                                                       */
/* /___/  \  /                                                        */
/* \   \   \/                                                       */
/*  \   \        Copyright (c) 2003-2009 Xilinx, Inc.                */
/*  /   /          All Right Reserved.                                 */
/* /---/   /\                                                         */
/* \   \  /  \                                                      */
/*  \___\/\___\                                                    */
/***********************************************************************/

/* This file is designed for use with ISim build 0x7708f090 */

#define XSI_HIDE_SYMBOL_SPEC true
#include "xsi.h"
#include <memory.h>
#ifdef __GNUC__
#include <stdlib.h>
#else
#include <malloc.h>
#define alloca _alloca
#endif
static const char *ng0 = "D:/URJC/4.CUARTO/TFG/TRABAJO/FPGA/PWM_prueba_lazocerrado_v3/tb_juntar.vhd";



static void work_a_2483966931_2372691052_p_0(char *t0)
{
    char *t1;
    char *t2;
    char *t3;
    char *t4;
    char *t5;
    char *t6;
    int64 t7;
    int64 t8;

LAB0:    t1 = (t0 + 4712U);
    t2 = *((char **)t1);
    if (t2 == 0)
        goto LAB2;

LAB3:    goto *t2;

LAB2:    xsi_set_current_line(112, ng0);
    t2 = (t0 + 5592);
    t3 = (t2 + 56U);
    t4 = *((char **)t3);
    t5 = (t4 + 56U);
    t6 = *((char **)t5);
    *((unsigned char *)t6) = (unsigned char)2;
    xsi_driver_first_trans_fast(t2);
    xsi_set_current_line(113, ng0);
    t2 = (t0 + 3728U);
    t3 = *((char **)t2);
    t7 = *((int64 *)t3);
    t8 = (t7 / 2);
    t2 = (t0 + 4520);
    xsi_process_wait(t2, t8);

LAB6:    *((char **)t1) = &&LAB7;

LAB1:    return;
LAB4:    xsi_set_current_line(114, ng0);
    t2 = (t0 + 5592);
    t3 = (t2 + 56U);
    t4 = *((char **)t3);
    t5 = (t4 + 56U);
    t6 = *((char **)t5);
    *((unsigned char *)t6) = (unsigned char)3;
    xsi_driver_first_trans_fast(t2);
    xsi_set_current_line(115, ng0);
    t2 = (t0 + 3728U);
    t3 = *((char **)t2);
    t7 = *((int64 *)t3);
    t8 = (t7 / 2);
    t2 = (t0 + 4520);
    xsi_process_wait(t2, t8);

LAB10:    *((char **)t1) = &&LAB11;
    goto LAB1;

LAB5:    goto LAB4;

LAB7:    goto LAB5;

LAB8:    goto LAB2;

LAB9:    goto LAB8;

LAB11:    goto LAB9;

}

static void work_a_2483966931_2372691052_p_1(char *t0)
{
    char *t1;
    char *t2;
    char *t3;
    int t4;
    int t5;
    char *t6;
    char *t7;
    char *t8;
    char *t9;
    char *t10;
    int64 t11;
    int t12;

LAB0:    t1 = (t0 + 4960U);
    t2 = *((char **)t1);
    if (t2 == 0)
        goto LAB2;

LAB3:    goto *t2;

LAB2:    xsi_set_current_line(121, ng0);
    t2 = (t0 + 9628);
    *((int *)t2) = 0;
    t3 = (t0 + 9632);
    *((int *)t3) = 120;
    t4 = 0;
    t5 = 120;

LAB4:    if (t4 <= t5)
        goto LAB5;

LAB7:    xsi_set_current_line(135, ng0);

LAB25:    if ((unsigned char)1 != 0)
        goto LAB26;

LAB28:    goto LAB2;

LAB5:    xsi_set_current_line(122, ng0);
    t6 = (t0 + 5656);
    t7 = (t6 + 56U);
    t8 = *((char **)t7);
    t9 = (t8 + 56U);
    t10 = *((char **)t9);
    *((unsigned char *)t10) = (unsigned char)2;
    xsi_driver_first_trans_fast(t6);
    xsi_set_current_line(123, ng0);
    t2 = (t0 + 5720);
    t3 = (t2 + 56U);
    t6 = *((char **)t3);
    t7 = (t6 + 56U);
    t8 = *((char **)t7);
    *((unsigned char *)t8) = (unsigned char)2;
    xsi_driver_first_trans_fast(t2);
    xsi_set_current_line(124, ng0);
    t11 = (75 * 1000000LL);
    t2 = (t0 + 4768);
    xsi_process_wait(t2, t11);

LAB10:    *((char **)t1) = &&LAB11;

LAB1:    return;
LAB6:    t2 = (t0 + 9628);
    t4 = *((int *)t2);
    t3 = (t0 + 9632);
    t5 = *((int *)t3);
    if (t4 == t5)
        goto LAB7;

LAB24:    t12 = (t4 + 1);
    t4 = t12;
    t6 = (t0 + 9628);
    *((int *)t6) = t4;
    goto LAB4;

LAB8:    xsi_set_current_line(125, ng0);
    t2 = (t0 + 5656);
    t3 = (t2 + 56U);
    t6 = *((char **)t3);
    t7 = (t6 + 56U);
    t8 = *((char **)t7);
    *((unsigned char *)t8) = (unsigned char)3;
    xsi_driver_first_trans_fast(t2);
    xsi_set_current_line(126, ng0);
    t2 = (t0 + 5720);
    t3 = (t2 + 56U);
    t6 = *((char **)t3);
    t7 = (t6 + 56U);
    t8 = *((char **)t7);
    *((unsigned char *)t8) = (unsigned char)2;
    xsi_driver_first_trans_fast(t2);
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
    t6 = *((char **)t5);
    t9 = (t6 + 56U);
    t10 = *((char **)t9);
    memcpy(t10, t2, 3U);
    xsi_driver_first_trans_fast(t4);
    xsi_set_current_line(168, ng0);

LAB22:    *((char **)t1) = &&LAB23;
    goto LAB1;

LAB17:    goto LAB16;

LAB19:    goto LAB17;

LAB20:    goto LAB2;

LAB21:    goto LAB20;

LAB23:    goto LAB21;

}


extern void work_a_2483966931_2372691052_init()
{
	static char *pe[] = {(void *)work_a_2483966931_2372691052_p_0,(void *)work_a_2483966931_2372691052_p_1,(void *)work_a_2483966931_2372691052_p_2};
	xsi_register_didat("work_a_2483966931_2372691052", "isim/tb_juntar_isim_beh.exe.sim/work/a_2483966931_2372691052.didat");
	xsi_register_executes(pe);
}
