clararodellar/TFG/Electronica_control/Codigos/FPGA/PWM_prueba_lazocerrado_v3/isim/tb_juntar_isim_beh.exe.sim/work/tb_juntar_isim_beh.exe_main.c

/**********************************************************************/
/*   ____  ____                                                       */
/*  /   /\/   /                                                       */
/* /___/  \  /                                                        */
/* \   \   \/                                                       */
/*  \   \        Copyright (c) 2003-2009 Xilinx, Inc.                */
/*  /   /          All Right Reserved.                                 */
/* /---/   /\                                                         */
/* \   \  /  \                                                      */
/*  \___\/\___\                                                    */
/***********************************************************************/

#include "xsi.h"

struct XSI_INFO xsi_info;

char *IEEE_P_3499444699;
char *STD_STANDARD;
char *IEEE_P_3620187407;
char *IEEE_P_1242562249;
char *IEEE_P_2592010699;


int main(int argc, char **argv)
{
    xsi_init_design(argc, argv);
    xsi_register_info(&xsi_info);

    xsi_register_min_prec_unit(-12);
    ieee_p_2592010699_init();
    ieee_p_1242562249_init();
    ieee_p_3499444699_init();
    ieee_p_3620187407_init();
    work_a_1209826792_3212880686_init();
    work_a_2536911233_3212880686_init();
    work_a_1543659282_3212880686_init();
    work_a_2335869439_3212880686_init();
    work_a_0055186542_3212880686_init();
    work_a_2943806228_3212880686_init();
    work_a_2483966931_2372691052_init();


    xsi_register_tops("work_a_2483966931_2372691052");

    IEEE_P_3499444699 = xsi_get_engine_memory("ieee_p_3499444699");
    STD_STANDARD = xsi_get_engine_memory("std_standard");
    IEEE_P_3620187407 = xsi_get_engine_memory("ieee_p_3620187407");
    IEEE_P_1242562249 = xsi_get_engine_memory("ieee_p_1242562249");
    IEEE_P_2592010699 = xsi_get_engine_memory("ieee_p_2592010699");
    xsi_register_ieee_std_logic_1164(IEEE_P_2592010699);

    return xsi_run_simulation(argc, argv);

}
