clararodellar/TFG/Electronica_control/Codigos/FPGA/PWM_prueba_lazocerrado_v3/isim/tb_juntar_isim_beh.exe.sim/work/a_2536911233_3212880686.c

/**********************************************************************/
/*   ____  ____                                                       */
/*  /   /\/   /                                                       */
/* /___/  \  /                                                        */
/* \   \   \/                                                       */
/*  \   \        Copyright (c) 2003-2009 Xilinx, Inc.                */
/*  /   /          All Right Reserved.                                 */
/* /---/   /\                                                         */
/* \   \  /  \                                                      */
/*  \___\/\___\                                                    */
/***********************************************************************/

/* This file is designed for use with ISim build 0x7708f090 */

#define XSI_HIDE_SYMBOL_SPEC true
#include "xsi.h"
#include <memory.h>
#ifdef __GNUC__
#include <stdlib.h>
#else
#include <malloc.h>
#define alloca _alloca
#endif
static const char *ng0 = "D:/URJC/4.CUARTO/TFG/TRABAJO/FPGA/PWM_prueba_lazocerrado_v3/debouncer_top.vhd";
extern char *IEEE_P_2592010699;
extern char *IEEE_P_3620187407;

unsigned char ieee_p_2592010699_sub_2507238156_503743352(char *, unsigned char , unsigned char );
char *ieee_p_3620187407_sub_436279890_3965413181(char *, char *, char *, char *, int );


static void work_a_2536911233_3212880686_p_0(char *t0)
{
    char t25[16];
    char *t1;
    char *t2;
    unsigned char t3;
    unsigned char t4;
    char *t5;
    char *t6;
    char *t7;
    char *t8;
    char *t9;
    char *t10;
    unsigned char t11;
    unsigned char t12;
    unsigned char t13;
    unsigned char t14;
    unsigned char t15;
    unsigned char t16;
    char *t17;
    char *t18;
    char *t19;
    int t20;
    int t21;
    unsigned int t22;
    unsigned int t23;
    unsigned int t24;
    unsigned int t26;
    unsigned int t27;
    char *t28;

LAB0:    xsi_set_current_line(51, ng0);
    t1 = (t0 + 1192U);
    t2 = *((char **)t1);
    t3 = *((unsigned char *)t2);
    t4 = (t3 == (unsigned char)3);
    if (t4 != 0)
        goto LAB2;

LAB4:    t1 = (t0 + 992U);
    t4 = xsi_signal_has_event(t1);
    if (t4 == 1)
        goto LAB7;

LAB8:    t3 = (unsigned char)0;

LAB9:    if (t3 != 0)
        goto LAB5;

LAB6:
LAB3:    t1 = (t0 + 3432);
    *((int *)t1) = 1;

LAB1:    return;
LAB2:    xsi_set_current_line(52, ng0);
    t1 = xsi_get_transient_memory(3U);
    memset(t1, 0, 3U);
    t5 = t1;
    memset(t5, (unsigned char)2, 3U);
    t6 = (t0 + 3512);
    t7 = (t6 + 56U);
    t8 = *((char **)t7);
    t9 = (t8 + 56U);
    t10 = *((char **)t9);
    memcpy(t10, t1, 3U);
    xsi_driver_first_trans_fast(t6);
    xsi_set_current_line(53, ng0);
    t1 = (t0 + 3576);
    t2 = (t1 + 56U);
    t5 = *((char **)t2);
    t6 = (t5 + 56U);
    t7 = *((char **)t6);
    *((unsigned char *)t7) = (unsigned char)2;
    xsi_driver_first_trans_fast(t1);
    xsi_set_current_line(54, ng0);
    t1 = (t0 + 3640);
    t2 = (t1 + 56U);
    t5 = *((char **)t2);
    t6 = (t5 + 56U);
    t7 = *((char **)t6);
    *((unsigned char *)t7) = (unsigned char)2;
    xsi_driver_first_trans_fast_port(t1);
    goto LAB3;

LAB5:    xsi_set_current_line(56, ng0);
    t2 = (t0 + 1672U);
    t6 = *((char **)t2);
    t13 = *((unsigned char *)t6);
    t2 = (t0 + 1352U);
    t7 = *((char **)t2);
    t14 = *((unsigned char *)t7);
    t15 = ieee_p_2592010699_sub_2507238156_503743352(IEEE_P_2592010699, t13, t14);
    t16 = (t15 == (unsigned char)3);
    if (t16 != 0)
        goto LAB10;

LAB12:    t1 = (t0 + 1832U);
    t2 = *((char **)t1);
    t1 = (t0 + 2128U);
    t5 = *((char **)t1);
    t20 = *((int *)t5);
    t21 = (t20 - 2);
    t22 = (t21 * -1);
    t23 = (1U * t22);
    t24 = (0 + t23);
    t1 = (t2 + t24);
    t3 = *((unsigned char *)t1);
    t4 = (t3 == (unsigned char)2);
    if (t4 != 0)
        goto LAB13;

LAB14:    xsi_set_current_line(62, ng0);
    t1 = (t0 + 1672U);
    t2 = *((char **)t1);
    t3 = *((unsigned char *)t2);
    t1 = (t0 + 3640);
    t5 = (t1 + 56U);
    t6 = *((char **)t5);
    t7 = (t6 + 56U);
    t8 = *((char **)t7);
    *((unsigned char *)t8) = t3;
    xsi_driver_first_trans_fast_port(t1);

LAB11:    goto LAB3;

LAB7:    t2 = (t0 + 1032U);
    t5 = *((char **)t2);
    t11 = *((unsigned char *)t5);
    t12 = (t11 == (unsigned char)3);
    t3 = t12;
    goto LAB9;

LAB10:    xsi_set_current_line(57, ng0);
    t2 = xsi_get_transient_memory(3U);
    memset(t2, 0, 3U);
    t8 = t2;
    memset(t8, (unsigned char)2, 3U);
    t9 = (t0 + 3512);
    t10 = (t9 + 56U);
    t17 = *((char **)t10);
    t18 = (t17 + 56U);
    t19 = *((char **)t18);
    memcpy(t19, t2, 3U);
    xsi_driver_first_trans_fast(t9);
    xsi_set_current_line(58, ng0);
    t1 = (t0 + 1352U);
    t2 = *((char **)t1);
    t3 = *((unsigned char *)t2);
    t1 = (t0 + 3576);
    t5 = (t1 + 56U);
    t6 = *((char **)t5);
    t7 = (t6 + 56U);
    t8 = *((char **)t7);
    *((unsigned char *)t8) = t3;
    xsi_driver_first_trans_fast(t1);
    goto LAB11;

LAB13:    xsi_set_current_line(60, ng0);
    t6 = (t0 + 1832U);
    t7 = *((char **)t6);
    t6 = (t0 + 5828U);
    t8 = ieee_p_3620187407_sub_436279890_3965413181(IEEE_P_3620187407, t25, t7, t6, 1);
    t9 = (t25 + 12U);
    t26 = *((unsigned int *)t9);
    t27 = (1U * t26);
    t11 = (3U != t27);
    if (t11 == 1)
        goto LAB15;

LAB16:    t10 = (t0 + 3512);
    t17 = (t10 + 56U);
    t18 = *((char **)t17);
    t19 = (t18 + 56U);
    t28 = *((char **)t19);
    memcpy(t28, t8, 3U);
    xsi_driver_first_trans_fast(t10);
    goto LAB11;

LAB15:    xsi_size_not_matching(3U, t27, 0);
    goto LAB16;

}


extern void work_a_2536911233_3212880686_init()
{
	static char *pe[] = {(void *)work_a_2536911233_3212880686_p_0};
	xsi_register_didat("work_a_2536911233_3212880686", "isim/tb_juntar_isim_beh.exe.sim/work/a_2536911233_3212880686.didat");
	xsi_register_executes(pe);
}
