clararodellar/TFG/(commit log)

2018-10-02 Add stl
    [agarradera_eje_pieza_abajo_fijo_10b.stl]
2018-10-06 Add ULN2003 datasheet
    [agarradera_eje_pieza_abajo_fijo_10b.stl]
2018-10-11 Add datasheets and link to circuit
2018-11-28 Add stepper datasheet
2019-09-11 elimino carpeta para reorganizar
    [agarradera_8.FCStd, agarradera_8_abajo.stl, agarradera_8_arriba.stl, agarradera_eje_fijo_10.FCStd, agarradera_eje_pieza_abajo_fijo_10.stl, agarradera_eje_pieza_arriba_fijo_10.stl, agarradera_movil_6.stl, agarradera_movil_6_v01.FCStd]
2019-09-11 elimino la carpeta para reorganizar
    [board.brd, board.sch, pcb_smd_4.brd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]
2019-09-11 Electronica de control
2019-09-11 Electronica de potencia
    [schematic.brd, schematic.sch]
2019-09-13 nuevos codigos
    [juntar_pad.csv]
